DmitriyKalashnikov1/VKR/3d/Sopromat/ice_screenshot_20250330-104904.png

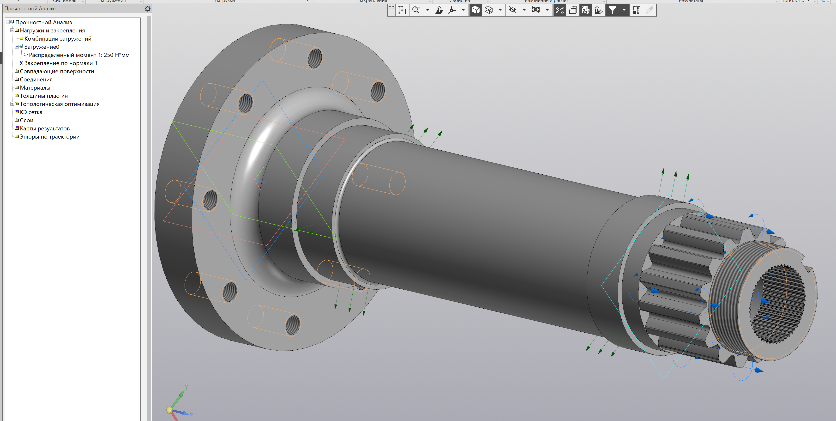
3d/Sopromat/ice_screenshot_20250330-104904.png
