DmitriyKalashnikov1/VKR/дополнительные ссылки.docx

1. Каталог моторов и приводов компании MaxsonMotors, - Режим доступа: https://www.maxongroup.com/maxon/view/catalog/, свободный (дата обращения: 22.10.23);
2. Каталог бесколлекторных моторов компании GoldenMotor, - Режим доступа: https://goldenmotor.ru/bldc-motors/motors/, свободный (дата обращения: 22.10.23);
3. Каталог мотор-колес на AliExpress, - Режим доступа: https://aliexpress.ru/wholesale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 (https://aliexpress.ru/wholesale?g=y&page=1), свободный (дата обращения: 22.10.23);
4. Описание товара ‘Комплект мотор-колесо Magic Pie-5, 16"’, - Режим доступа: https://goldenmotor.ru/motor-kolyosa/magic-pie-5/komplect-magic-pie-5-16inch/?oid=7175, свободный (дата обращения: 24.10.23);
5. Файл “Комплект мотор-колесо Magic Pie-5, 16" Руководство пользователя”, -- Режим доступа: https://goldenmotor.ua/files/Magic-Pie-5-Kit-Users-Guide_Rus_ver2.pdf, свободный (дата обращения: 24.10.23);
