DmitriyKalashnikov1/VKR/Литература-тау.docx

# Список использованной литературы и источников

1. Статистика ВОЗ «Инвалидность» [Электронный ресурс].- Режим доступа:https://www.who.int/ru/news-room/fact-sheets/detail/disability-and-health, свободный (дата обращения: 02.10.2023);
2. Статья «Инвалидность в России и в мире в цифрах» [Электронный ресурс].- Режим доступа: https://tiflocentre.ru/stati/statistika-po-invalidnosti.php, свободный (дата обращения: 02.10.2023);
3. Сайт Росстата [Электронный ресурс]. - Режим доступа: https://rosstat.gov.ru/folder/13964, свободный (дата обращения: 02.10.2023);
4. Статистика ВОЗ «Заболевания опорно-двигательного аппарата» [Электронный ресурс].- Режим доступа:https://www.who.int/ru/news-room/fact-sheets/detail/musculoskeletal-conditions, свободный (дата обращения: 02.10.2023);
5. Статистический сборник «ОСНОВНЫЕ ЭКОНОМИЧЕСКИЕ ПОКАЗАТЕЛИ ТРАНСПОРТА И СВЯЗИ», $2 “СОСТОЯНИЕ ЗДОРОВЬЯ НАСЕЛЕНИЯ”, табл. 2.67. [Электронный ресурс] – Режим доступа: https://rosstat.gov.ru/storage/mediabank/Zdravoohran-2021.pdf , свободный (дата обращения: 02.10.2023).
6. Сайт товаров для здоровья “medyard.ru” [Электронный ресурс]. - Режим доступа: https://medyard.ru/invalidnye-kolyaski/invalidnye-kolyaski-s-elektroprivodom/elektrokolyaski-stupenkokhody, свободный (дата обращения: 02.10.2023);
7. Сайт компании “Catewill” [Электронный ресурс]. – Режим доступа: https://caterwil.ru/product/ свободный (дата обращения: 02.10.2023);
8. Сайт компании “Обсервер” [Электронный ресурс]. – Режим доступа: https://o-mp.ru/ свободный (дата обращения: 02.10.2023);
9. Видео “Сравнение Caterwil Ultra 4WD и 4WD - Обзор электроколясок вездеходов” [Электронный ресурс]. - Режим доступа: https://www.youtube.com/watch?v=DE2Fb7_OeA0 , свободный (дата обращения: 02.10.2023);
10. Характеристики Caterwil Ultra 4WD [Электронный ресурс]. – Режим доступа: https://caterwil.ru/product/elektrokolyaska-caterwil-ultra-4wd/, свободный (дата обращения: 02.10.2023);
11. Характеристики Observer Проходимец [Электронный ресурс]. – Режим доступа: https://supportshop.ru/invalidnye-kolyaski-s-elektroprivodom/invalidnye-kolyaski-s-elektroprivodom-dlya-ulicy/kreslo-kolyaska-s-elektroprivodom-observer-prokhodimets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, свободный (дата обращения: 02.10.2023);
12. Обзор коляски Observer Проходимец [Электронный ресурс]. – Режим доступа: https://www.youtube.com/watch?v=gqXrreGPLkg, свободный (дата обращения: 02.10.2023);
13. Обзор коляски Caterwil GTS4 Lux [Электронный ресурс]. – Режим доступа: https://www.youtube.com/watch?v=uTOumZUHmyU, свободный (дата обращения: 02.10.2023);
14. Характеристики коляски Caterwil GTS4 Lux [Электронный ресурс]. – Режим доступа: https://caterwil.ru/product/kolyaska-transformer-caterwil-gts4/, свободный (дата обращения: 02.10.2023);
15. Видео “Противостояние колясок вездеходов Observer против Caterwil” [Электронный ресурс]. - Режим доступа: https://www.youtube.com/watch?v=-5qy4OKOLZg, свободный (дата обращения: 02.10.2023);
16. Официальный сайт компании “Ottobock” [Электронный ресурс]. - Режим доступа: https://corporate.ottobock.com/en/home, свободный (дата обращения: 02.10.2023);
17. Сайт товара “Otto Bock c1000 DS” в российском магазине-дистрибьюторе [Электронный ресурс]. - Режим доступа: https://ottobock-mobility.ru/catalog/adult-wheelchairs/kresla-kolyaska-s-elektroprivodom/c1000ds-invalidnaya-kolyaska-s-elektroprivodom/, свободный (дата обращения: 02.10.2023);
18. Видео “Обзор на электро-коляску OTTO bock C1000 DS” [Электронный ресурс]. - Режим доступа: https://www.youtube.com/watch?v=i4LTlZDc5MA, свободный (дата обращения: 02.10.2023);
19. Видео “Отзыв Otto Bock c1000 DS” [Электронный ресурс]. - Режим доступа: https://www.youtube.com/watch?v=z9F7g4K-WkQ, свободный (дата обращения: 02.10.2023);
20. Сайт товара “Otto Bock Juvo B5” в российском магазине-дистрибьюторе [Электронный ресурс]. - Режим доступа: https://ottobock-mobility.ru/catalog/adult-wheelchairs/kresla-kolyaska-s-elektroprivodom/invalidnaya-kolyaska-s-elektroprivodom-juvo-konfiguratsiya-b5/, свободный (дата обращения: 02.10.2023);
21. Видео “Наконец то я ее дождался! Ottobock juvo b5 в конфигурации InvaТема!” [Электронный ресурс], - Режим доступа: https://www.youtube.com/watch?v=Ajn11AZVl4Q, свободный (дата обращения: 02.10.2023);
22. Видео “ Моя новая основная электроколяска Ottobock juvo B5” [Электронный ресурс], - Режим доступа: https://www.youtube.com/watch?v=LtA1TSr9jB8, свободный (дата обращения: 02.10.2023);
23. Раздел “О компании” сайта компании “Orctonica” [Электронный ресурс], - Режим доступа: https://ortonica.ru/company/, свободный (дата обращения: 02.10.2023);
24. Раздел “Электрические коляски” сайта компании “Orctonica” [Электронный ресурс], - Режим доступа: https://ortonica.ru/catalog/invalidnye_kolyaski/elektricheskie-kolyaski/, свободный (дата обращения: 02.10.2023);
25. Страница товара “Orctonica Pulse 270” [Электронный ресурс], - Режим доступа: https://ortonica.ru/catalog/invalidnye_kolyaski/elektricheskie-kolyaski/1414/, свободный (дата обращения: 02.10.2023);
26. Страница товара “Ortonica Pulse 770” [Электронный ресурс], - Режим доступа: https://ortonica.ru/catalog/invalidnye_kolyaski/elektricheskie-kolyaski/536/, свободный (дата обращения: 02.10.2023);
27. Видео-обзор “ELECTRIC WHEELCHAIR Тест Ortonica Pulse 770 (Зимние условия)” [Электронный ресурс], - Режим доступа: https://www.youtube.com/watch?v=iNUhCidfzpY, свободный (дата обращения: 02.10.2023);
28. Видео-обзор “ELECTRIC WHEELCHAIR Тест Ortonica pulse 770 Дополнение” [Электронный ресурс], - Режим доступа: https://www.youtube.com/watch?v=7Ww4NHx1mHw, свободный (дата обращения: 02.10.2023);
29. Видео-обзор “Электроколяска на независимой подвеске Тест Caterwil Ultra”, - Режим доступа: https://www.youtube.com/watch?v=wiukjdVkpcY, свободный (дата обращения: 14.10.2023);
30. Справочник коэффициентов трения качения для разных материалов, - Режим доступа: https://dpva.ru/Guide/GuidePhysics/Frication/FrictionOfRolling/, свободный (дата обращения: 071123);
31. Каталог моторов Fulling motor на сайте поставщика Inodrive, - Режим доступа: https://innodrive.ru/catalog/fulling-motor/, свободный (дата обращения: 101123);
