DmitriyKalashnikov1/VKR/Мат моделирование/Расчет и подбор электродвигаттеля полный для мальчикова — копия.docx

МИНОБРНАУКИ РОССИИ

Федеральное государственное бюджетное образовательное

учреждение высшего профессионального образования

«Юго-Западный государственный университет»

(ЮЗГУ)

Кафедра механики, мехатроники и робототехники

Мощностной и проверочный расчет электропривода

мехатронного устройства

Вариант 7

Выполнил: cт.гр. МТ11-Б Калашников Д. А.

Проверил: доц. Мальчиков А. В.

Курск 2023

Для того, чтобы рассчитать мощность электродвигателей сначала нужно выбрать из всех режимов работы устройства самый нагруженный. Самый нагруженный режим работы для коляски это режим прямолинейной езды. Для расчета данного режима упростим коляску до модели колеса, катящегося вперед со скоростью из ТЗ (5-10 км/ч). Расчетная схема этого режима показана на рис.1.


Рис.1. Расчетная сила основного режима

Составим уравнения динамики относительно центра колеса:

{, mx=Ftr, J_o φ=Md-Mtrc-Ftr*R. (2.1)

В последней формуле: Mtrc – момент трения скольжения (находится как Mtrc=mg*δ , где δ – коэффициент трения скольжения – 0.01 м в нашем случае [30], m—масса коляски (200 кг)), R – радиус колеса (0.15 м в нашем случае), ε=φ=x/R – угловое ускорение колеса, mk – масса колеса, J_o – момент инерции относительно центра колеса.

По ТЗ линейная максимальная скорость коляски составляет 10 (км)/ч . Пересчитывая это в метры в секунду получим u=2.778 м/c линейной скорости. Разделив это на радиус колеса найдем его угловую скорость ω=18.519 (рад)/с . Время разгона возьмем t=5 c . Значит угловое ускорение составит ε=ω/t=3.7 (рад)/(c^2) . Массу колеса mk примем 1 кг. Момент инерции относительно центра колеса найдем так: J_o =(mk*r^2)/2.

Учитывая все эти данные, найдем момент силовой установки:

J_0 φ=Md-mg*δ-mxr; (2.2)
Md=0.5mk*r^2 φ+mg*δ+mxr. (2.3)

Откуда:

Md=0.5*1*0.15^2 *3.7+2000*0.01+200*2.778/5*0.15=36.7 (Н*м).

Зная теперь момент силовой установки и угловую скорость колеса, найдем нужную расчетную мощность:

Nd=Md*ω=680.17 (Вт).

Учтя коэффициент запаса мощности 1.2 и КПД передачи в 0.65 посчитаем реальную требуемую мощность силовой установки коляски:

Ndreal= 1.2(Nd)/0.65=1256 (Вт).

Зная мощность силовой установки всей коляски, найдем мощность одного мотора, разделив Ndreal на количество моторов – 6:

Nm=(Ndreal)/6=209.28 (Вт).

Проверим хватит ли это мощности для заезда на пандусы с углом наклона 30⁰. Расчетная схема для этого показана на рис. 2.


Рис.2. Расчетная схема для подъема по пандусам

Составим уравнения динамики относительно центра колеса:

{, mx=Ftr-mgsin(a), J_o φ=M-Mk-Ftr*R. (2.4)

В формуле (2.4) α – угол подъема пандуса. Mk – момент трения ( Mk=mgcos(a)*δ ), М—момент двигателя. Выразив силу трения из первого уравнения (2.4) получим:

Ftr=mx+mgsin(a). (2.5)

Подставив (2.5) во второе уравнение (2.4) и выразив оттуда момент электродвигателя, получаем:
M=J_o φ+mgcos(a)*δ+(mx+mgsin(a))R. (2.6)

По ТЗ линейная скорость коляски в данном режиме составляет 0.5 (км)/ч . Пересчитывая это в метры в секунду получим u=x=0.14 м/c линейной скорости. Разделив это на радиус колеса найдем его угловую скорость ω=0.93 (рад)/с . Время разгона возьмем t=5 c . Значит угловое ускорение составит ε=ω/t=φ=0.028 (рад)/(c^2) . Массу колеса mk примем 1 кг. Момент инерции относительно центра колеса найдем так: J_o =(mk*r^2)/2. Угол подъема пандуса по ТЗ α=30° .

Учитывая все эти данные, найдем момент силовой установки:
M=0.5*1*0.15^2 *0.028+2000*0.01*cos(α)+(200*0.14+2000*sin(α))*0.15=168.2 (Н*м) . (2.7)

Умножив найденный момент на номинальную угловую скорость этого режима, найдем расчетную мощность силовой установки в данном режиме:

N=M*ω=155.7 (Вт).

Учтя коэффициент запаса мощности 1.2 и КПД передачи в 0.65 посчитаем реальную требуемую мощность силовой установки коляски:

N_real= 1.2N/0.65=288 (Вт).

Зная мощность силовой установки всей коляски, найдем мощность одного мотора, разделив N на количество моторов – 6:

N1=(N_real)/6=48 (Вт).

N1<Nm , значит мощности, рассчитанной для прямолинейной езды хватит

(да еще и с лихвой) для подъема на расчетный угол пандуса.

Учитывая, что найденный M – момент силовой установки, найдем момент, приходящийся на один двигатель:

M1=M/6=28 (Н*м).

Расчет мощности двигателя подъема шасси будем производить в режиме подъема на ступеньку в транспорт. В этом режиме требуется поднять центральные колеса. Примем допущение, что переднее колесо прочно зацепилось за край ступени. Расчетная схема для этого режима показана на рис.3.

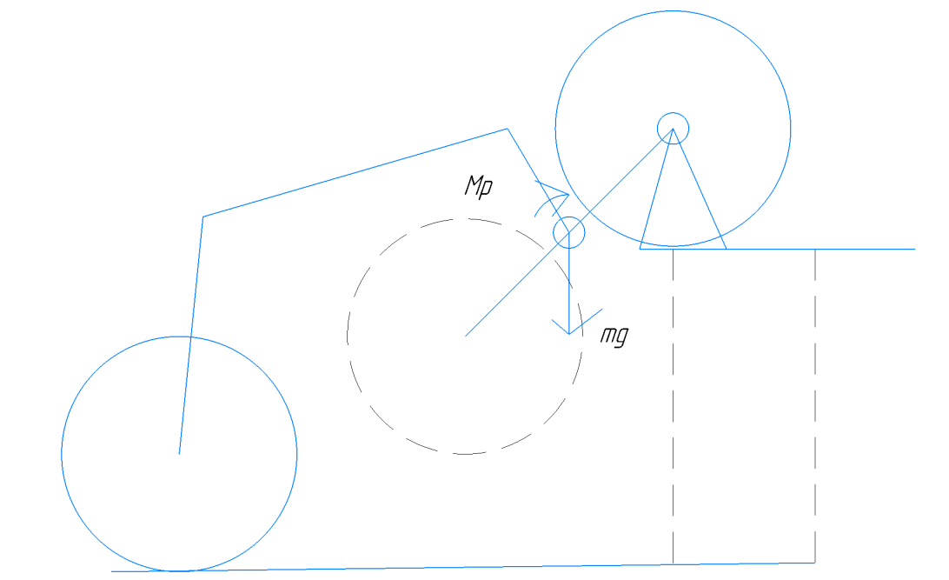
[picture p8: figure]

Рис.3. Схема расчета мощности мотора поднятия шасси

Составим сумму моментов относительно края ступеньки (по факту получим, что мотору подъемника шасси надо поднять половину веса на половине длинны балки между колесами):

Mp=0.25*l1*mg,

, где l1 = 375 мм – длина балки между колесами передней шасси.

Подставив значения, получим:

Mp=0.25*0.375*2000=187.5 (Н*м).

Зная этот момент и нужную угловую скорость для подъема ( ω=0.1 рад/c ), найдем нужную мощность:

Np=Mp*ω=18.75 (Вт).

С учетом коэффициента запаса 1.2 и КПД передачи в 0.35, рассчитаем итоговую мощность данного двигателя:

Npreal=1.2(Np)/0.35=64.3 (Вт).

Момент на один двигатель для данного режима Mp1=(Mp)/2=93,75 (Н*м).

По номинальному моменту для мотора колес нам подходит мотор из каталога фирмы Fulling motors. Внешний вид этого мотора показан на рис.4, а его параметры показаны в Табл.2.1.

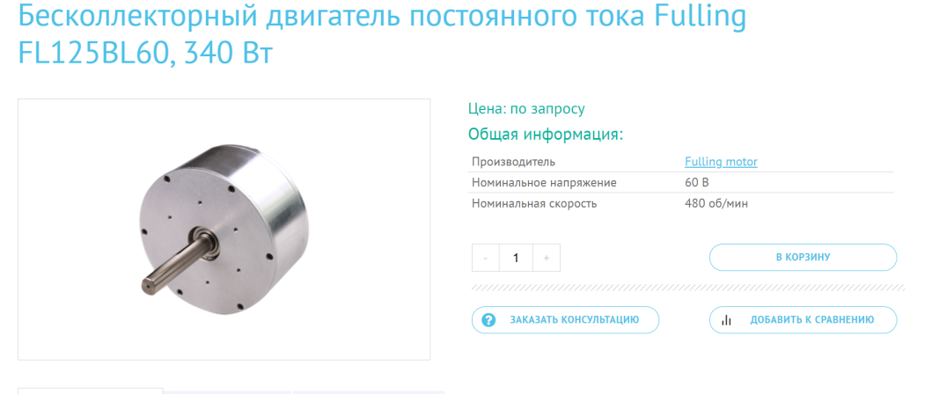
[picture p9: figure]

Рис. 4. Мотор колес

Табл.2.1. Параметры двигателя колес

Параметр (обозначение) | Значение
Сопротивление якоря ( R_я ) | 1.1 Ом
Индуктивность якоря ( L_я ) | 2.4* 10^(-3) Гн
Момент инерции двигателя (J) | 0.00021 Кг* м^2
Номинальное напряжение ( U_н ) | 60 В
Номинальная угловая скорость ( ω_н ) | 480 rpm = 50.2 (рад)/с
Номинальный крутящий момент ( M_н ) | 6 .8 Н*м
Номинальный ток ( I_н ) | 5.7 А
C_m | 1.19 (Н*м)/А
C_e | 1.2 (В*с)/(рад)

Для подъемного механизма шасси был выбран привод AK80-64 6-8S от компании Tmotor. Внешний вид этого двигателя показан на рис. 5, а параметры данного двигателя показаны в Табл. 2.2.


Рис.5. Мотор для механизма подъема шасси

Табл.2.2. Параметры двигателя подъема шасси

Параметр (обозначение) | Значение
Сопротивление якоря ( R_я ) | 0.22 Ом
Индуктивность якоря ( L_я ) | 0.86* 10^(-3) Гн
Момент инерции двигателя (J) | 0.0001335 Кг* м^2
Номинальное напряжение ( U_н ) | 24 В
Номинальная угловая скорость ( ω_н ) | 23 rpm = 2.4 (рад)/с
Номинальный крутящий момент ( M_н ) | 48 Н*м
Пиковый крутящий момент ( M_(max) ) | 120 Н*м
Номинальный ток ( I_н ) | 19 А
C_m | 4.9 (Н*м)/А
C_e | 10 (В*с)/(рад)

Номинальные параметры скоростей вращения и выдаваемого момента у двигателя колеса не соответствуют требуемым, поэтому необходимо подобрать соответствующие редуктор.

Рассчитаем нужное передаточное отношение редуктора:

i=50/18.5=2.7

После поиска на сайте компании Инодрайв был найден следующий редуктор (Рис. 6):

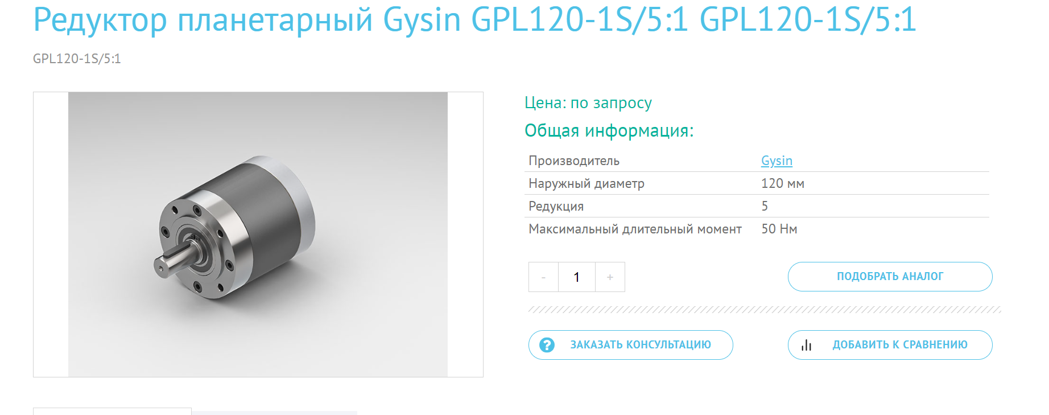
[picture p10: figure]

Рис.6. Колесный редуктор

Его параметры: i_r =5;M_n =50 Н*м; η=0.9. Проверим, будут ли соответствовать параметры движения расчетным:
M^(') =M_(дв) *i*η=6.8*5*0.9=30,6; ω^(') =(ω_н)/5=10.04(рад)/c.

Полученная угловая скорость меньше расчетной, что позволит коляске развивать скорость всего 5-6 км в час, это меньше планируемой скорости, но такая скорость еще проходит в условия ТЗ, поэтому, поскольку полученный момент больше чем момент подъема на пандус M1, результаты выбора и расчетов удовлетворительны.
