DmitriyKalashnikov1/VKR/Мат моделирование/Глава 4 тау блок формирования задающих воздействий.docx

# 4. Алгоритм блока формирования задающих воздействий

Алгоритм блока формирования задающих воздействий разделен на две крупные части: ручное управление с автоматическим детектированием препятствий при обычной езде, а также режим заезда в общественный транспорт. Рассмотрим каждый режим более подробно.

Первым рассмотрим режим ручного управления. Так как у нас относительно малое число колес (всего 6), то удобнее всего будет использовать танковую схему управления, при которой φ_1 =φ_2 =φ_3 =φ_r , φ_4 =φ_5 =φ_6 =φ_l (рис. 4.1).

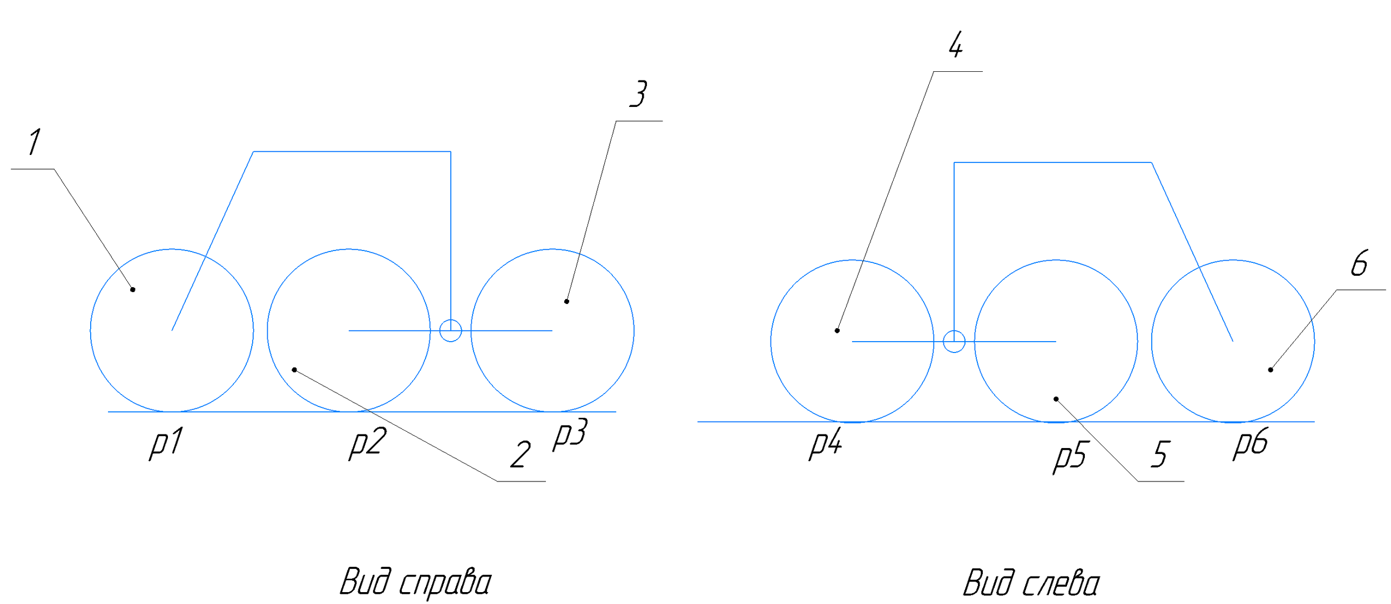
[picture p11: figure]

Рис.4.1. Звенья механизма, участвующие в режиме работы 1

При условии отсутствия проскальзывания в точках контакта колес ( v_(p_i) =0;i=1 .. 6 ), моменты на электродвигателях колес равны ( M_(d1) =M_(d2) =M_(d3) =M_(dr) ; M_(d4) =M_(d5) =M_(d6) =M_(dl) ), и динамика робота описывается двумя уравнениями (2.2) для левой и правой сторон робота:

{, J_0 φ_l =M_(dl) -0.5mg*δ-0.5mx_l r, J_0 φ_r =M_(dr) -0.5mg*δ-0.5mx_r r (4.1)

, где δ – коэффициент трения скольжения – 0.01 м в нашем случае [30], m—масса коляски (200 кг)), r – радиус колеса (0.15 м в нашем случае), ε=φ=x/R – угловое ускорение колеса, J_o – момент инерции относительно центра колеса (находится по формуле J_o =(mk*r^2)/2 , где mk – масса колеса).

В формуле (4.1) входными параметрами (с учетом того, что φ_l =(x_l)/r ), является вектор линейных скоростей колес [x_r x_l ] , который связан с передвижением устройства с помощью уравнений кинематики робота с дифференциальным приводом. Чтобы иметь возможность по заданной ориентации робота в пространстве находить необходимый вектор скоростей, сначала решим задачу прямой кинематики (выведем формулы для нахождения ориентации по заданным скоростям колес), а после найдем выражения, которые позволят по ориентации находить скорости колес.

Введем допущение, что движение робота происходит в двумерной плоскости по ровной поверхности, тогда местонахождение и направление движение робота с дифференциальным приводом в глобальной системе координат задается вектором [x_a y_a θ] , так как это показано на рис.4.2.

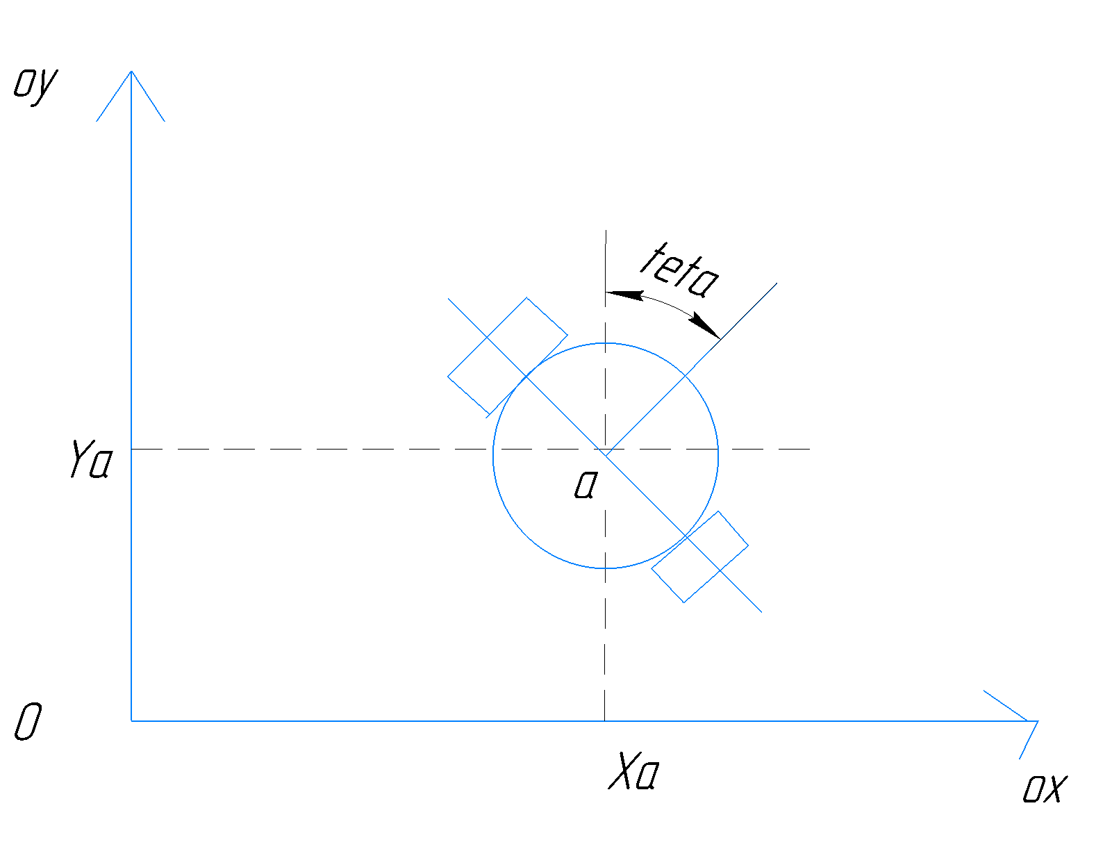
[picture p12: figure]

Рис.4.2. Обозначение положения и направления робота в глобальной системе координат

На рис. 4.2 x_a – координата центра масс а робота по оси ox, y_a – координата центра масс а робота по оси оy, θ – направление движения робота.

Чтобы обеспечивать желаемое направление движения, робот должен будет поворачивать вокруг особой точки, находящейся на оси, совпадающей с осью вращения ведущих колес. Эта точка находится за пределами робота и называется мгновенным центром кривизны траектории (instantaneous center of curvature или ICC). Поворот будет осуществляться с некоторой угловой скоростью ω . Расчетная схема данной угловой скорости и радиуса кривизны траектории робота R_t показана на рис.4.3.

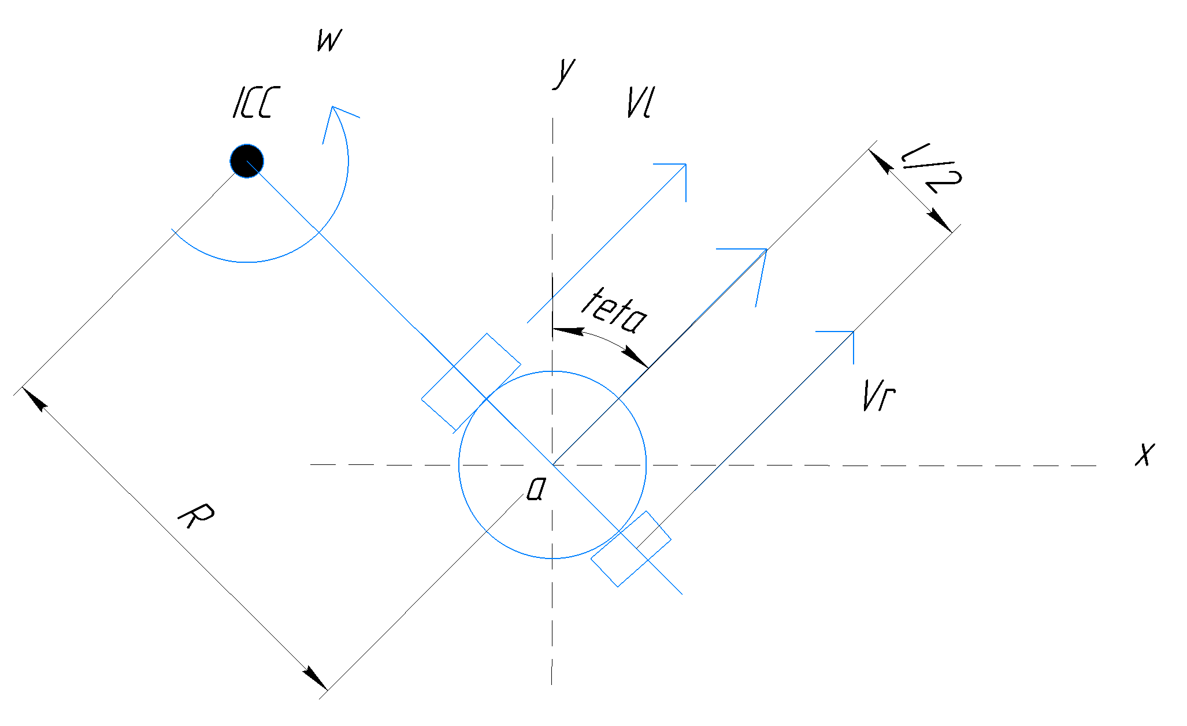
[picture p13: figure]

Рис. 4.2. Расчетная схема для угловой скорости поворота и радиуса кривизны траектории

На данной схеме l – длина оси колес, а R=R_t – радиус кривизны траектории, то есть расстояние между центром робота и точкой ICC.

Применив уравнение связи между линейной и угловой скоростями получим следующую систему выражений для скорости поворота робота:

{, ω(R+l/2)=Vr, ω(R-l/2)=Vl. (4.2)

Преобразовав выражение (4.2), получим систему для определения угловой скорости поворота и радиуса кривизны траектории:

{, R_t =l/2*(Vl+Vr)/(Vr-Vl), ω=(Vr-Vl)*l. (4.3)

Уравнения из систем (4.2) и (4.3) нам нужны для вывода формул для определения положения робота и его направления по скоростям его колес. Предположим, что робот движется с некоторой угловой скоростью в течение Δt секунд (рис.4.3).

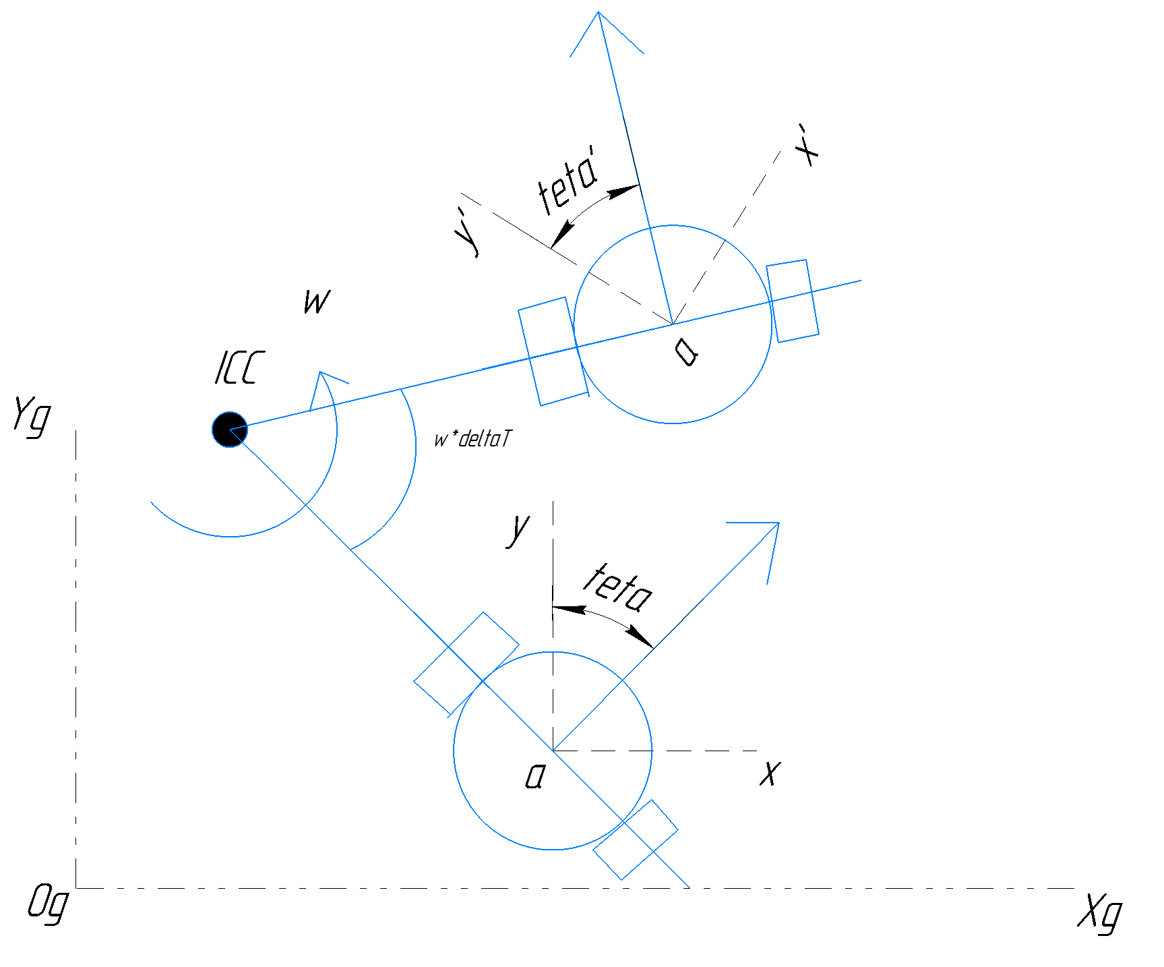
[picture p14: figure]

Рис.4.3. Поворот робота вокруг точки ICC за время Δt в глобальных координатах (Xg, Yg)

По рис.4.3 видно, что новое направление движения робота θ' будет находится так:

θ^(') =θ+ω*Δt . (4.4)

Положение точки ICC описывается следующим вектором:

ICC=[ICC_x ICC_y ]=[x-Rsinθy+Rcosθ] . (4.5)

С учетом стартовой позиции (x, y) новое положение робота (x’, y’) может быть получено с помощью 2D-матрицы вращения. Учитывая движение робота с угловой скоростью ω в течение Δt секунд относительно точки ICC, мы получаем следующую позицию для времени t+ Δt :

(x^(') y^(') )=(cos(ωΔt), -sin(ωΔt)sin(ωΔt), cos(ωΔt))(x-ICC_x y-ICC_y )+(ICC_x ICC_y ). (4.6)

Если мы еще добавим в вектор (4.6) выражение для нахождения нового направления движения (4.4), то получим такую векторно-матричную формулу нахождения вектора нового положения робота:

(x^(') y^(') θ^(') )=(cos(ωΔt), -sin(ωΔt), 0sin(ωΔt), cos(ωΔt), 00, 0, 1)(x-ICC_x y-ICC_y θ)+(ICC_x ICC_y ωΔt) (4.7)

Подставляя в выражение (4.7) значения ω, R, ICC из выражений (4.3) и (4.5), мы сможем по текущей линейной скорости колес найти текущее положение робота и направление движения. Надо еще сказать, что измерять требуемую линейную скорость достаточно проблематично, поэтому в реальном устройстве эти данные будут вычисляться по показаниям энкодеров, установленных во всех приводах робота, по такой формуле:

V=(n*step)/(Δt) (4.8)

, где n – количество импульсов энкодера, поступивших за время Δt , step – длина дуги одного шага энкодера.

Таким образом, выражения (4.3), (4.5), (4.7) и (4.8) образуют модель прямой кинематики рассматриваемого режима.

Теперь, зная формулы для прямой кинематики, найдем выражения для обратной. Для этого нужно преобразовать выражение (4.7), выполнив в нем все арифметические операции:

(x^(') y^(') θ^(') )=(cos(ωΔt), -sin(ωΔt), 0sin(ωΔt), cos(ωΔt), 00, 0, 1)(x-ICC_x y-ICC_y θ)+(ICC_x ICC_y ωΔt)= (cos(ωΔt)*(x-ICC_x )-sin(ωΔt)*(y-ICC_y )sin(ωΔt)*(x-ICC_x )+cos(ωΔt)(y-ICC_y )θ)+(ICC_x ICC_y ωΔt)= (cos(ωΔt)*(x-ICC_x )-sin(ωΔt)*(y-ICC_y )+ICC_x sin(ωΔt)*(x-ICC_x )+cos(ωΔt)(y-ICC_y )+ICC_y θ+ωΔt). (4.9)

Следующим шагом подставим выражение для определения вектора ICC (4.5):

(x^(') y^(') θ^(') )=(-cos(ωΔt)*(Rsinθ)-sin(ωΔt)*(Rcosθ)+x-Rsinθ-sin(ωΔt)*(Rsinθ)+cos(ωΔt)(Rcosθ)+y+Rcosθθ+ωΔt). (4.10)

Мы получили рекуррентные выражения для определения нового вектора положения робота с учетом его положения в прошлый момент времени, а также расстояния R до точки ICC и угловой скорости поворота робота вокруг точки ICC ω . А эти величины в свою очередь позволят в свою очередь с помощью формул (4.2) определить искомые Vl, Vr . Для того, чтобы выразить ω, R , вычтем из текущего положения робота ( x’, y’, θ' ) его положение в предыдущий отрезок времени ( x, y, θ ):

{, (x’-x)=-cos(ωΔt)*(Rsinθ)-sin(ωΔt)*(Rcosθ)-Rsinθ, (y’-y)=-sin(ωΔt)*(Rsinθ)+cos(ωΔt)(Rcosθ)+Rcosθ, (θ^(') -θ)=ωΔt. (4.11)

Уравнение 3 из системы (4.11) легко позволяет получить искомую угловую скорость поворота робота:

ω=((θ^(') -θ))/(Δt). (4.12)

C учетом выражения (4.12), оставшиеся два выражения в (4.11) можно будет перезаписать в таком виде:

{, (x’-x)=-cos(θ^(') -θ)*(Rsinθ)-sin(θ^(') -θ)*(Rcosθ)-Rsinθ, (y’-y)=-sin(θ^(') -θ)*(Rsinθ)+cos(θ^(') -θ)(Rcosθ)+Rcosθ. (4.13)

Найти радиус кривизны траектории R из одного из двух уравнений (4.13) (например, из уравнения для у-ов) не составит труда:

R=((y’-y))/(cos(θ^(') -θ)cos(θ)+cos(θ)-sin(θ^(') -θ)*sin(θ)) (4.14)

Подставив уравнения (4.12) и (4.14) в выражения (4.2) получим искомые зависимости линейных скоростей колес от положений робота в настоящий момент времени ( x, y, θ ), желаемого положения робота в следующий момент времени ( x', y^(') , θ' ), геометрических параметров робота и отрезка времени Δt , за который робот должен совершить перемещение из ( x, y, θ ) в ( x', y^(') , θ' ):

V_r (x, y, θ,x^(') , y^(') , θ^(') , l, Δt)= =((θ^(') -θ))/(Δt)*(((y’-y))/(cos(θ^(') -θ)cos(θ)+cos(θ)-sin(θ^(') -θ)*sin(θ))+l/2); (4.15)

V_l (x, y, θ,x^(') , y^(') , θ^(') , l, Δt)= =((θ^(') -θ))/(Δt)*(((y’-y))/(cos(θ^(') -θ)cos(θ)+cos(θ)-sin(θ^(') -θ)*sin(θ))-l/2). (4.16)

Подставив уравнения (4.15) и (4.16) в выражения из (4.2), можно найти суммарные моменты двигателей для каждой из сторон робота ( M_(dl) , M_(dr) ), который требуются для достижения необходимой скорости. Разделив значение суммарного момента для одной стороны на 3, получим моменты, требуемые от каждого двигателя одной стороны ( M_i ;i=1..6 ). А зная M_i ;i=1..6 и номинальную мощность одного двигателя колес (рассчитанную в разделе 2), можно легко найти желаемые угловые скорости каждого колеса ω_i^(') ;i=1..6 , которые затем подаются на локальные контуры управления угловыми скоростями вращения двигателей, согласно рис.3.2.

Таким образом мы вывели уравнения ((4.2), (4.16)), с помощью которых по местоположению робота и его направлению можно высчитать необходимые параметры для двигателей. Осталось только понять, как с помощью джойстика задавать желаемое перемещение.

Рассмотрим сначала схемы конструкции джойстика и проекции рабочей области рукояти на плоскость Oxy (рис.4.4).

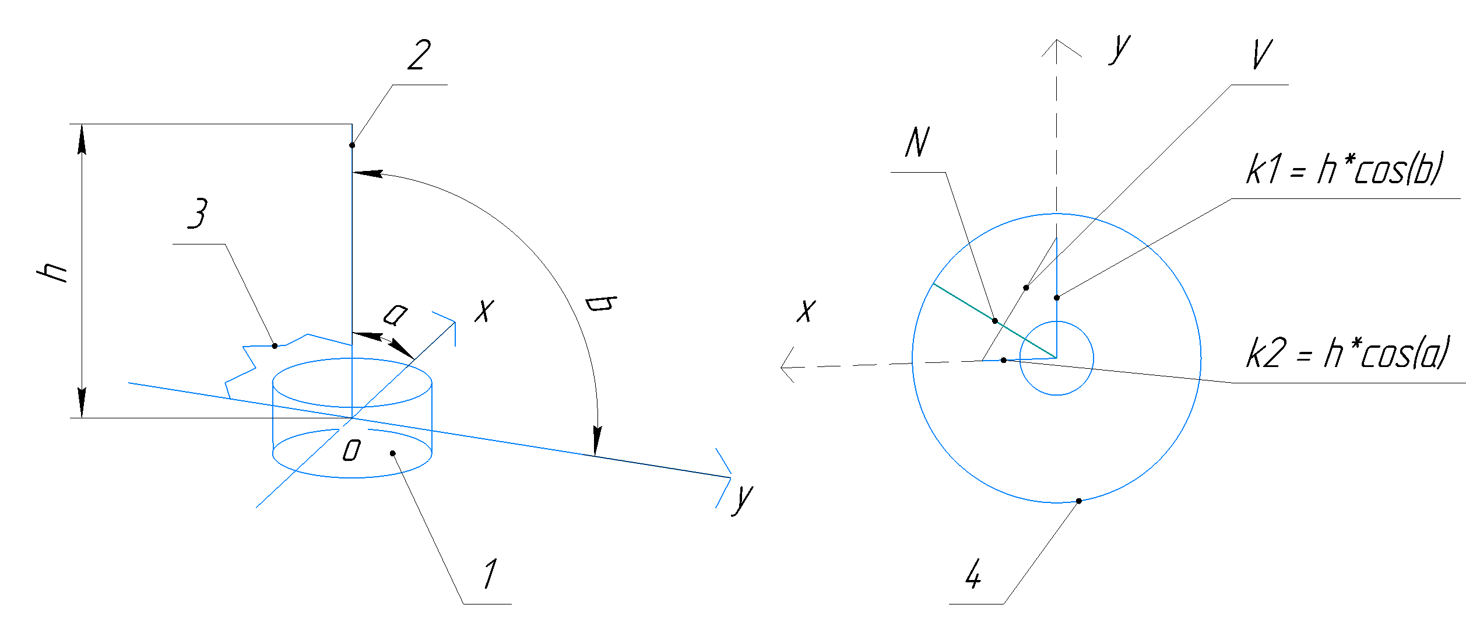
[picture p15: figure]

Рис.4.4. Схема конструкции джойстика и проекции рабочей области на плоскость Oxy

На рис.4.4 1 – основание джойстика, 2 – рукоять джойстика, 3 – возвратная пружина, k1 – проекция положения джойстика на ось Y, k2 – проекция положения джойстика на X, V – гипотенуза прямоугольного треугольника с катетами k1 и k2, N – радиус-вектор нового желаемого положения робота, α, β – углы отклонения джойстика от вертикали, h – высота джойстика.

Желаемое положение робота рассчитывается так:

1) Вычисляются две проекции ориентации джойстика на оси X и Y:

OX:k2=h*cos(α); (4.17) OY:k1=h*cos(β); (4.18)

2) Вычисляются гипотенуза V, а также угол между ней и проекцией на ось X:

V=√(k1^2 +k2^2); (4.19) γ=arccos(k2)/V; (4.20)

3) Найденный угол γ суммируется с углом ориентации робота θ и таким образом получается желаемая ориентация робота

θ^(') =θ+γ ; (4.21)

4) Вычисляем желаемые координаты x^(') , y' так:

x^(') =x+k1; (4.22) y^(') =y+k2; (4.23)

Таким образом, по формулам (4.17) – (4.23) рассчитывается вектор желаемого положения (x^(') y^(') θ^(') ) робота из вектора ориентации джойстика (αβ) .

А дальше вычисленный вектор желаемого положения подставляется в формулы ((4.1), (4.16)), из которых высчитываются параметры движения, подаваемые на приводы. Осталось только сказать, что САУ робота постоянно получает данные о расстояниях до препятствий с передней камеры, и если минимальное считанное расстояние будет меньше 200 мм, то, независимо от поступивших команд, вперед робот не поедет.

Теперь рассмотрим режим № 2, режим заезда на ступеньку в транспорт. Сначала рассмотрим полный алгоритм заезда (рис.4.5).

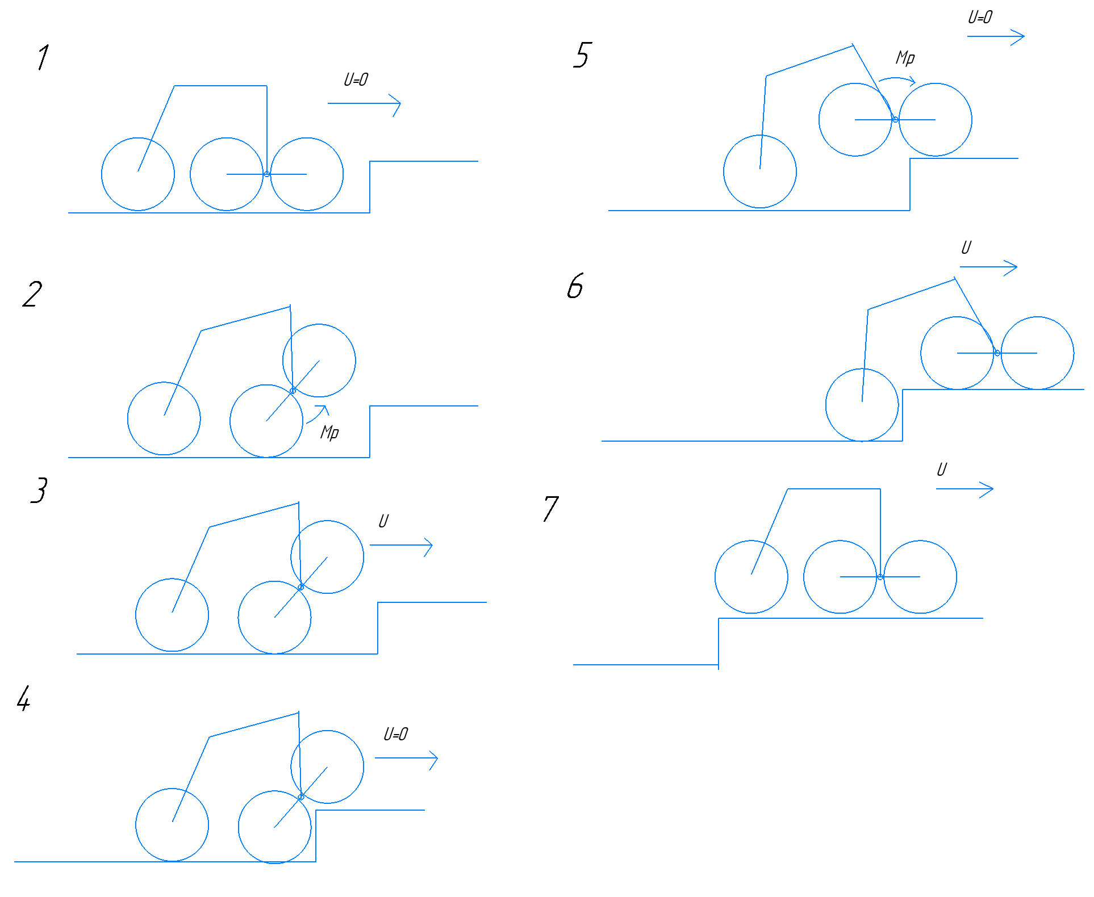
[picture p16: figure]

Рис.4.5. Алгоритм заезда в транспорт

На рис.4.5. позиция (1) обозначает подъезд робота ко входу в транспорт, на шаге (2) оператор останавливает движение робота и переводит тумблер управления подвеской в положение подъема передних колес, на шаге (3) оператор ближе подъезжает к ступеньке, так, чтобы переднее колесо находилось над ступенькой, на шаге (4) оператор останавливает движение робота, на шаге (5) оператор переводит с помощью тумблера управления подвеской выводит переднее шасси в горизонтальное положение, на шаге (6) робот под управлением оператора заезжает центральными колесами на ступеньку, на последнем шаге (7) робот, продолжая двигаться вперед, затягивает задние колеса на ступеньку.

На шагах (1), (6), (7) остается рабочей та математическая модель робота, сформированная формулами (4.1)-(4.23).

На шаге (2) кинематики нет, потому что робот стоит, а вся динамика сводится к расчетной формуле момента Mp:

Mp=0.25*l1*mg*sinφ_7 , (4.24)

где φ_7 – угол подъема шасси, l1 – длина балки между передними колесами.

Шаги (3), (4) и (5) характеризуется объединением формул (4.1)-(4.24), угол φ_7 можно будет задавать углом β при отсутствии движения коляски (и при соответствующем положении переключателя поведения шасси).

Схематичное изображение описанного выше алгоритма управления многоканальной САУ показано на рис. 4.6.

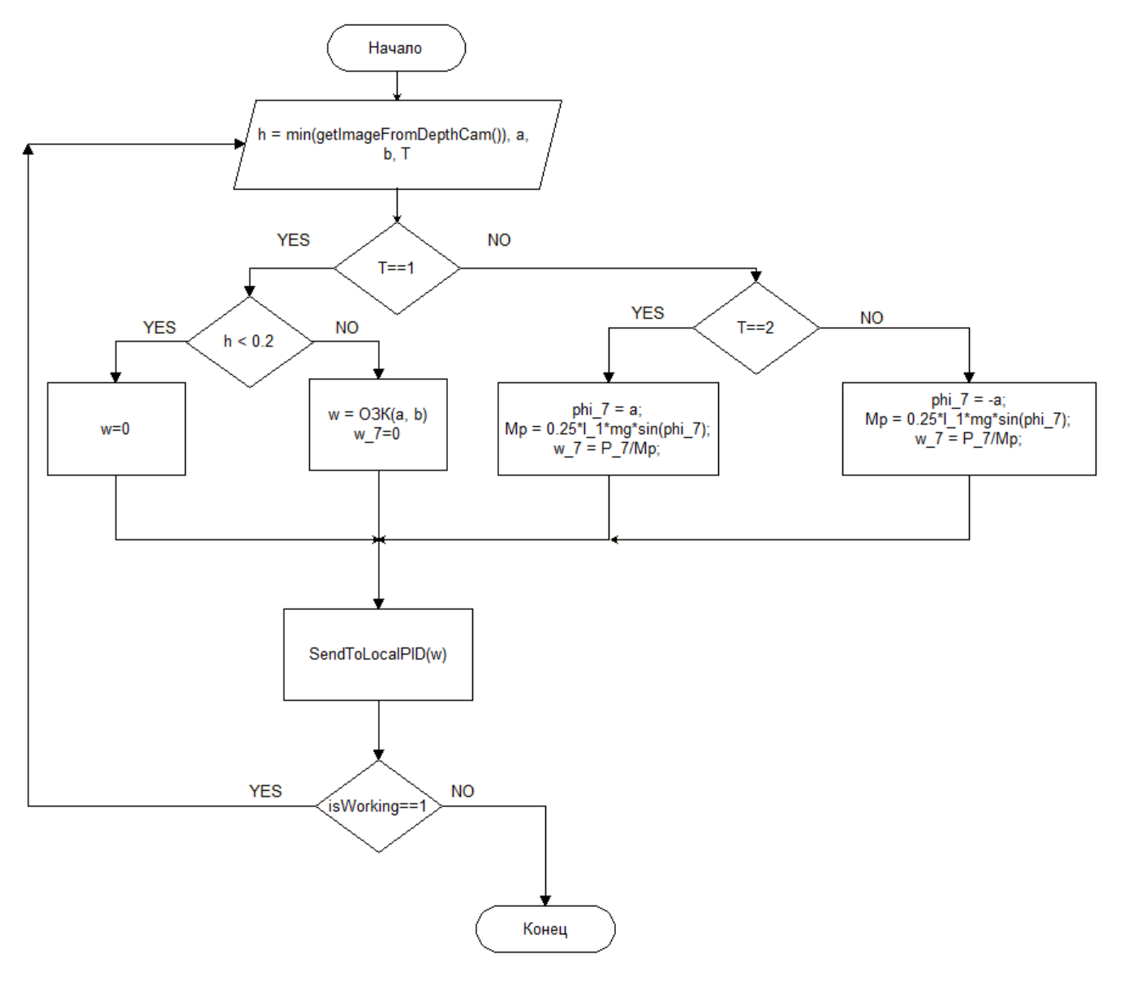
[picture p17: figure]

Рис.4.6. Блок-схема алгоритма управления многоканальной САУ

На данной схеме h – расстояние до препятствия, считанное с помощью getImageFromDepthCam() – функции получения карты расстояний с установленной спереди камеры глубины. Реализация данной функции зависит от выбранной камеры, поэтому ее в данной главе не рассматриваем. α и β – углы положения джойстика. Функция ОЗК(α,β) – функция, которая из углов положения джойстика по формулам (4.1)-(4.23) переводит считанные α и β в угловые скорости колес, а функция SendToLocalPID(ω) передает вычисленные значения угловых скоростей в локальные управляющие контуры всех приводов. Флаг isWorking показывает, включена ли еще коляска. Переменная T отвечает за показания тумблера переключения режима работы подвески шасси. P_7 – константа мощности двигателя подъема шасси.

Таким образом, в этой главе была выведена полная математическая модель робота, позволяющая описать движение робота, как при ручном управления, так и при траекторном методе управления. Также был подробно описал алгоритм работы блока формирования задающих воздействий, работающий поверх разработанной математической модели данного робота и составлена блок-схема данного алгоритма.

# Заключение

В данной курсовой работе была разработана система автоматического управления приводами роботизированной инвалидной коляски, удовлетворяющая параметрам, заданным в техническом задании. Были приведены функциональная и структурная схемы САУ, была проведена проверка на устойчивость по методам Найквиста, Михайлова и Гурвица, определен запас устойчивости по диаграммам Боде. Также была проведена оптимизация PID – регулятора САУ, как линейной, так и нелинейной. Кроме этого, САУ была исследована на робастность. Также был успешно настроен нечеткий регулятор для одного из типов приводов. Была рассмотрена многоканальная САУ, сформирована полная математическая модель данного робота, описывающая его передвижение во всех предусмотренных ТЗ режимах работы, подробно описан алгоритм работы данного аппарата.
