DmitriyKalashnikov1/VKR/Мат моделирование/Проектирование САУ.docx

# 3. Проектирование САУ

## 3.1. Функциональная схема устройства

В данной работе рассмотрим только режим ручного управления с возможностью подъема в транспорт, так как это основной режим работы данного устройства. За данный режим работы отвечает многопозиционный джойстик. Функциональная схема разрабатываемого устройства показана на рис.3.1.

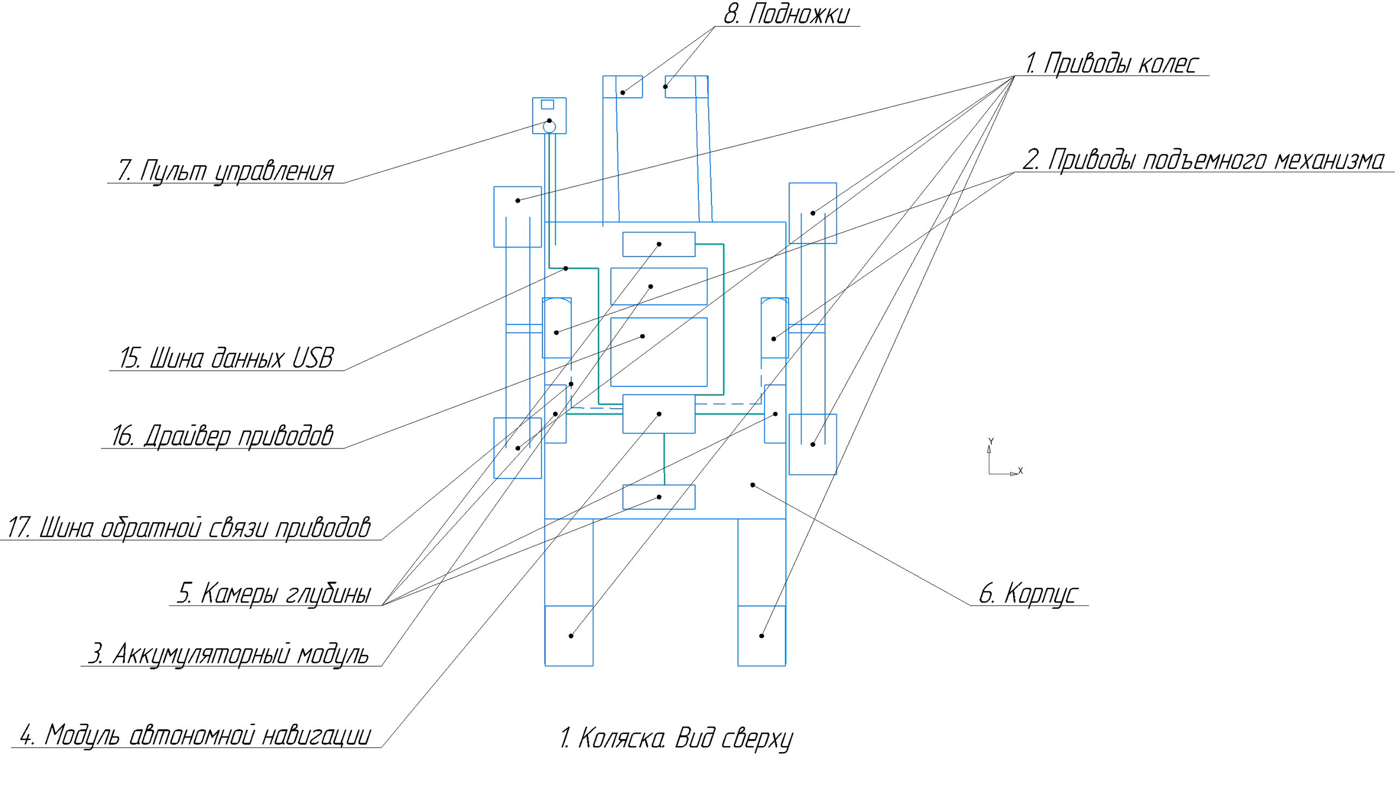
[picture p18: figure]
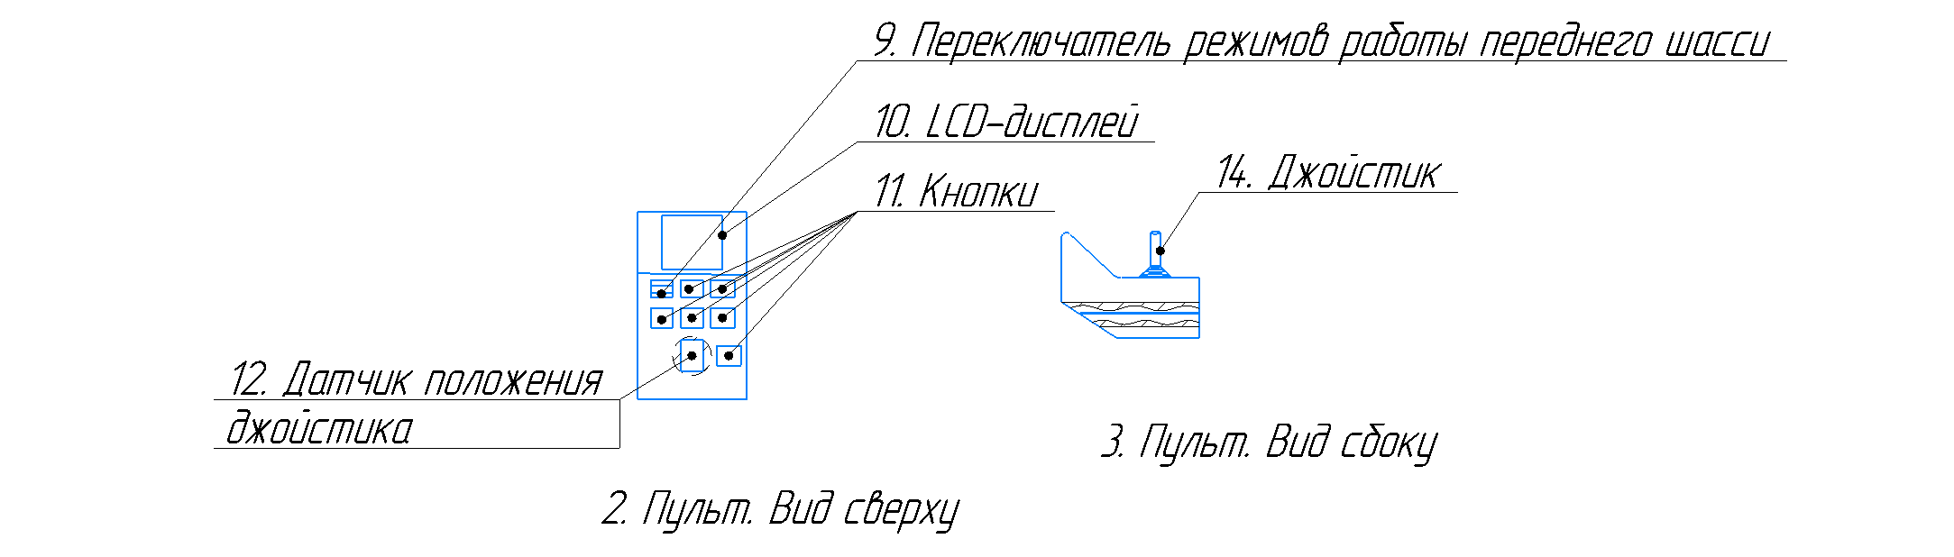
[picture p19: figure]

Рис. 3.1. Функциональная схема САУ коляски

В рассматриваемом режиме работы управление движением осуществляется с помощью пульта ручного управления 7. Пульт считывает магнитным датчиком 12 положение джойстика 14 преобразует полученные данные в значения ШИМ-сигналов, которые необходимо подать на приводы колес. Затем пульт отправляет вычисленные значения в драйвер приводов 16 через модуль автономной навигации 4, который при наличии препятствия спереди на расстоянии, меньшем чем 20 см, останавливает движение. Расстояние до препятствий определяется по показаниям камер глубины 5. Пульт ручного управления, камеры глубины и модуль автономной навигации соединены USB-шиной 15. На пульте кроме джойстика размещены кнопки управления устройством 11 и LCD-дисплей 10, а также трехпозиционный переключатель 9 управления режимом работы приводов подъемного механизма 2. На LCD-дисплее отображаются данные о текущем режиме работы устройства, его скорости и уровне заряда аккумуляторов. Скорость коляски вычисляется по данным с приводов колес 1, а уровень заряда считывается с датчика напряжения в аккумуляторном модуле 3. Данные о текущей скорости приводов колес передаются в модуль автономной навигации по шине информации обратной связи 17, также как и угол отклонения двигателей подъема шасси.

С помощью переключателя 9 можно включить один из трех режимов работы приводов подъема шасси:

1) режим свободного вращения, когда приводы отключены от питания, поэтому шасси свободно вращаются;
2) режим подъема шасси, при котором приводы поднимают шасси на заданный угол над землей;
3) режим подъема центральных колес, при котором приводы поднимают центральные колеса на заданный угол, вращаясь в противоположном режиму подъема шасси направлении.

Алгоритм функционирования рассматриваемого режима такой:

1) пока переключатель 9 находится в положении 1, коляска двигается как обычное транспортное средство (развороты осуществляются по танковой схеме);
2) как только пассажир доезжает до входа в транспорт, то переводит переключатель 9 в режим 2, и, когда передние колеса поднимутся на заданный угол, с помощью джойстика наезжает ими на въезд;
3) после того, как передние колеса достаточно заедут на ступеньку входа, пассажир переводит переключатель 9 в режим 3, центральные колеса поднимаются, становясь на один уровень с передними, и пассажир с помощью джойстика заезжает в транспорт;
4) после заезда в транспорт пассажир переводит переключатель 9 в положение 1, снимая тем самым с переднего шасси ограничения движения.

## 3.2 Структурная схема САУ

Рассмотрим структурную схему САУ в рассматриваемом режиме. Данная схема показана на рис.3.2.

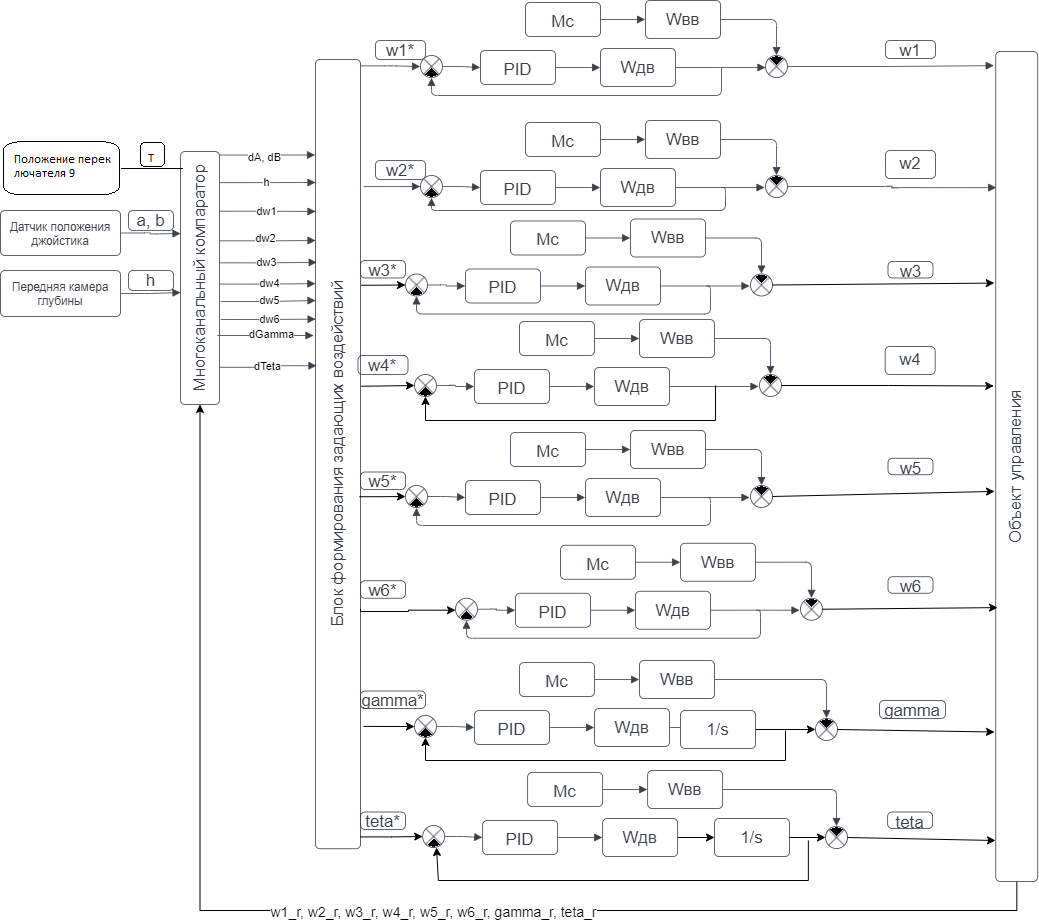
[picture p20: figure]

Рис.3.2. Структурная схема САУ в рассматриваемом режиме.

Первым блоком идет многоканальный компаратор, который, получая на вход положение переключателя 9 (на схеме обозначено как T), углы отклонения джойстика от вертикального положения α, β (на схеме обозначены как a, b), расстояние до ближайшего препятствия h, а также данные о текущих скоростях колес ( w1_r , w2_r , w3_r , w4_r , w5_r , w6_r ) и положениях передних шасси ( γ_r , θ_r ) с энкодеров соответствующих приводов, вычисляет ошибки для скоростей колес и положений шасси ( dw1, dw2,dw3, dw4, dw5, dw6 , dγ, dθ ), и передает все эти данные в блок задающих воздействий. Блок задающих воздействий формирует желаемые значения скоростей колес и положений шасси ( w1^(*) , w2^(*) ,w3^(*) , w4^(*) , w5^(*) , w6^(*) , γ^(*) , θ^(*) ). Желаемые значения попадают в ветки управления отдельными приводами, на выходе которых мы получим скорости колес и положения шасси в следующий момент времени.

# 3.3 Настройка ПИД-регулятора привода колес

## 3.3.1 Настройка ПИД-регулятора САУ привода

Проектирование САУ устройства начнем с создания ПИД-регулятора для приводов колес, пока без учета нелинейности и робастности данных систем.

Для начала составим математическую модель электропривода. Математическая модель электромеханической системы (электропривода) описывается системой уравнений Максвелла-Лагранжа:

{, U(t)=R_я i_я +ωC_e +L_я (di_я)/(dt), (J+J_(дв) )(dω)/(dt)=C_m i_я -M_c . (3.1)

Заменим d/(dt) оператором Лапласа р:

{, U=R_я i_я +ωC_e +L_я ∙p∙i_я , (J+J_(дв) )pω=C_m i_я -M_c . (3.2)

Проведем следующие преобразования:

{, U(t)-ωC_e =i_я (L_я ∙p + R_я ), i_я =(J∙p∙ω+M_c)/(C_m). (3.3)

Подставим второе уравнение системы в первое:

(J∙p∙ω+M_c)/(C_m)(L_я ∙p + R_я )=U(t)-ωC_e . (3.4)

Раскроем скобки:

(L_я ∙J)/(C_m)∙p^2 ∙ω+(L_я)/(C_m)∙p∙M+(R_я ∙J)/(C_m)∙p∙ω+(R_я)/(C_m)∙M=U(t)-ωC_e . (3.4)

Преобразуем выражение к виду:

((L_я ∙J)/(C_m)∙p^2 +(R_я ∙J)/(C_m)∙p+C_e )∙ω=U(t)-((L_я)/(C_m)∙p + (R_я)/(C_m))∙M. (3.5)

Отсюда находим передаточные функции.

Передаточная функция двигателя:

W_(дв) (P)=1/((L_я ∙J)/(C_m)∙p^2 +(R_я ∙J)/(C_m)∙p+C_e). (3.6)

Передаточная функция возмущающего воздействия:

W_(вв) (P)=((L_я)/(C_m)∙p + (R_я)/(C_m))/((L_я ∙J)/(C_m)∙p^2 +(R_я ∙J)/(C_m)∙p+C_e). (3.7)

Получим также из (3.5) дифференциальное уравнение для моделирования двигателя в Simulink:

((L_я ∙J)/(C_m)∙p^2 +(R_я ∙J)/(C_m)∙p+C_e )∙ω=U-((L_я)/(C_m)∙p + (R_я)/(C_m))∙M; (L_я ∙J)/(C_m)∙p^2 *ω+(R_я ∙J)/(C_m)∙p*ω+C_e *ω=U-(L_я)/(C_m)∙p*M- (R_я)/(C_m)*M |*(C_m)/(L_я ∙J*p^2); ω+(R_я)/(L_я)*1/p*ω+(C_m *C_e)/(L_я ∙J)*1/(p^2)*ω=(C_m)/(L_я ∙J)*1/(p^2)*U-1/J*1/p*M-(R_я)/(L_я ∙J)*1/(p^2)*M. (3.8)

Решим (3.8) относительно ω :

ω= (C_m)/(L_я ∙J)*1/(p^2)*U-1/J*1/p*M-(R_я)/(L_я ∙J)*1/(p^2)*M-(R_я)/(L_я)*1/p*ω-(C_m *C_e)/(L_я ∙J)*1/(p^2)*ω; ω=1/p(-(R_я)/(L_я)*ω-1/J*M+1/p((C_m)/(L_я ∙J)*U-(R_я)/(L_я ∙J)*M-(C_m *C_e)/(L_я ∙J)*ω)). (3.9)

Блок-схема данного уравнения в Simulink показана на рис. 3.3.

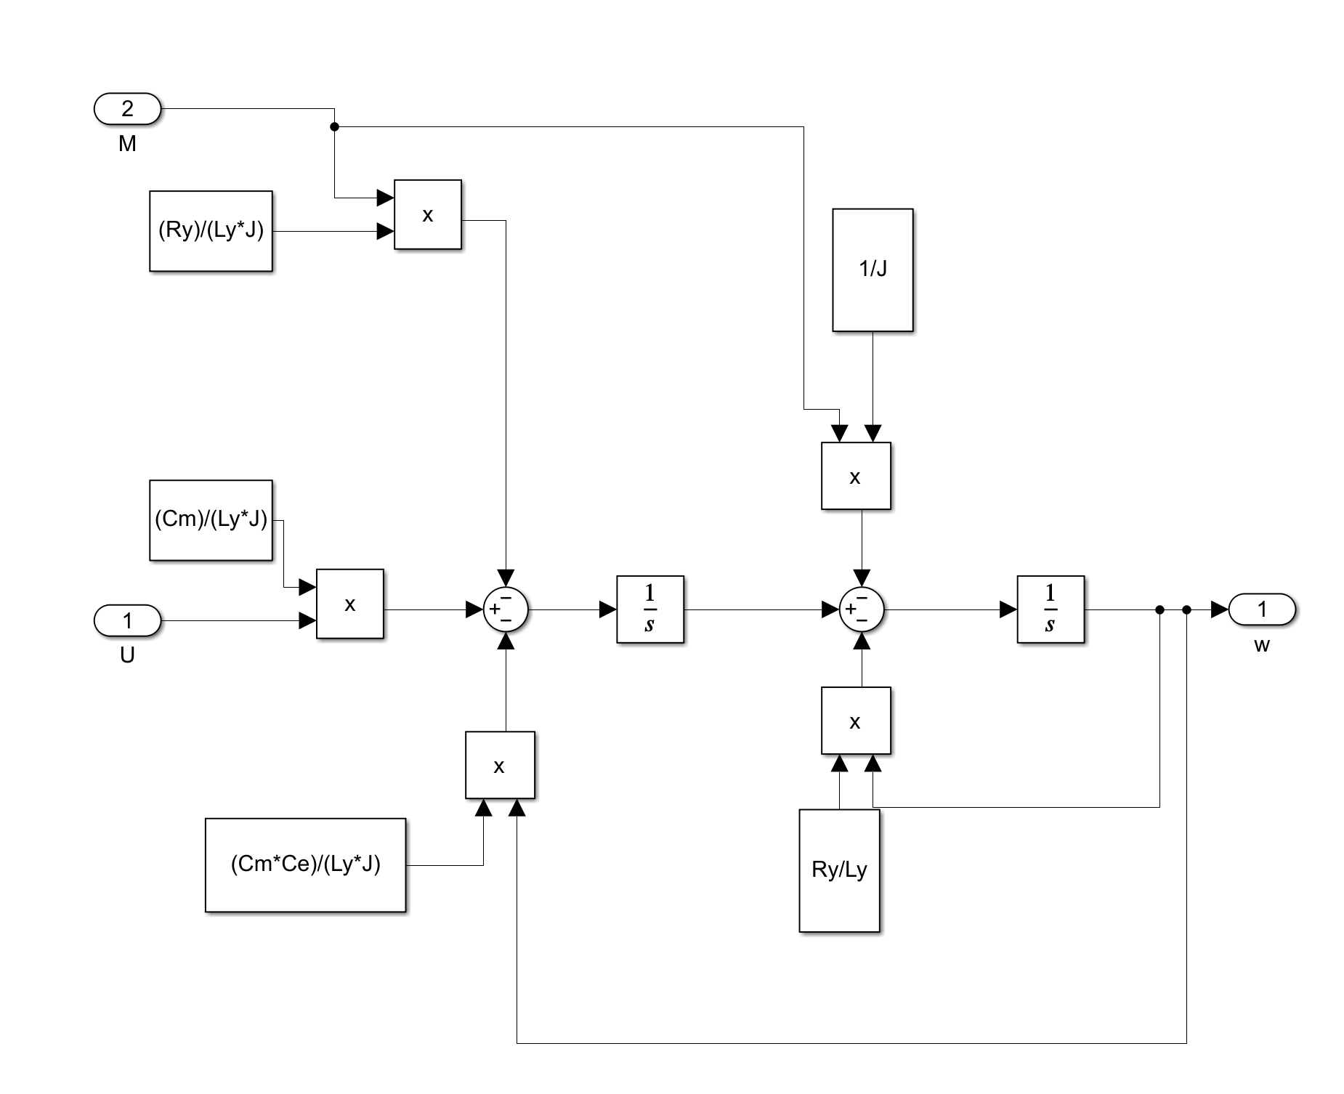
[picture p21: figure]

Рис.3.3. Блок-схема уравнения привода в Simulink

Данная блок-схема составлена в виде подсистемы “Мотор”, на вход которой подается момент сопротивления двигателю M и напряжение питания U, выходом служит угловая скорость привода ω . Значения параметров двигателя зададим через командное окно MATLAB. С использованием данной подсистемы составим теперь блок схему оценки качества переходного процесса без ПИД-регулятора (рис.3.4) (момент сопротивления пока выставим не большим – 0.1 Н*м).

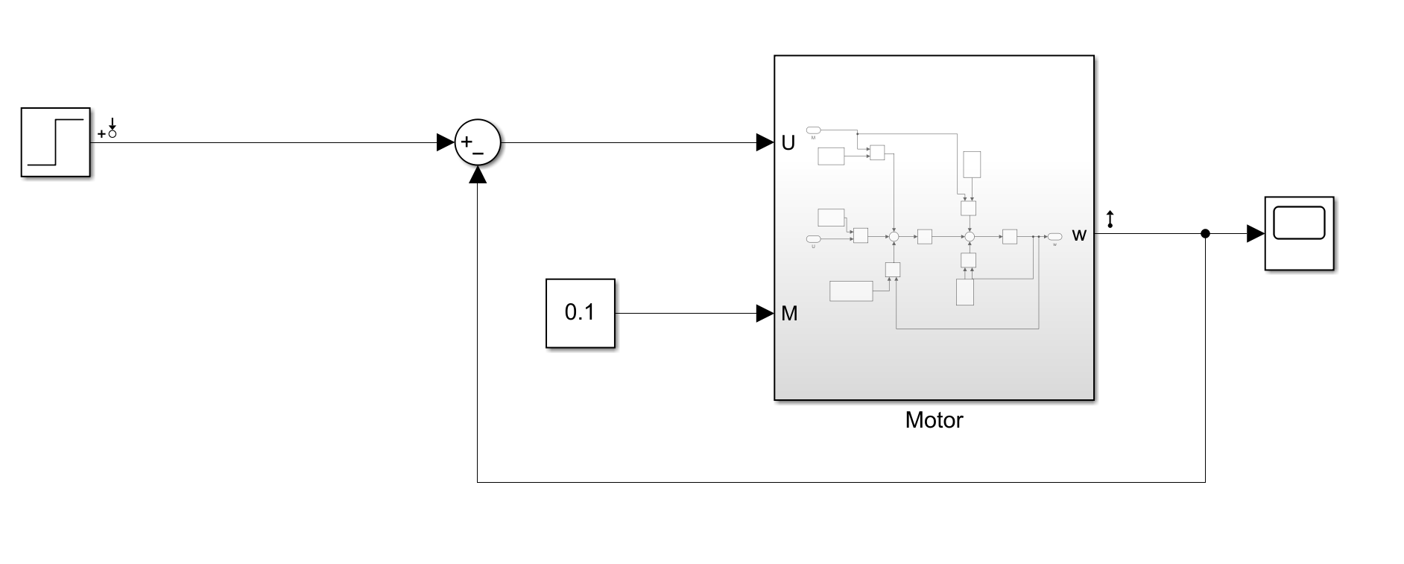
[picture p22: figure]

Рис.3.4. Блок-схема оценки качества переходного процесса

Выведем с помощью Model Linearizer текущие параметры переходного процесса рис.3.5.

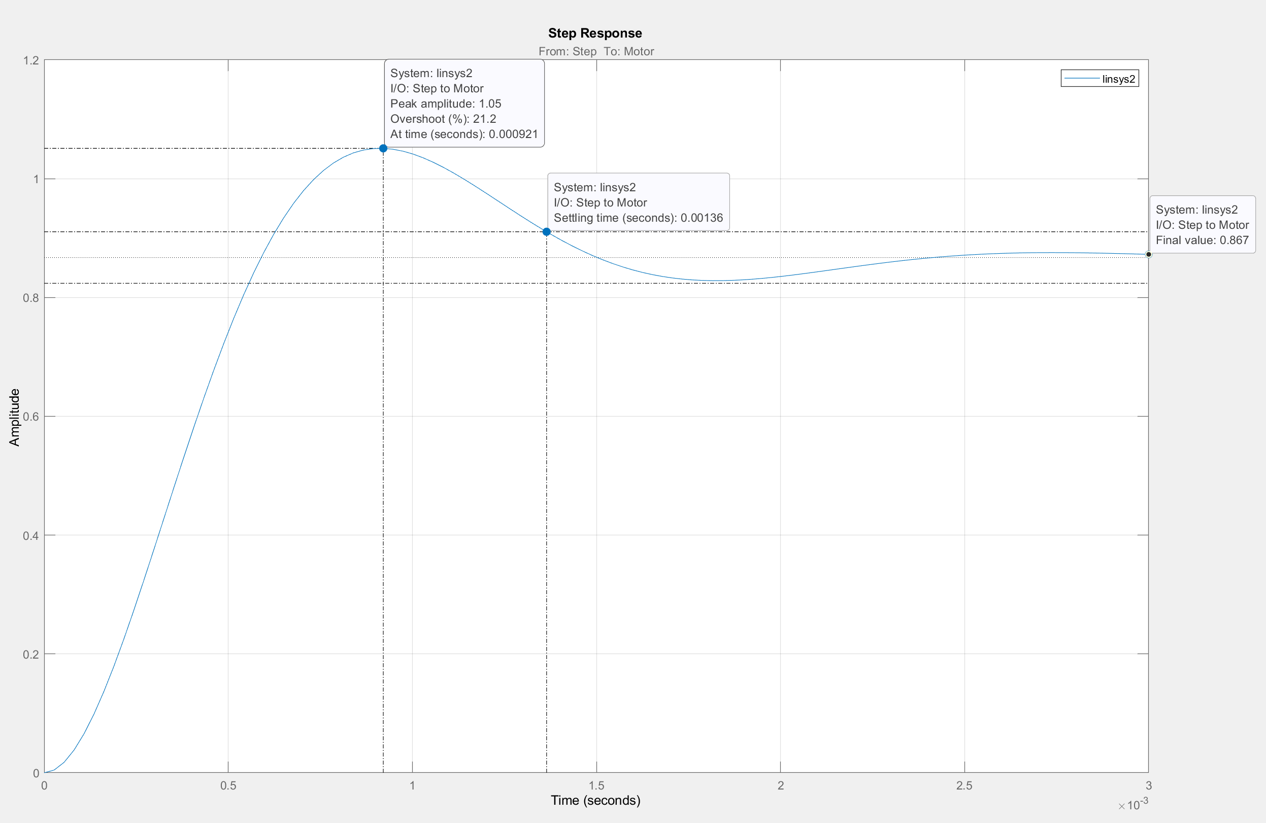
[picture p23: figure]

Рис.3.5. Характеристика переходного процесса

Перерегулирование в данной системе составляет σ=21.2%, статическая ошибка δ=1-0.867=0.133 , время установления составляет t=0.001 c .

По ТЗ, перерегулирование должно равняться 0, так же как и статическая ошибка, поэтому в систему необходимо добавить ПИД-регулятор. Блок-схема для настройки данного регулятора показана на рис.3.6.

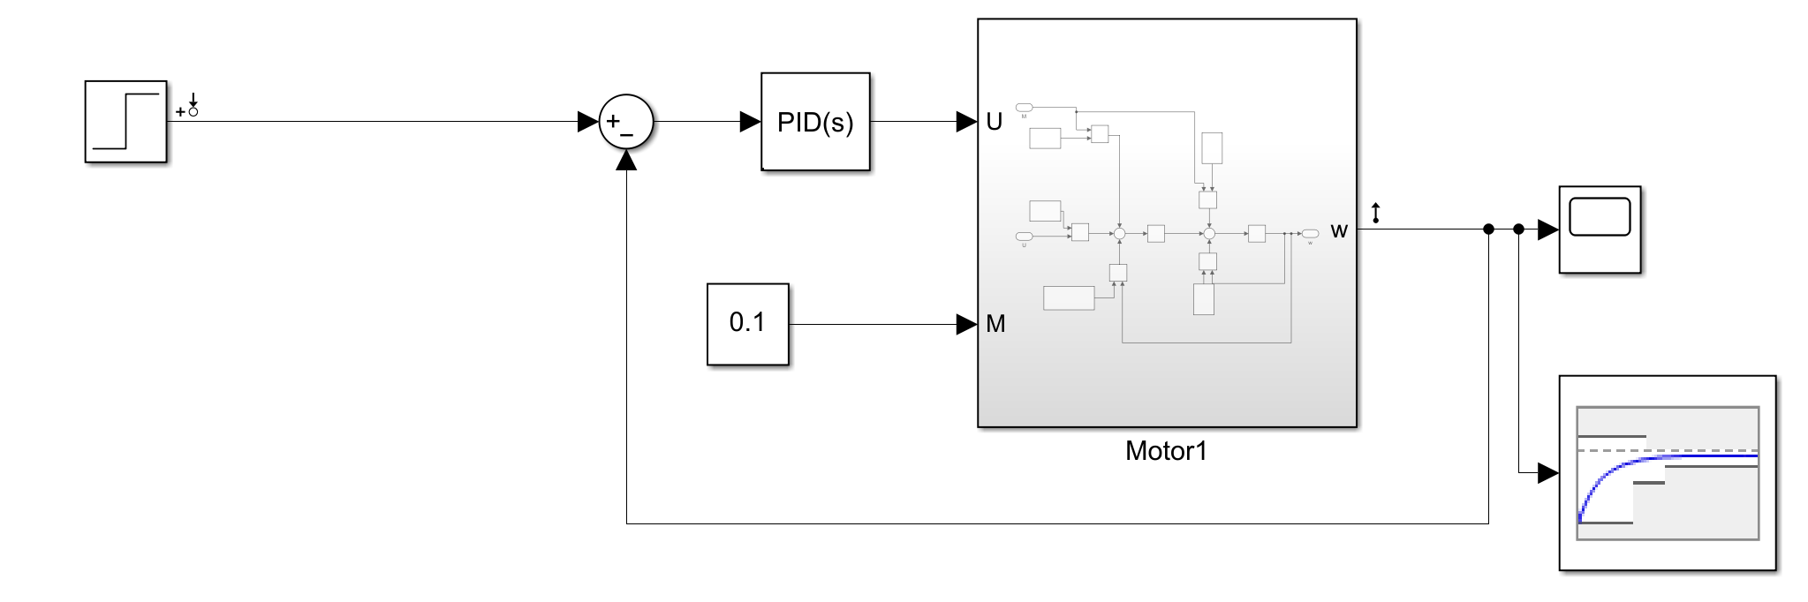
[picture p24: figure]

Рис.3.6. Блок-схема настройки ПИД-регулятора

Создав в командном окне MATLAB переменные для хранения коэффициентов регулятора Kp, Ki, Kd, настроим блок Check Step Response

Characteristics на работу с ними (рис.3.7).

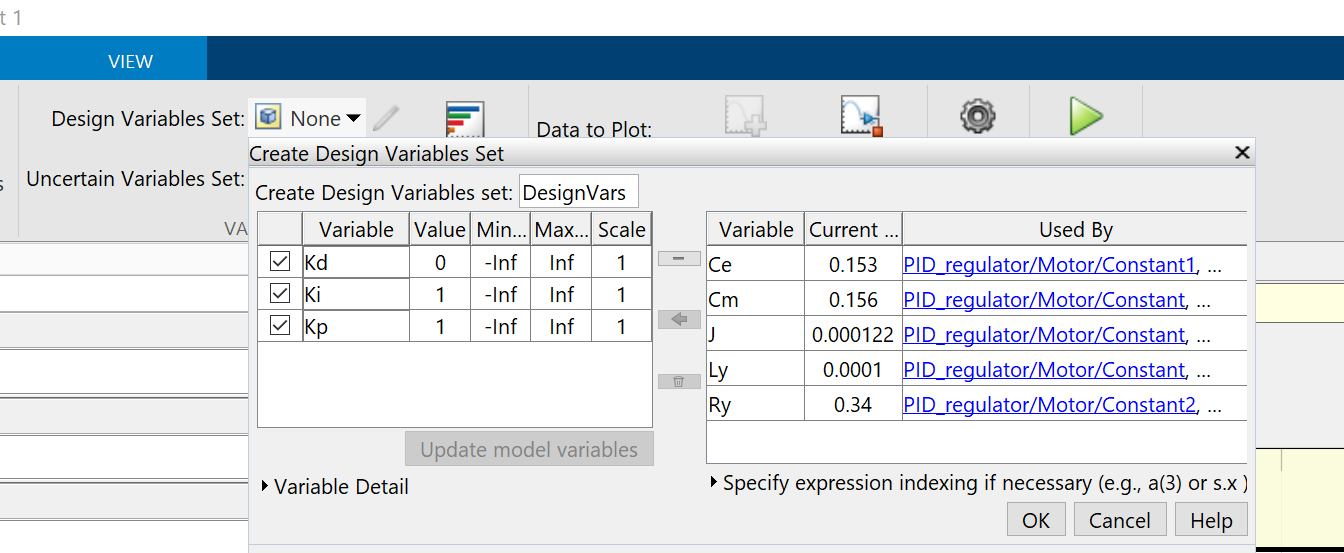
[picture p25: figure]

Рис.3.7. Настройки блока Check Step Response Characteristics

После настройки имеем переходную характеристику, показанную на рис.3.8.

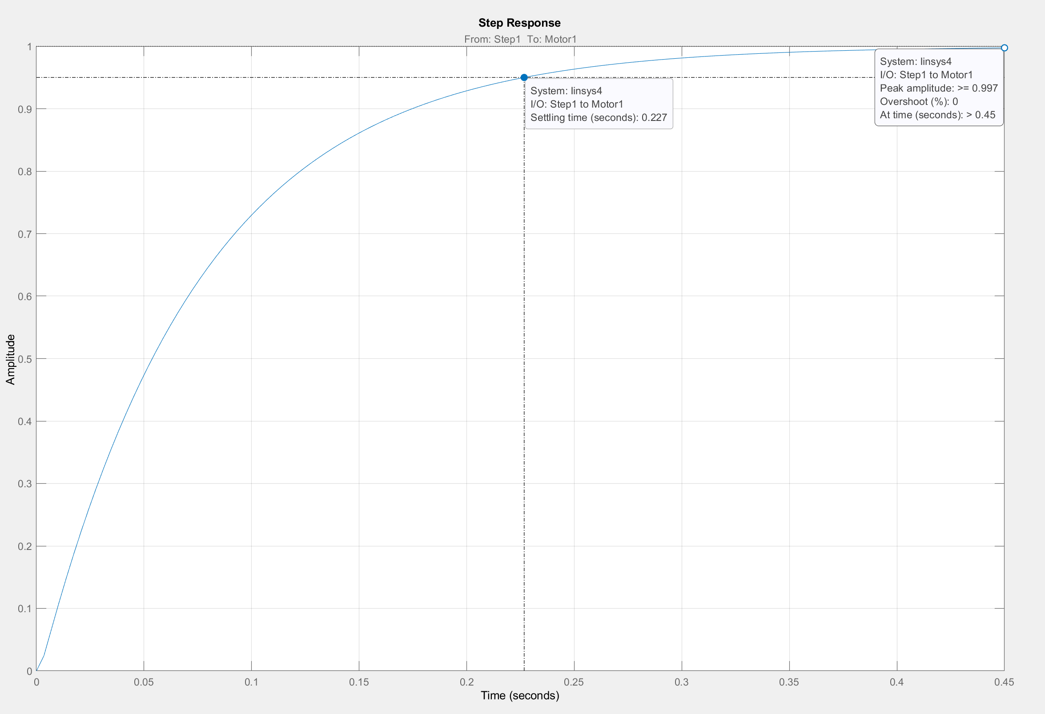
[picture p26: figure]

Рис.3.8. Переходная характеристика после настройки

Как видно, перерегулирование σ=0%, статическая ошибка δ=0 , время установления составляет t=0.23 c , что полностью удовлетворяет условию ТЗ. Получились следующие коэффициенты: Kd = 0, Ki = 2, Kp = 0.

Анализируя полученные коэффициенты, можно сделать вывод о том, что для корректной работы выбранного привода в идеальных условиях достаточно всего лишь И-регулятора, что существенно упростит итоговую систему управления. Но в данной настройке не были учтены все нюансы реальной приводной системы, их мы учтем в следующих главах.

## 3.3.2. Настройка регулятора с учетом нелинейности привода

В прошлом разделе мы настроили САУ привода без учета нелинейности системы мотора. На самом деле в любом приводе присутствуют два нелинейных эффекта – зона нечувствительности и зона насыщения.

Зона нечувствительности n (на примере электродвигателя) выражается в том, что электрический двигатель имеет определённый минимальный ток трогания (i=n), до достижения которого вал двигателя будет неподвижен. В гидравлическом же двигателе золотник имеет так называемую зону перекрытия (его поршенёк немного шире отверстия, им закрываемого), вследствие чего он откроет путь рабочей жидкости в цилиндр двигателя, только переместившись на некоторую величину x=n. Аналогично и в случае пневмодвигателя, где роль золотника играет заслонка.

Зона насыщения обнаруживается в том, что при увеличении тока в приводе управляющего органа сверх некоторого значения i=b скорость перемещения управляющего органа остаётся постоянной; также и для гидравлического двигателя, когда окна золотника полностью открыты.

В Simulink за зону нечувствительности отвечает блок Dead Zone, а за зону насыщения – блок Saturation.

Составим блок-схему настройки ПИД-регулятора с учетом эффектов нелинейности, рис.3.9.

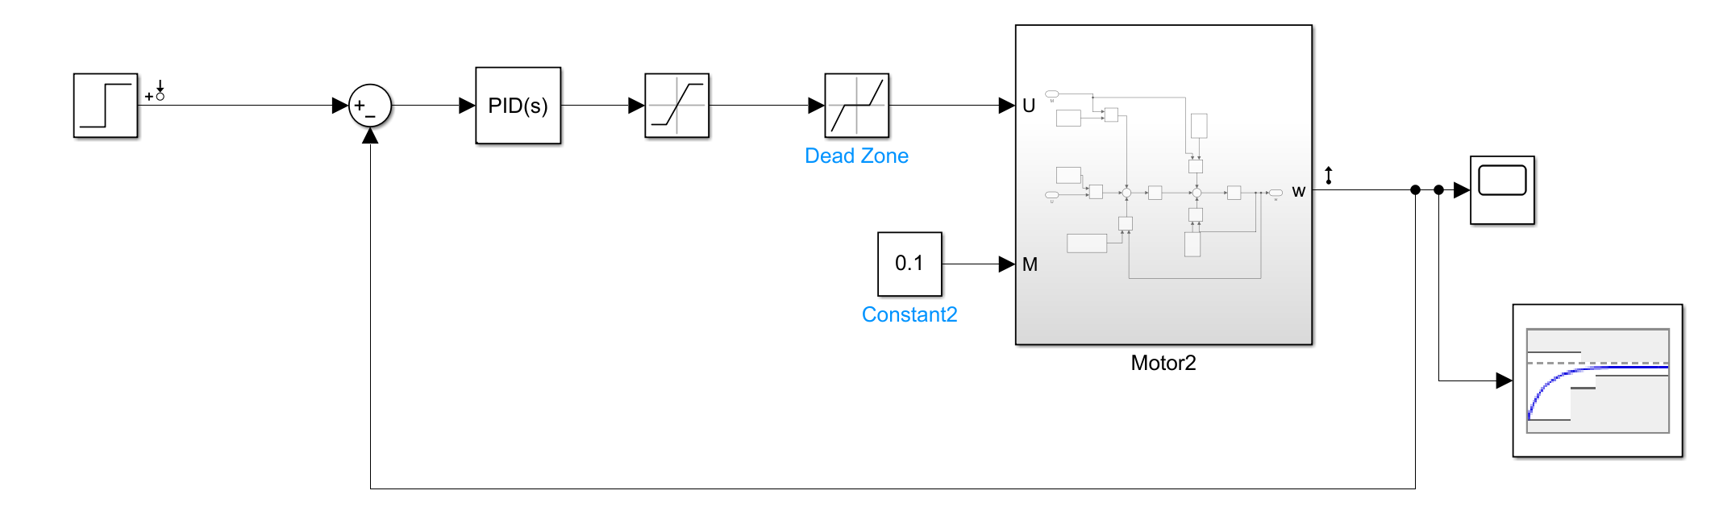
[picture p27: figure]

Рис.3.9. Блок-схема настройки регулятора нелинейной САУ

Для Dead Zone значение коэффициента ограничителя возьмем равным b=0.8, а значение коэффициента нечувствительности для Saturation зададим равным a=0.15.

Переходная характеристика нелинейной САУ с закомментированным регулятором показана на рис.3.10.

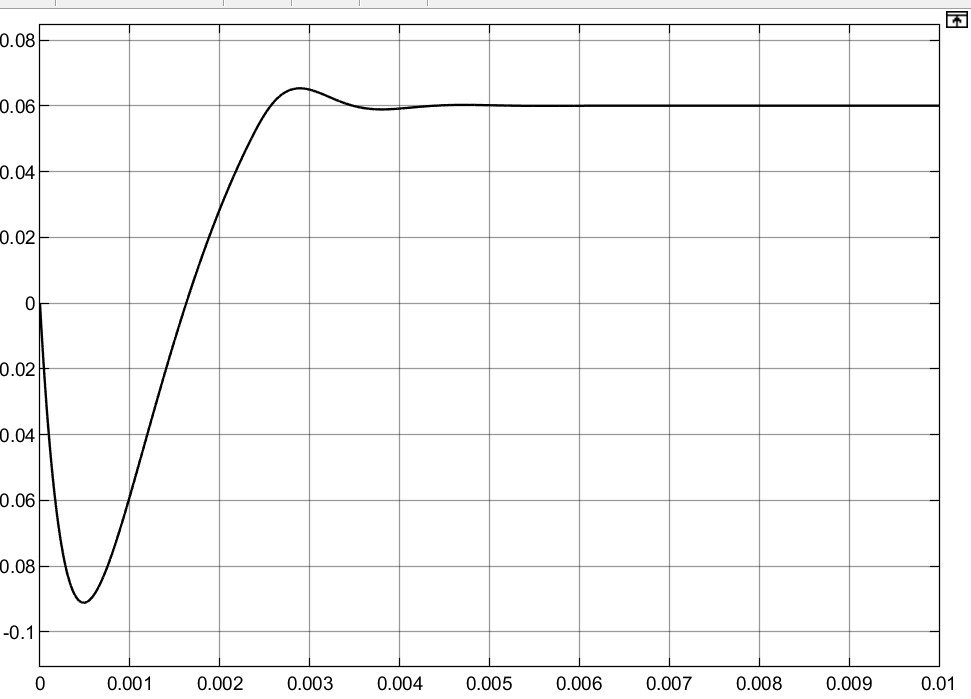
[picture p28: figure]

Рис.3.10. Переходная характеристика ненастроенной нелинейной САУ

Как видим, присутствует сильная колебательность и очень большая статическая ошибка δ=1-0.006=0.994 , перерегулирование, судя по графику, составляет σ=5% . Стоит также отметить, что при значении момента сопротивления больше чем 0.006 наблюдается реверс движения двигателя.

Приступим к настройке ПИД регулятора. Для начала настроим переменные для оптимизации, также как это сделано на рис.3.7. Затем проведем оптимизацию. Параметры переходного процесса после оптимизации показаны на рис.3.11.

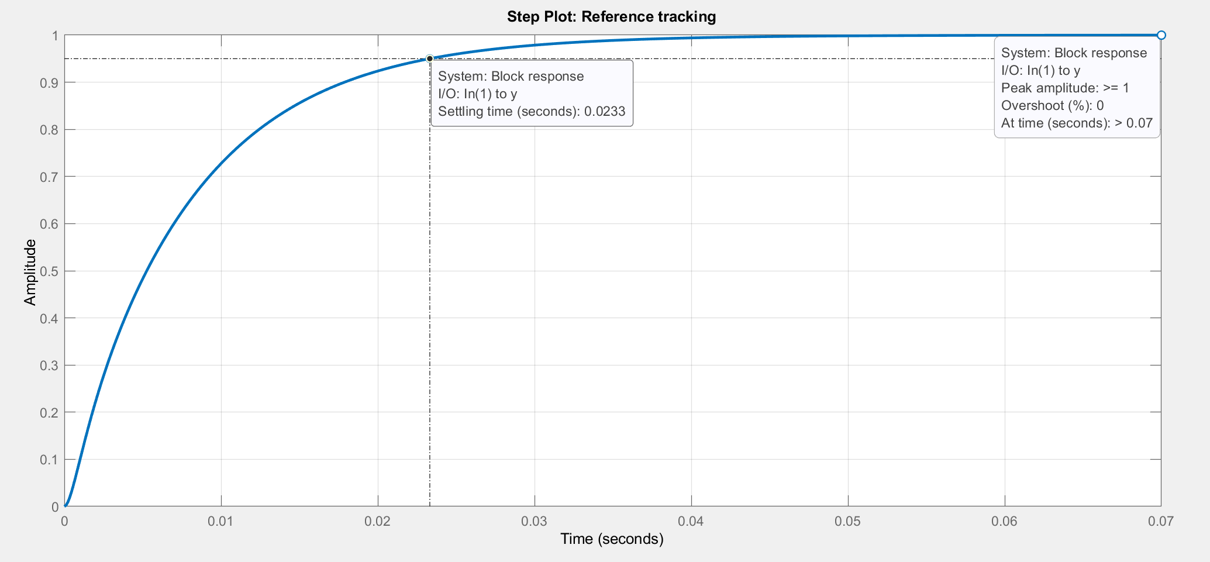
[picture p29: figure]

Рис.3.11. Характеристики настроенной САУ

Коэффициенты ПИД-регулятора получились такими: Kp = 0,1, Ki = 19,7, Kd = 0.

Таким образом, в данном разделе была настроена САУ привода с учетом нелинейности его системы. И опять мы получаем упрощение системы управления за счет того, что получился ПИ-регулятор а не полноценный ПИД. Но в данной главе мы не учитывали такой эффект системы управления, как задержка обратной связи, ее мы учтем в следующей главе.

## 3.3.3 Настройка регулятора САУ с учетом задержки обратной связи

В настоящей системе управления отклик на изменение входного сигнала происходит не мгновенно. Это происходит, в основном, из-за задержек, необходимых на получение данных обратной связи и их обработку.

Настроим САУ привода с учетом запаздывания τ=0.5c .

В программном пакете MATLAB/Simulink функцию запаздывания реализует блок Transport Delay. Составим схему для настройки САУ с запаздыванием, рис.3.12.

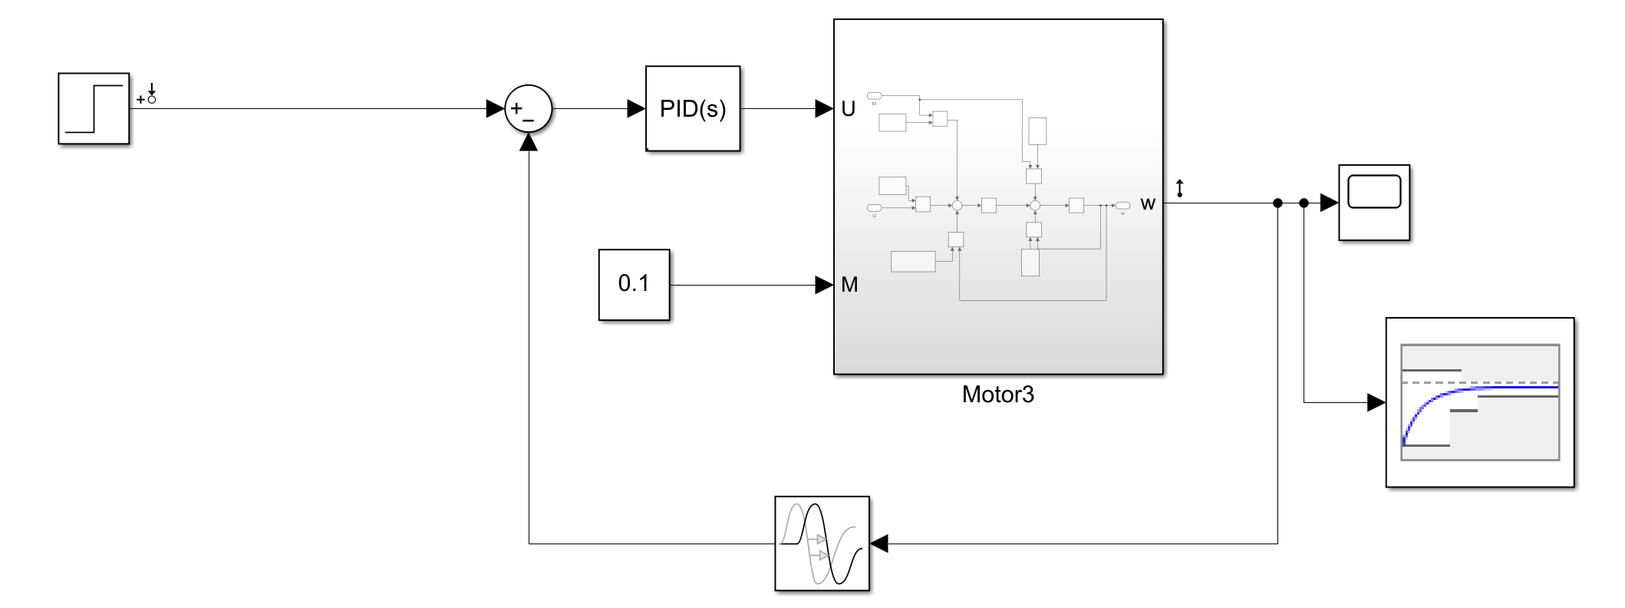
[picture p30: figure]

Рис.3.12. Математическая модель САУ с запаздыванием

Узнаем исходные характеристики переходного процесса с помощью Model Linearizer. Полученный график переходного процесса показан на рис.3.13.

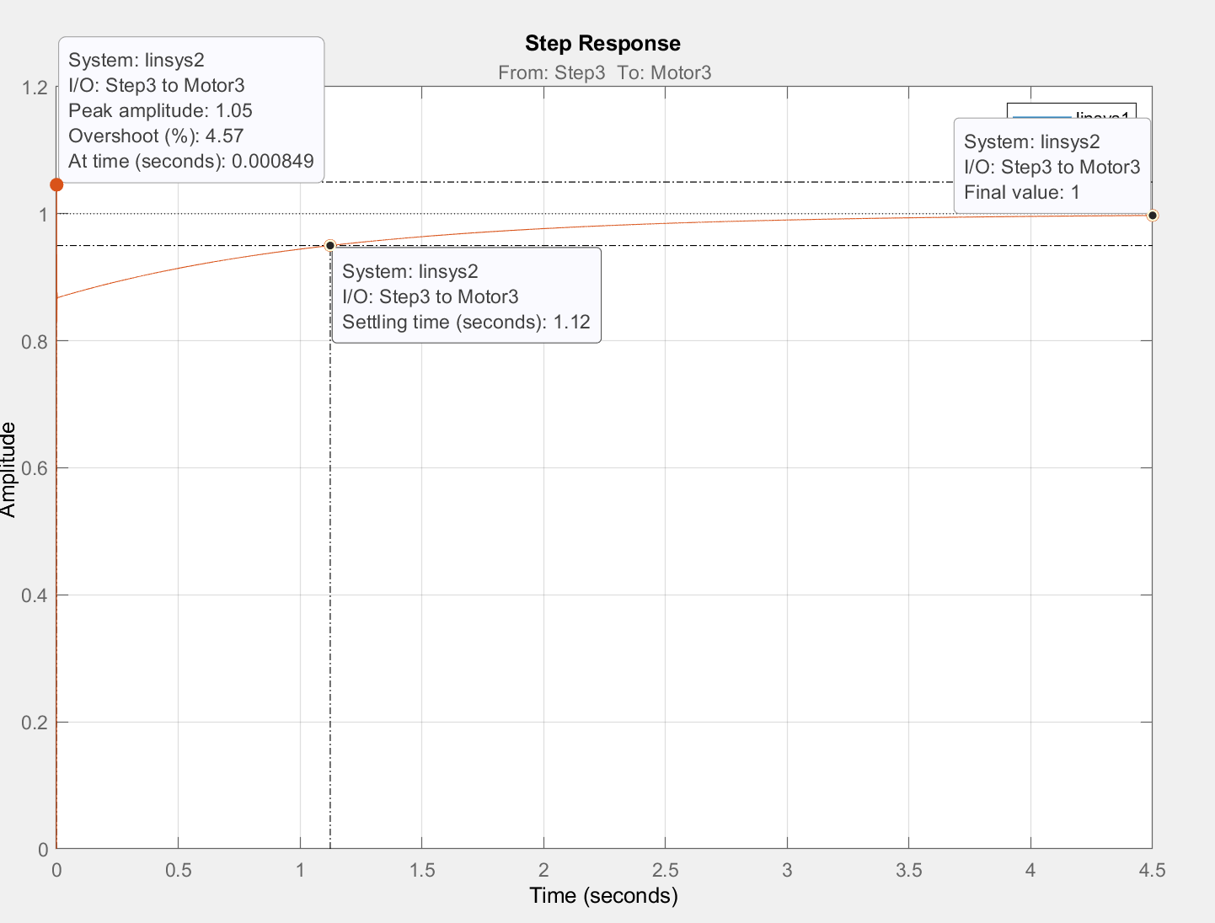
[picture p31: figure]

Рис.3.13. Параметры переходного процесса ненастроенной САУ

По графику видим, что перерегулирование σ=4.57% , статической ошибки нет, колебательности тоже нет, но форма графика не правильная.

Приступим к настройке ПИД регулятора. Для начала настроим переменные для оптимизации, также как это сделано на рис.3.7. Затем проведем оптимизацию. Параметры переходного процесса после оптимизации показаны на рис.3.14.

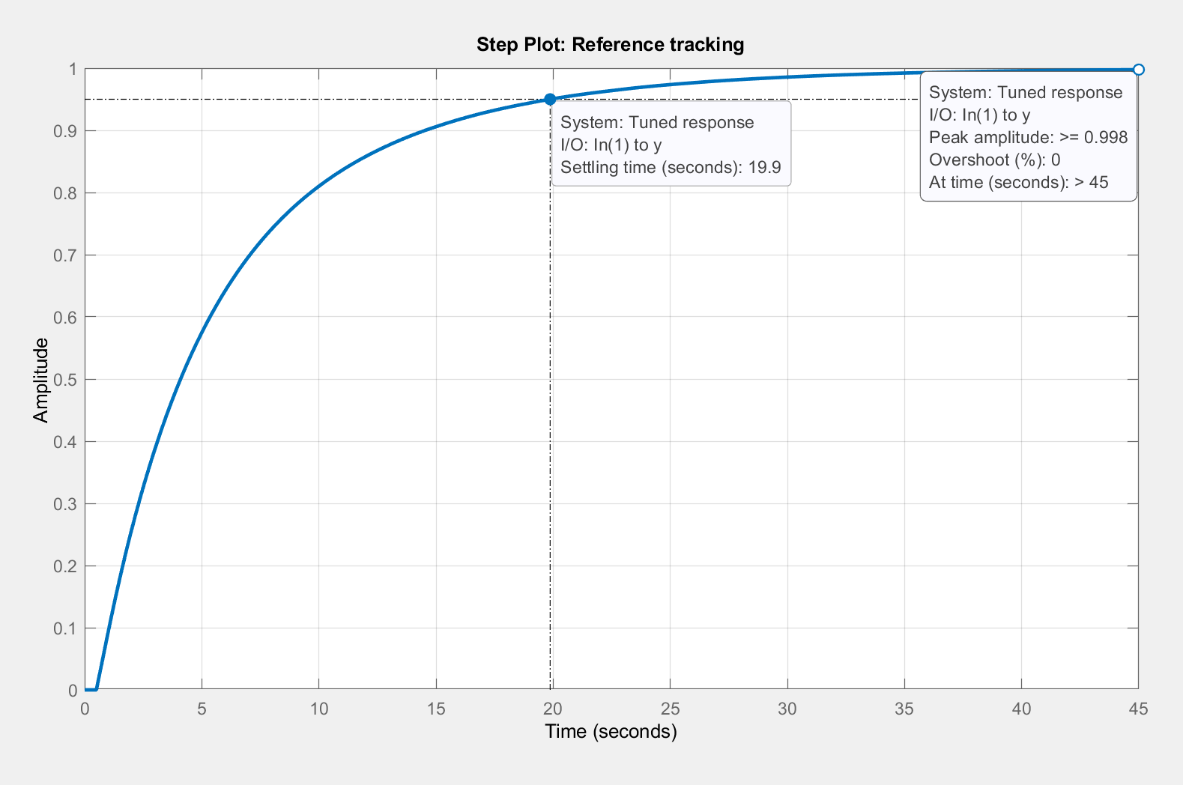
[picture p32: figure]

Рис.3.14. Параметры переходного процесса с настроенным регулятором

Как видно, статическая ошибка и перерегулирование были устранены, однако существенно выросло время установления (с 1.12 с до 19 с). Это вызвано как раз наличием задержки в цепи обратной связи. Полученные коэффициенты ПИД-регулятора получились такими Kp = 0.33, Ki = 0.012, Kd = 0.002:

Таким образом в данном разделе мы настроили САУ с учетом наличия задержки 0.5 с в цепи обратной связи. Анализируя полученные во время настройки данные, можно сказать, что задержка на обработку обратной связи в проектируемой САУ не должна быть больше 0.5 секунд, иначе данная система управления не будет справляться с поставленной задачей. В данном случае уже, как видно, нужен полноценный ПИД регулятор. Осталось учесть только один эффект – робастность привода.

## 3.3.4. Настройка робастной САУ

В реальной системе управления параметры двигателя могут колебаться от двигателя к двигателю. В этом и заключается один из признаков робастной САУ – некоторые их параметры могут изменяться в заданных границах.

Главной задачей синтеза робастных систем управления является поиск закона управления, который сохранял бы выходные переменные системы и сигналы ошибки в заданных допустимых пределах несмотря на наличие неопределенностей в контуре управления.

Попробуем настроить такую систему управления. Блок-схема для проведения настройки показана на рис. 3.15.

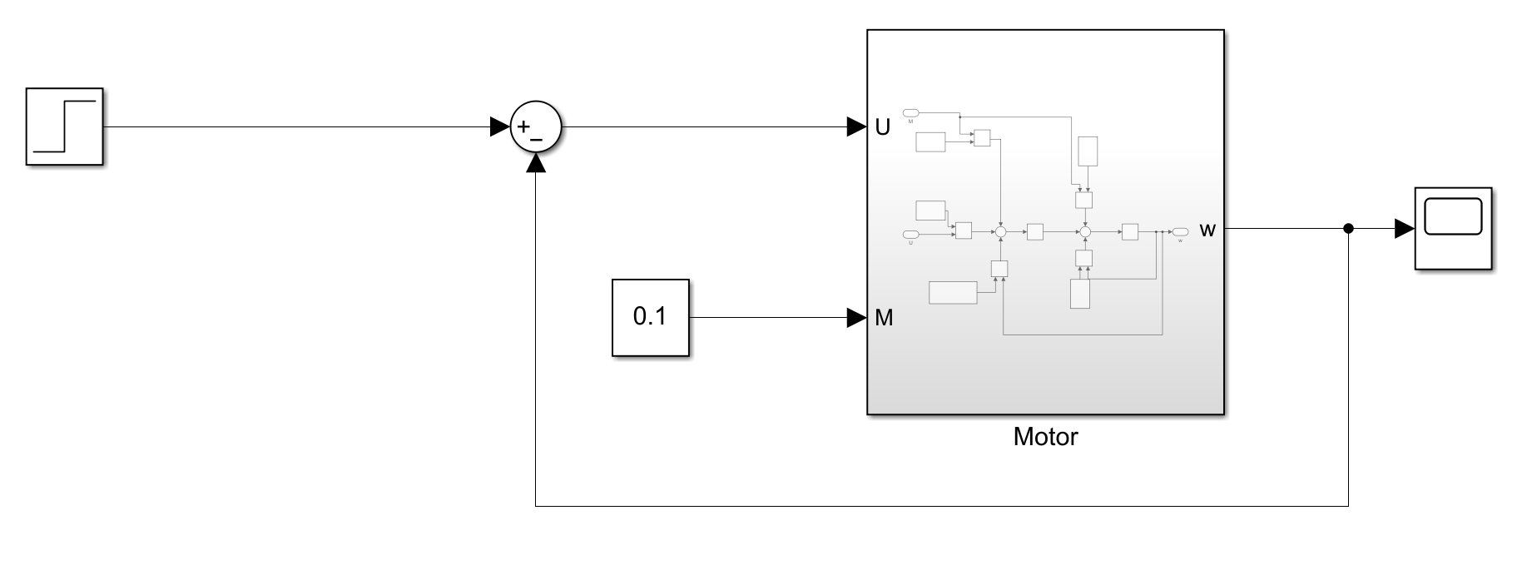
[picture p33: figure]

Рис.3.15. Блок-схема настройки робастной САУ

В данном случае изменяемыми являются параметры двигателя (сопротивление якоря ( R_я ) и индуктивность якоря ( L_я )). Зададим диапазон изменения этих переменных 20%. Зная это, рассчитаем максимальные и минимальные значения этих параметров:

L_(я-min) =0.1*10^(-3) -0.1*10^(-3) *0.2=0.8*10^(-3) Гн; L_(я-max) =0.1*10^(-3) +0.1*10^(-3) *0.2=0.12*10^(-3) Гн;

R_(я-min) =0.34-0.34*0.2=0.272 Ом; R_(я-max) =0.34+0.34*0.2=0.408 Ом.

В меню Uncertain Variables Set блока Check Step Response Characteristics выбираем “неуверенные” переменные, выделим левой кнопкой мыши в правом поле переменные Ry, Ly, и нажатием стрелки переместим их в левое поле. Нажимаем Set Uncertain Values, где вводим вычисленные значения нижних и верхних границ переменных Ry и Ly (рис.3.16).

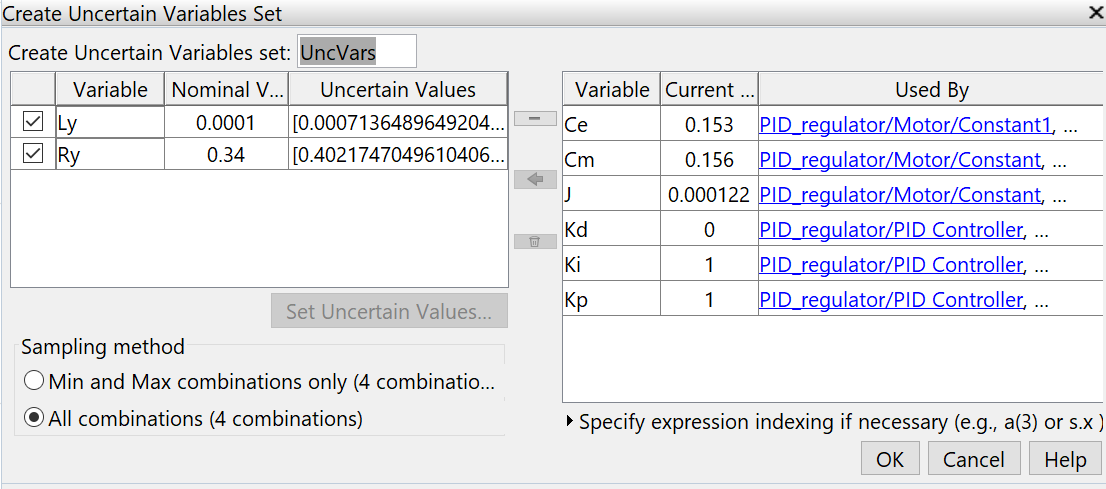
[picture p34: figure]

Рис.3.16. Настройка изменяемых параметров регулятора привода

Обычные переменные вводятся в расчёт через меню Design Variable Set.

Начнем процесс оптимизации. После его успешного завершения с помощью

Model Linearizer выведем Step Response для всех комбинаций значений двух ‘не уверенных’ переменных рис.3.17.

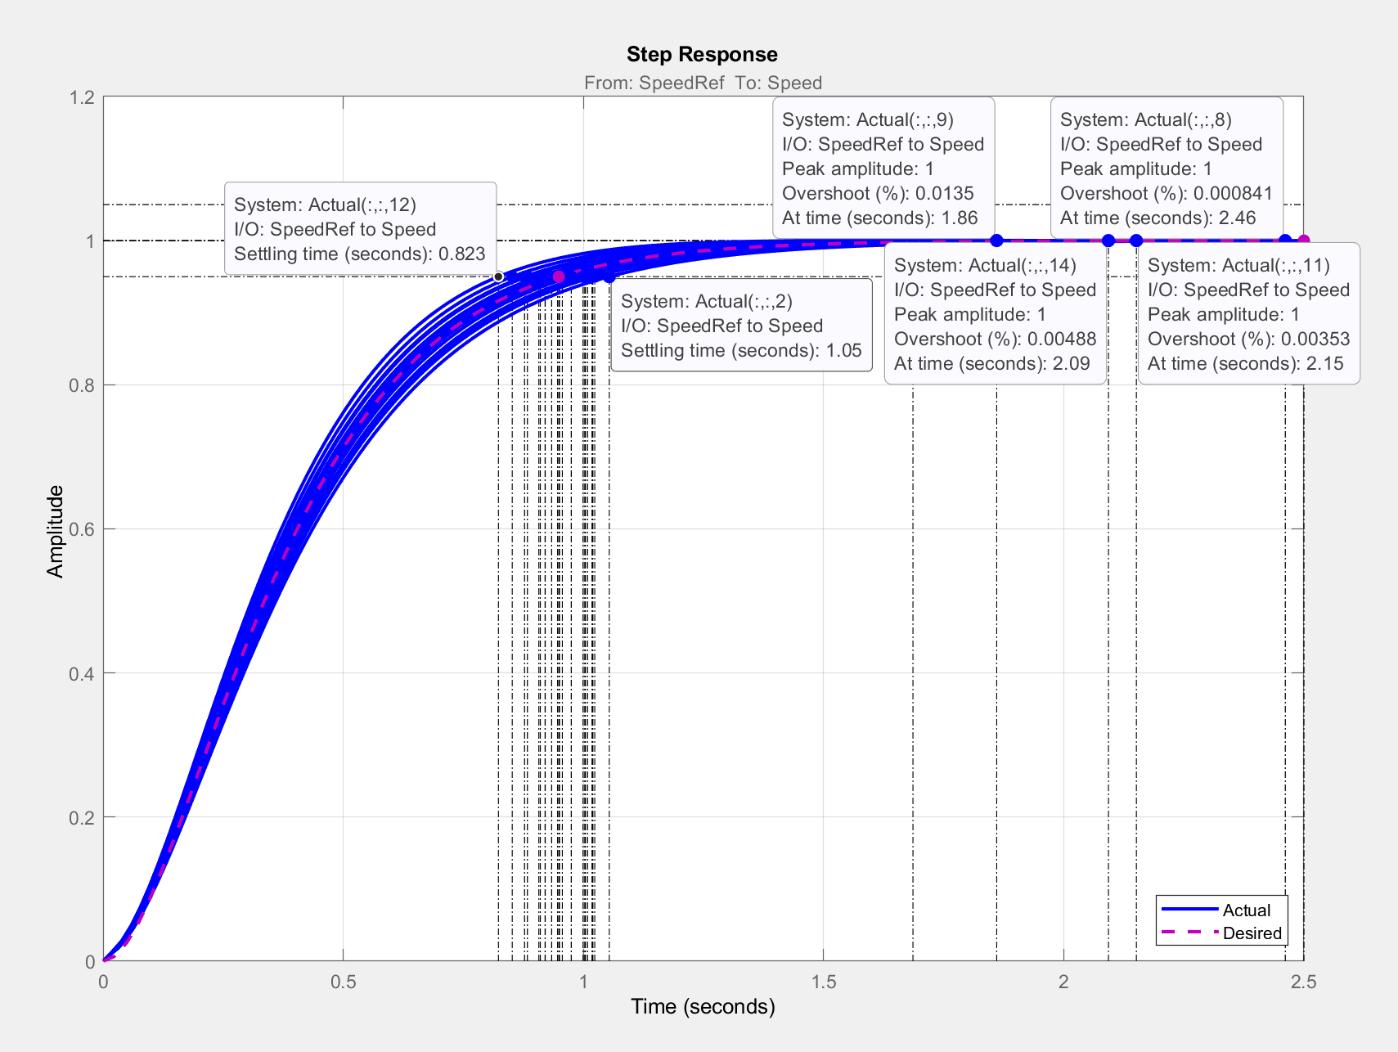
[picture p35: figure]

Рис.3.17. Step Response системы при разных комбинациях значений ‘неуверенных’ переменных

Как можно видеть, независимо от комбинации значений переменных, перерегулирование σ≈0 , статическая ошибка δ=0 , колебательности нет, а время установления находится в промежутке от 0.8 до 1.05с, что полностью удовлетворяет условиям ТЗ.

Коэффициенты ПИД-регулятора получились такими: K_p = -0.09, K_i = 0.928, K_d = 0.001 .

Подводя итог всему разделу 3.3, можно сказать что в нем были успешно настроены ПИД-регуляторы, обеспечивающие заданные по ТЗ характеристики управления контурами приводов колес, с учетом таких эффектов систем управления привода, как нелинейность, робастность и задержка обработки данных обратной связи.

# 3.4. Проверка устойчивости системы управления

## 3.4.1. Проверка устойчивости системы управления по критерию Гурвица

Критерий устойчивости Гурвица формулируется так: для устойчивости линейной системы необходимо и достаточно, чтобы все n диагональных миноров, полученных из матрицы Гурвица (составленной из коэффициентов характеристического уравнения замкнутой системы), были положительны.

Рассмотрим устойчивость системы с ПИД-регулятором с коэффициентами от настройки робастной САУ ( K_p = -0.09, K_i = 0.928, K_d = 0.001 ). Передаточная функция ПИД-регулятора выглядит так:

W(P)=(K_d p^2 +K_p p+K_i)/p

Передаточная функция нашего двигателя выглядит так (выражение 3.6):

W_(дв) (P)=1/((L_я ∙J)/(C_m)∙p^2 +(R_я ∙J)/(C_m)∙p+C_e)

Нужно найти передаточную функцию разомкнутой системы как произведение передаточных функций двигателя и ПИД-регулятора:

W_(р.с) (P)=W_(дв) (P)*W(P)=(K_d p^2 +K_p p+K_i)/p*1/((L_я ∙J)/(C_m)∙p^2 +(R_я ∙J)/(C_m)∙p+C_e) = (K_d p^2 +K_p p+K_i)/((L_я ∙J)/(C_m)∙p^3 +(R_я ∙J)/(C_m)∙p^2 +C_e p) (3.10)

Вычислим значения коэффициентов полинома знаменателя:

(L_я ∙J)/(C_m)=7.8*10^(-8) ;

(R_я ∙J)/(C_m)=2.7*10^(-4) ; Ce=0.153.

Подставим числовые значения в (3.10):

W_(р.с) (P)=(0.001p^2 -0.09p+0.928)/(7.8*10^(-8) ∙p^3 +2.7*10^(-4) ∙p^2 +0.153p)

Теперь чтоб найти матрицу Гурвица, надо найти передаточную функцию замкнутой функцию. Введем переобозначения:

A=0.001p^2 -0.09p+0.928;B=7.8*10^(-8) ∙p^3 +2.7*10^(-4) ∙p^2 +0.153p; W_(ос) =1.

С помощью новых обозначений запишем передаточную функцию замкнутой системы: W_(з.с) (P)=A/(B+W_(ос) *A)= (0.001p^2 -0.09p+0.928)/(7.8*10^(-8) ∙p^3 +2.7*10^(-4) ∙p^2 +0.153p+0.001p^2 -0.09p+0.928)=(0.001p^2 -0.09p+0.928)/(7.8*10^(-8) ∙p^3 +0.0013p^2 +0.063p+0.928)

(3.11).

Теперь составим из коэффициентов характеристического уравнения полинома знаменателя матрицу Гурвица H (так как высшая степень у нас 3 – матрица будет 3х3):

H=(0.0013, 0.928, 07.8*10^(-8) , 0.063, 00, 0.0013, 0.928)

Найдем теперь определители главный миноров:

∆_1 =0.0013→ ∆_1 >0; ∆_2 = 0.0013*0.063-0.063*7.8*10^(-8) =8.2*10^(-5) → ∆_2 >0;

∆_3 =0.0013*0.063*0.928+0.928*0*0+0.0013*7.8*10^(-8) *0-0*0.063*0-0*0.0013*0.0013-7.8*10^(-8) *0.928^2 =0.0013*0.063*0.928- 7.8*10^(-8) *0.928^2 =7.6*10^(-5) →∆_3 >0 .

Раз все определитель главных миноров больше 0 то по критерию Гурвица система устойчива.

## 3.4.2 Проверка устойчивости системы управления критерием Михайлова

Критерий устойчивости системы управления Михайлова звучит так:

для устойчивости линейной системы необходимо и достаточно, чтобы годограф Михайлова при изменении ω от 0 до ∞ начинался на вещественной оси и проходил последовательно против часовой стрелки n квадрантов комплексной плоскости, не обращаясь в нуль и стремясь к ∞ в n-м квадранте.

Годографом Михайлова называют график на комплексной плоскости полинома знаменателя замкнутой системы.

Возьмем передаточную функцию замкнутой системы, полученную в выражении (3.11):

W_(з.с) (P)=(0.001p^2 -0.09p+0.928)/(7.8*10^(-8) ∙p^3 +0.0013p^2 +0.063p+0.928)

Теперь возьмем характеристическое уравнение (полином знаменателя):

F(p)=7.8*10^(-8) ∙p^3 +0.0013p^2 +0.063p+0.928 (3.12)

, и проведем замену оператора Лапласа p на jω :

F(jω)=7.8*10^(-8) *(jω)^3 +0.0013*(jω)^2 +0.063*jω+0.928 (3.13)

Выражение (3.13) является функцией для построения годографа Михайлова. По полученному выражению построим в среде MathCAD характеристику, отображающую состояние исследуемой САУ (рис.3.18, 3.19).

Рис.3.18. Годограф Михайлова (начало)

Рис.3.19. Годограф Михайлова (конец)

Как можно видеть на рис.3.18 и рис.3.19, годограф начинается из положительной точки на вещественной оси, не обращается в нуль и уходит в бесконечность в 3-ем квадранте, что подтверждает устойчивость системы.

## 3.4.3. Проверка устойчивости системы критерием Найквиста

Критерий устойчивости Найквиста формулируется так: для устойчивости замкнутой системы необходимо и достаточно, чтобы амплитудно-фазовая характеристика устойчивой разомкнутой системы при изменении от 0 до ∞ не охватывала точку с координатами {-1;j0} .

Запишем передаточную функцию замкнутой системы (выражение 3.11):

W_(з.с) (P)=(0.001p^2 -0.09p+0.928)/(7.8*10^(-8) ∙p^3 +0.0013p^2 +0.063p+0.928)

Найдем обратную ей функцию: W(p)=(7.8*10^(-8) ∙p^3 +0.0013p^2 +0.063p+0.928)/(0.001p^2 -0.09p+0.928)

Теперь заменим в ней оператор Лапласа p на jω :

W(jω)=(7.8*10^(-8) *(jω)^3 +0.0013*(jω)^2 +0.063*jω+0.928)/(0.001jω^2 -0.09*jω+0.928) (3.14)

По выражению (3.14) построим график амплитудно-фазовая характеристика устойчивой разомкнутой системы (рис.3.20).

Рис.3.20. АФЧХ устойчивой разомкнутой системы

Как видно из рис.3.20, АФЧХ устойчивой разомкнутой системы не охватывает точку комплексной плоскости с координатами {-1;j0} , значит замкнутая система устойчива.

## 3.4.4. Проверка устойчивости систему управления критерием Боде и определение запаса устойчивости

Критерий устойчивости Боде формируется так: для устойчивости замкнутой системы необходимо и достаточно, чтобы на всех частотах, где ЛАЧХ разомкнутой системы положительная (L( ω ) > 0), фазовый сдвиг не достигал значения -180 ° или достигал его четное число раз.

Для того, чтобы проверить нашу передаточную функцию разомкнутой системы (выражение 3.10, W_(р.с) (P)=(0.001p^2 -0.09p+0.928)/(7.8*10^(-8) ∙p^3 +2.7*10^(-4) ∙p^2 +0.153p) ) по критерию Боде, введем ее с помощью функции tf() в командное окно MATLAB:

%коэффициенты

a2 = 0.001;

a1 = -0.09;

a0 = 0.928;

b3 = 7.8e-8;

b2 = 2.7e-4;

b1 = 0.153;

b0 = 0;

W = tf([a2 a1 a0], [b3 b2 b1 b0]); % передаточная функция

Затем функцией bode(W) построим диаграмму ЛАЧХ по критерию Боде (рис.3.21).

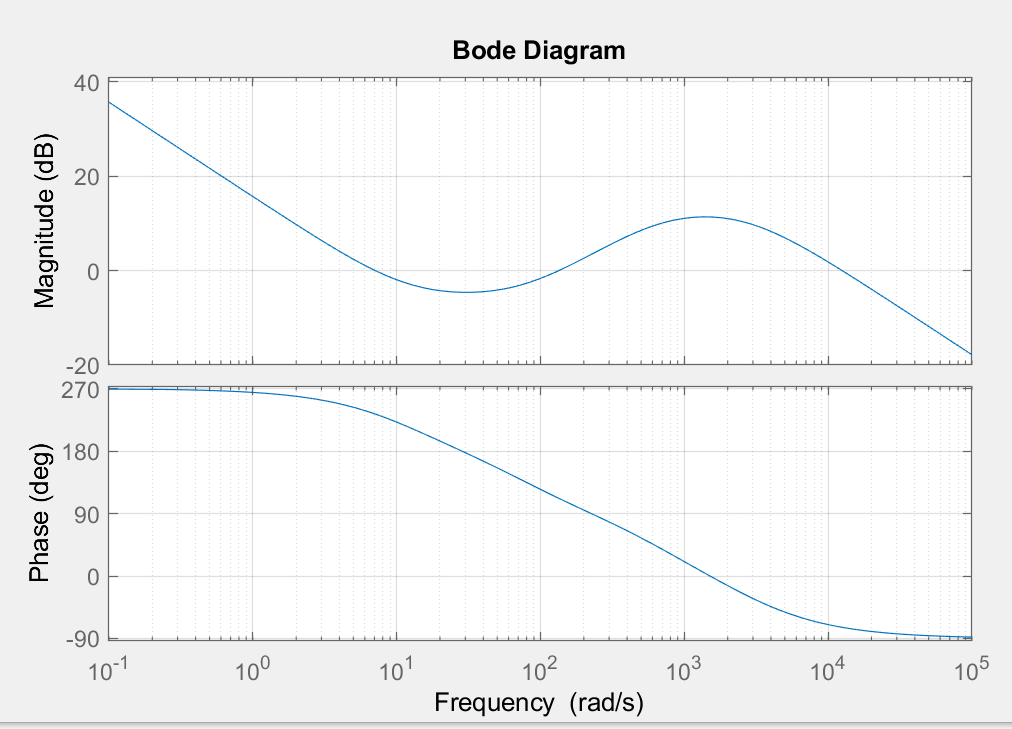
[picture p36: figure]

Рис.3.21. Диаграмма Боде разомкнутой системы

Как можно видеть по рис. 3.21, там где ЛАЧХ положительна, фазовый сдвиг не достигает отметки -180 ° , что доказывает устойчивость данной системы.

Последним действием c помощью команды margin(W) выведем диаграмму Боде с отмеченными на ней запасами устойчивости исследуемой системы (рис.3.22.).

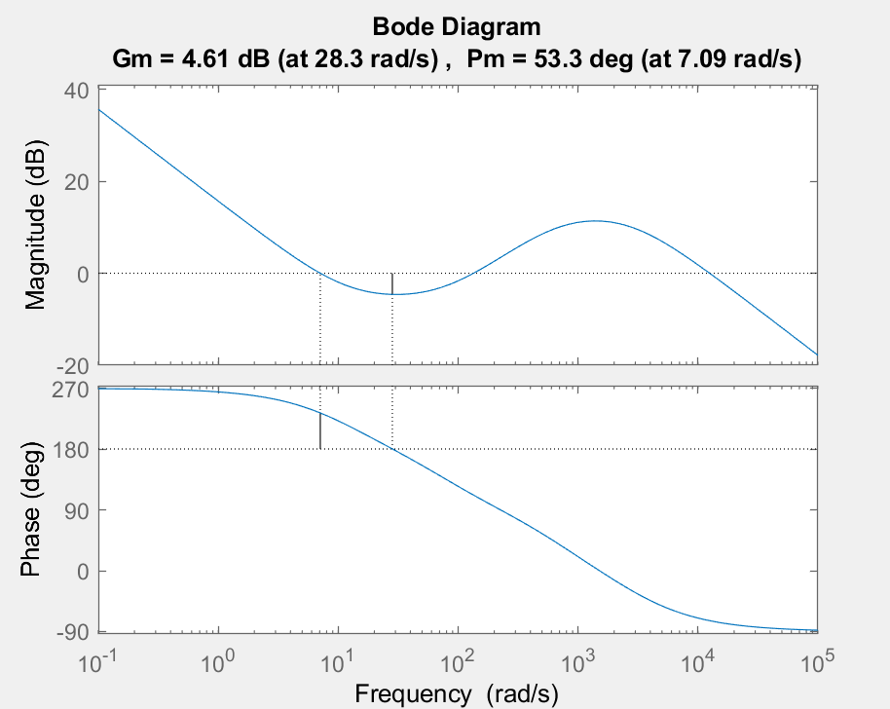
[picture p37: figure]

Рис.3.22. Диаграмма Боде с отмеченным запасом устойчивости

Как видно из рис.3.22, запас по амплитуде (Gm) равен 4.6 дБ, что значит можно ставить коэффициент усиления в пределах этого значения и система останется стабильна, а запас по фазе (Pm) составляет 53 ° , что позволит сдвигать фазу системы в пределах этого значения также без потери устойчивости.

Таким образом, в данном разделе мы подтвердили устойчивость системы управления с робастным ПИД-регулятором методами Гурвица, Михайлова, Найквиста и Боде, а также узнали запасы устойчивости по амплитуде и по фазе для данной системы.

# 3.5. Настройка нечеткого регулятора

Нечёткий регулятор (англ. fuzzy controller) — регулятор, построенный на базе нечеткой логики.

Для реализации нечеткого регулятора необходимо:

1. Определить входные лингвистические переменные. Например, «Ошибка» и «Изменение ошибки».
2. Определить лингвистическую переменную, которую мы хотим получить. В данном случае это будет лингвистическая переменная «Напряжение».
3. Определить правила образования результирующей переменной из входных переменных.

В результате, мы получим возможность определять необходимые нам значения, такие как напряжение, подаваемое на двигатель или любое другое необходимое значение.

Блок-схема для настройки данного регулятора показана на рис.3.23.

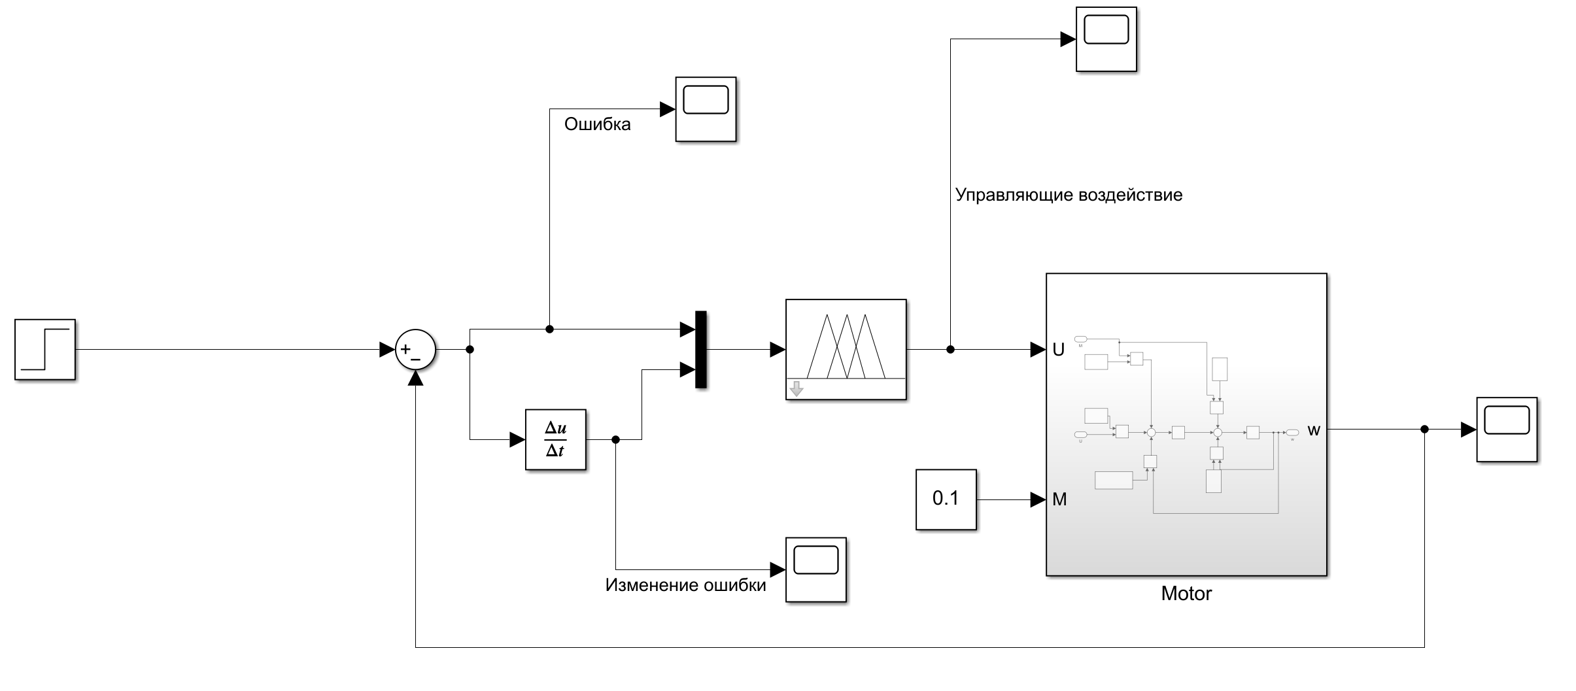
[picture p38: figure]

Рис.3.23. Блок-схема настройки нечеткого регулятора

На вход блока нечеткого регулятора через мультиплексор подаются два сигнала: сигнал расхождения текущего значения угловой скорости и желаемым ее значением (сигнал ошибки), а также сигнал изменения ошибки изменения во времени (сигнал скорости изменения ошибки), выходом же данному блоку служит одно лишь значение управляющего напряжения.

По количеству входных и выходных сигналов с помощью интерфейса настройки нечетких регуляторов настроим входные и выходные лингвистические переменные (ошибка и скорость изменения ошибки – входные лингвистические переменные, напряжение – выходная лингвистическая переменная) рис.3.24.

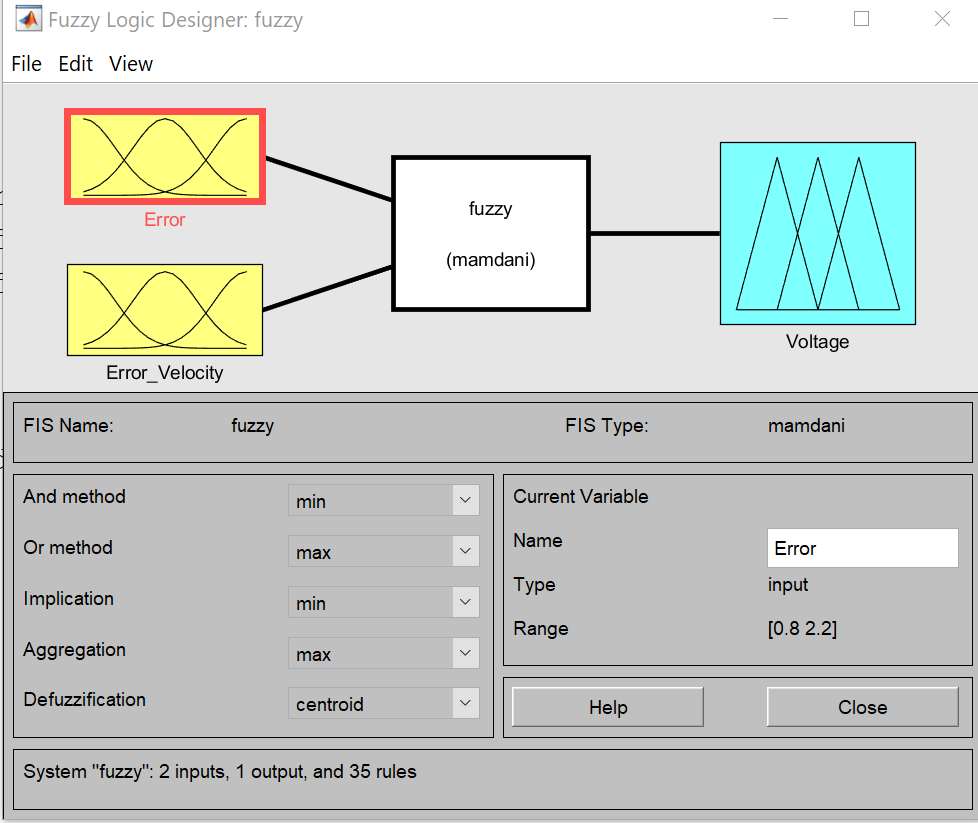
[picture p39: figure]

Рис.3.24. Интерфейс настройки лингвистических переменных

Путем предварительных оценок работы системы и того, в каких диапазонах ошибок и скоростей их изменения она будет работать, были определены термы для каждой лингвистической переменной (рис. 3.26, 3.25 и 3.27). Настройка термов осуществляется путём указания диапазонов для графиков функций принадлежности (графа Params); там же можно выбрать тип графика функции принадлежности (графа Type). Таким образом была выполнена процедура фаззификации.

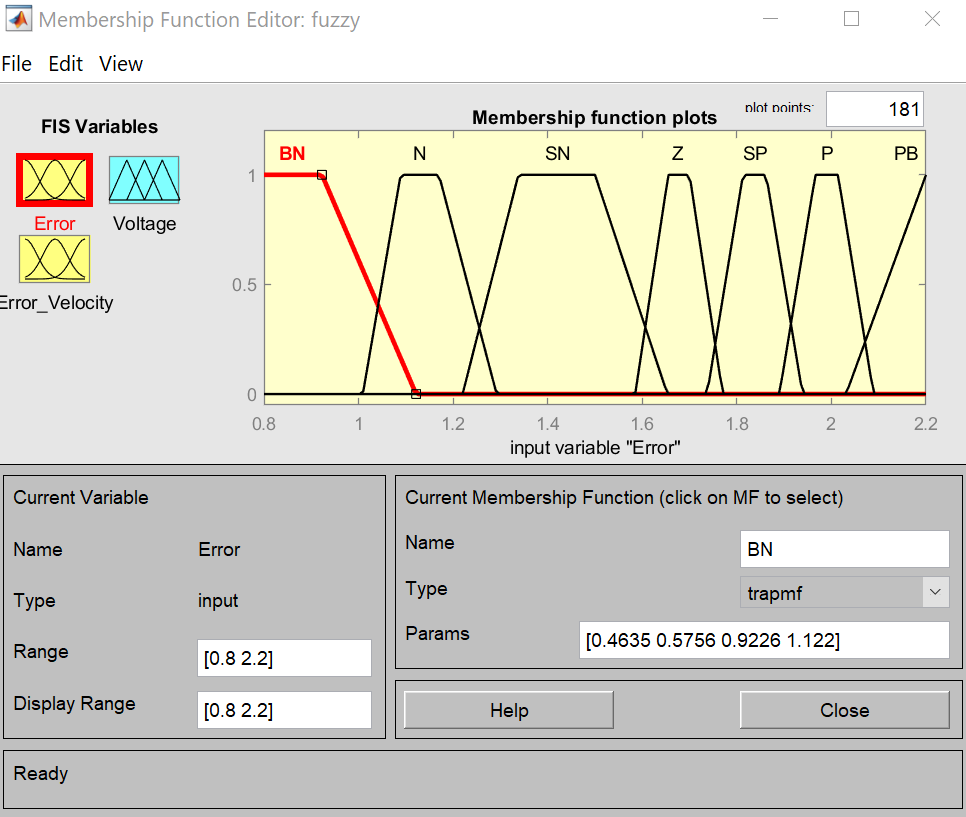
[picture p40: figure]

Рис.3.25. Настройки терм для входной лингвистической переменной ‘Ошибка’

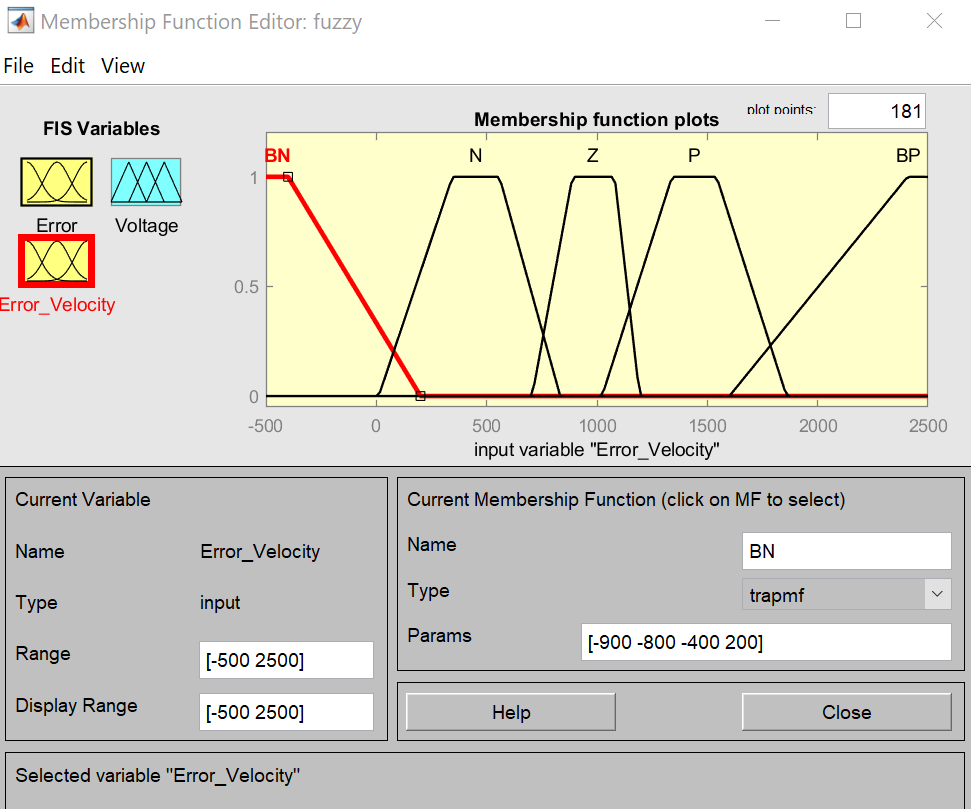
[picture p41: figure]

Рис.3.26. Настройки терм для входной лингвистической переменной ‘Скорость изменения ошибки’

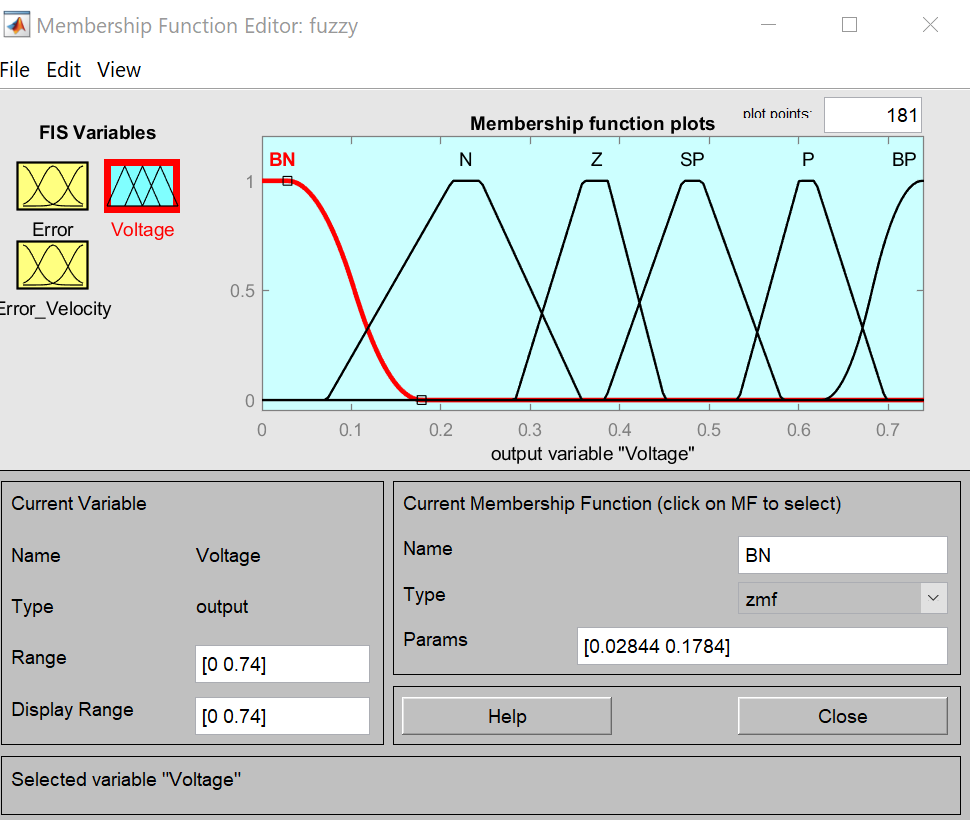
[picture p42: figure]

Рис.3.27. Настройки терм для выходной лингвистической переменной ‘Напряжение’

Также были заданы правила нечеткого регулятора (рис.3.28). Правила формируются следующим образом: в трёх графах (error is, error_velocity is, Voltage is) выбираются необходимые термы лингвистических переменных, после чего, нажимая на кнопку Add rule, мы создадим правило для нечёткого регулятора. Всего было сформировано 35 правил. Таким образом была выполнена процедура дефаззификация.

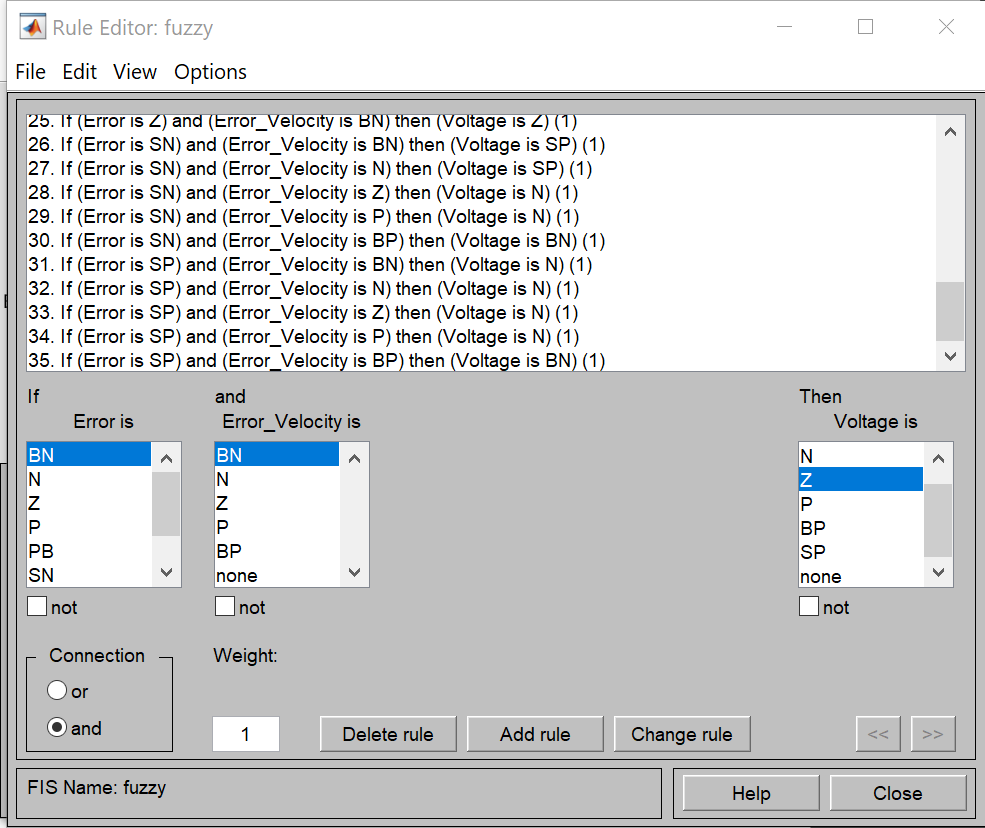
[picture p43: figure]

Рис.3.28. Список правил нечеткого регулятора

После экспорта настроенного fuzzy-регулятора в Matlab-переменную, построим график переходного процесса (рис.3.29).

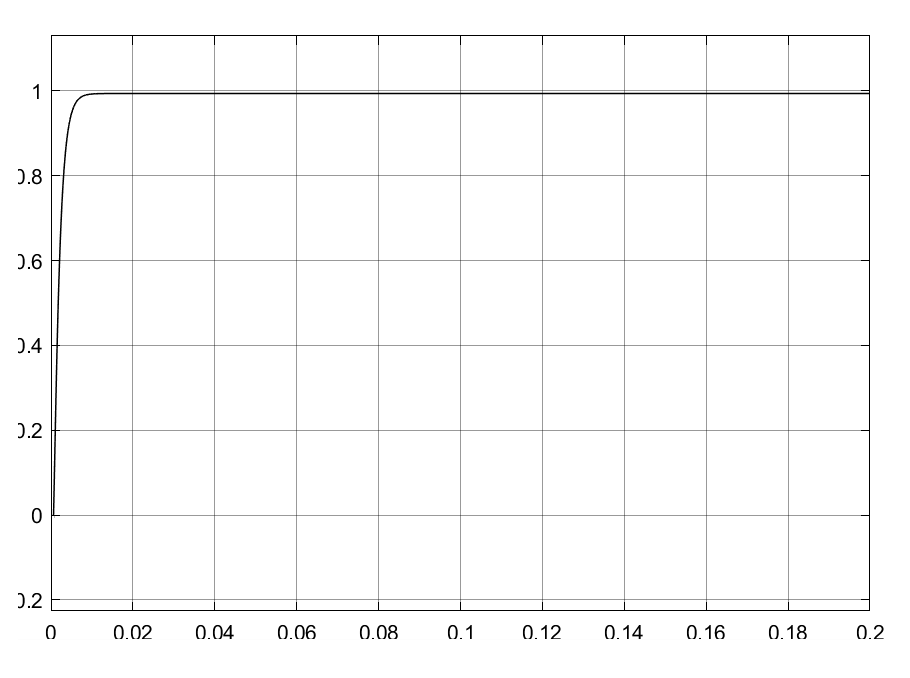
[picture p44: figure]

Рис.3.29. График переходного процесса с настроенным нечетким регулятором

Как можно видеть по рис.3.29, σ=0%; t_(уст) =0.02(с); n=0; δ=0%.

Далее, построим графики ошибки, изменения ошибки и управляющего воздействия (рис.3.30, 3.31, 3.32).

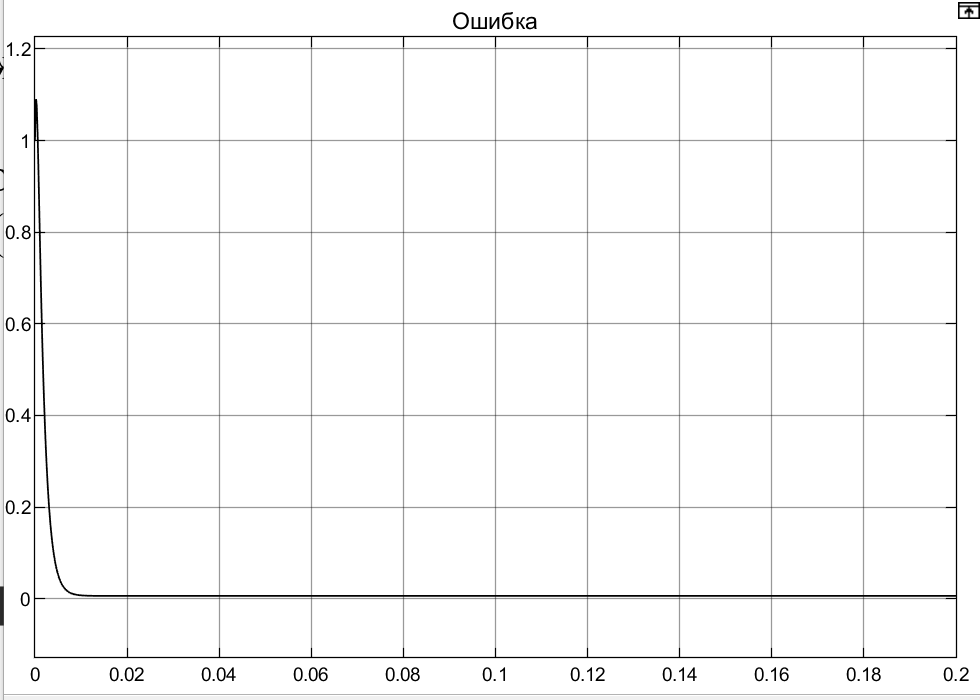
[picture p45: figure]

Рис.3.30. График ошибки переходного процесса с настроенным нечетким регулятором

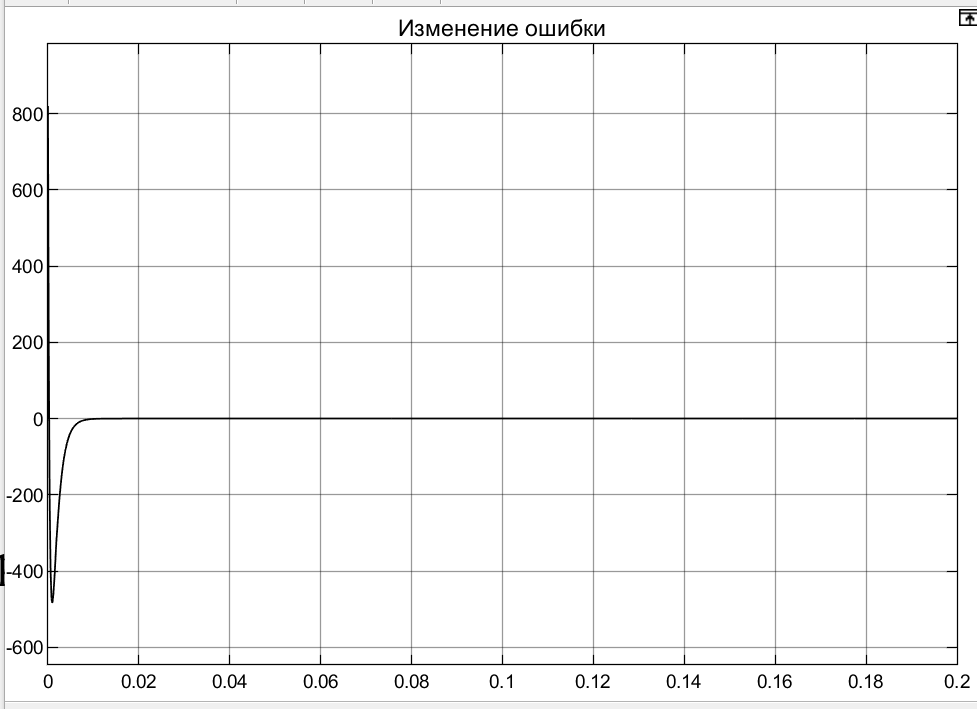
[picture p46: figure]

Рис.3.31. График ошибки переходного процесса с настроенным нечетким регулятором

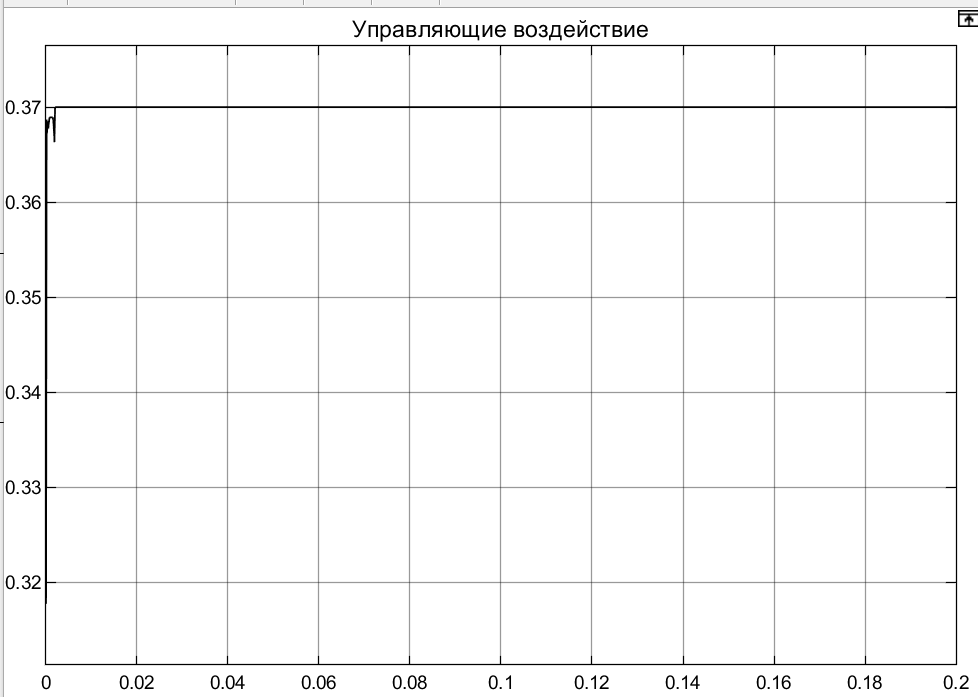
[picture p47: figure]

Рис.3.32. График управляющего воздействия нечеткого регулятора

Анализируя графики, мы можем видеть, что выходное управляющее воздействие нечёткого регулятора является многоступенчатым, что говорит о том, что при его формировании задействовано большинство из составленных нами правил. 3-D изображение зависимости трех лингвистических переменных представлено на рисунке 3.32.

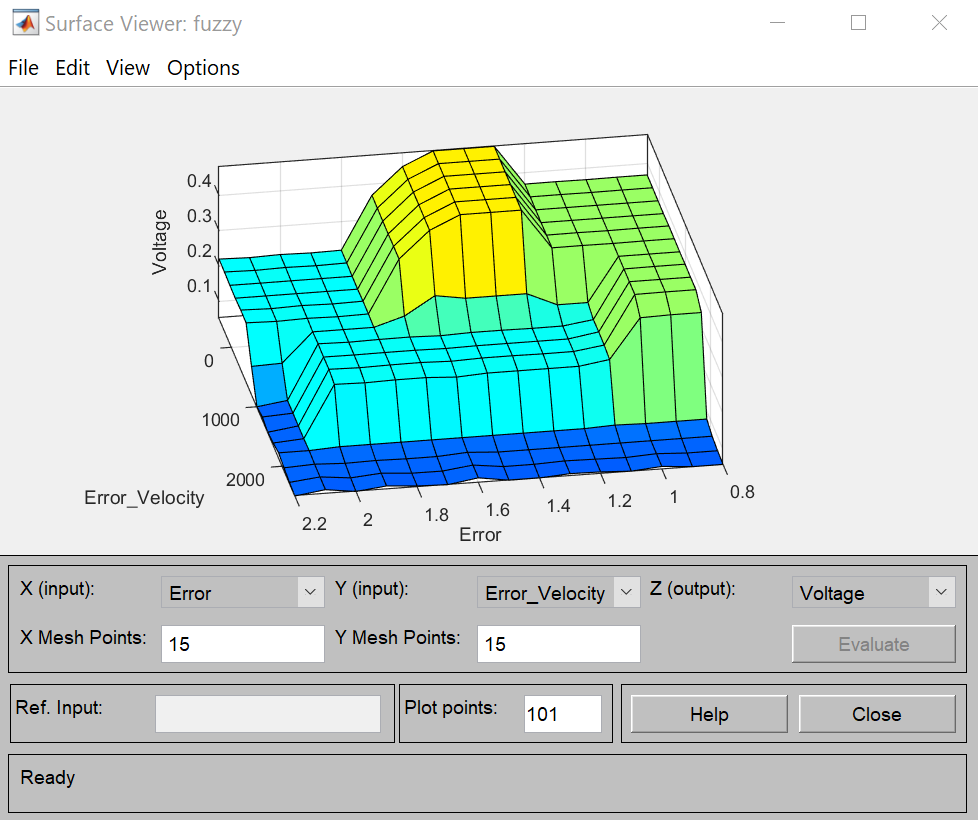
[picture p48: figure]

Рис.3.32. 3-D изображение зависимости трех лингвистических переменных

По данному графику можно судить о правильности настройки регулятора: на поверхности не должно быть резких спадов и скачков, а значения переменной Voltage должны плавно возрастать от 0 до заданного максимума.

Полученное качество переходного процесса ( σ=0%; t_(уст) =0.02(с); n=0; δ=0% ) удовлетворяет требованиям, следовательно, настройку нечеткого регулятора можно считать успешной.

Таким образом, в данной главе был успешно настроен нечеткий регулятор системы управления приводом колеса. Сравнивая качество переходного процесса с ПИД-регулятором и нечетким регулятором, видно, что нечеткий регулятор намного быстрее справляется с задачей, время установления системы с нечетким регулятором более чем в 100 раз меньше времени установления той же системы с ПИД-регулятором.

# 3.6. Настройка ПИД-регулятора САУ привода подъемного механизма шасси

Настроим ПИД-регулятор САУ привода подъемного механизма шасси в идеальном случае (без учета нелинейности и робастности системы).

Блок-схема для настройки данной САУ показана на рис.3.33.

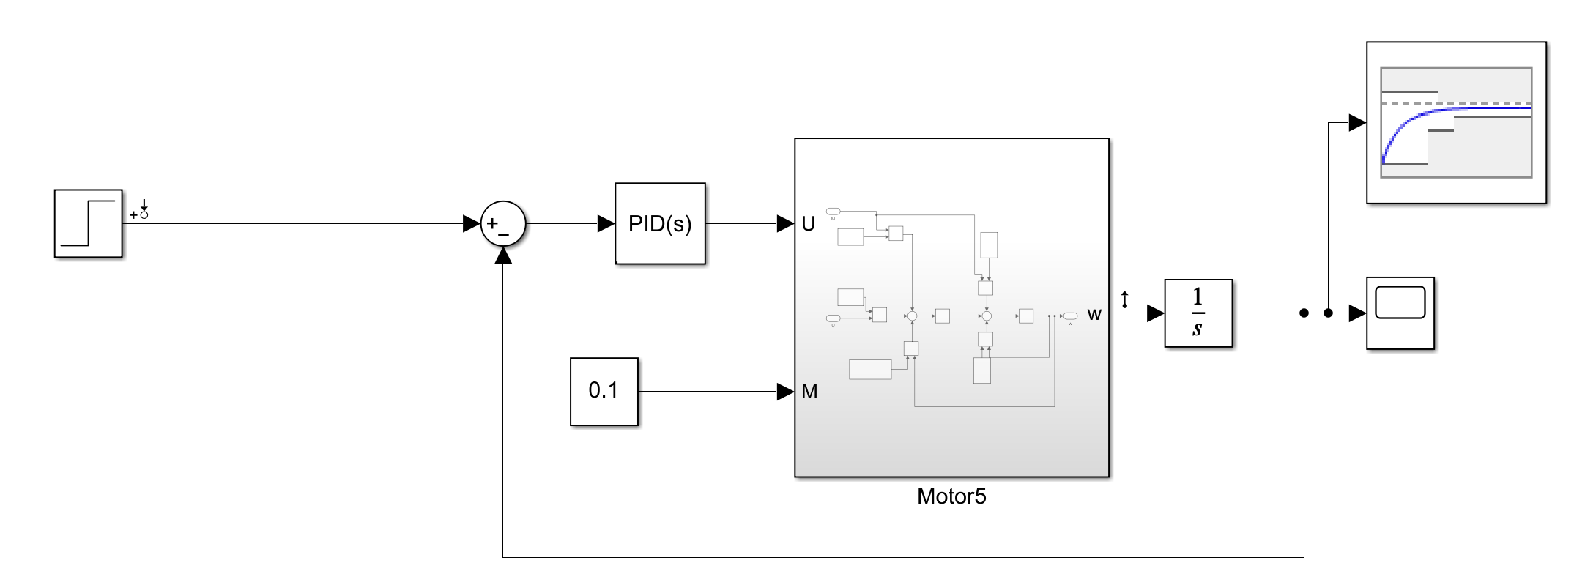
[picture p49: figure]

Рис.3.33. Блок-схема оценки качества переходного процесса

Подсистема ‘Мотор’ устроена также, как в параграфе 3.3.1.

В командном окне MATLAB необходимо ввести переменные, обозначающие параметры настраиваемого электродвигателя, как показано на рис.3.34.

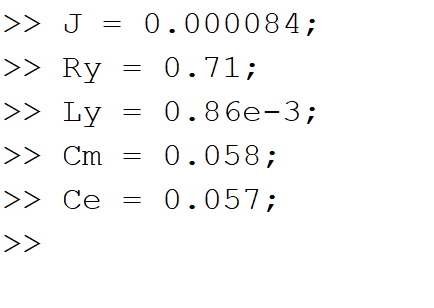
[picture p50: figure]

Рис.3.34. Параметры электродвигателя механизма подъема шасси

С помощью Model Linearizer с закомментированным ПИД-регулятором выведем характеристику переходного процесса исходной системы (рис.3.35).

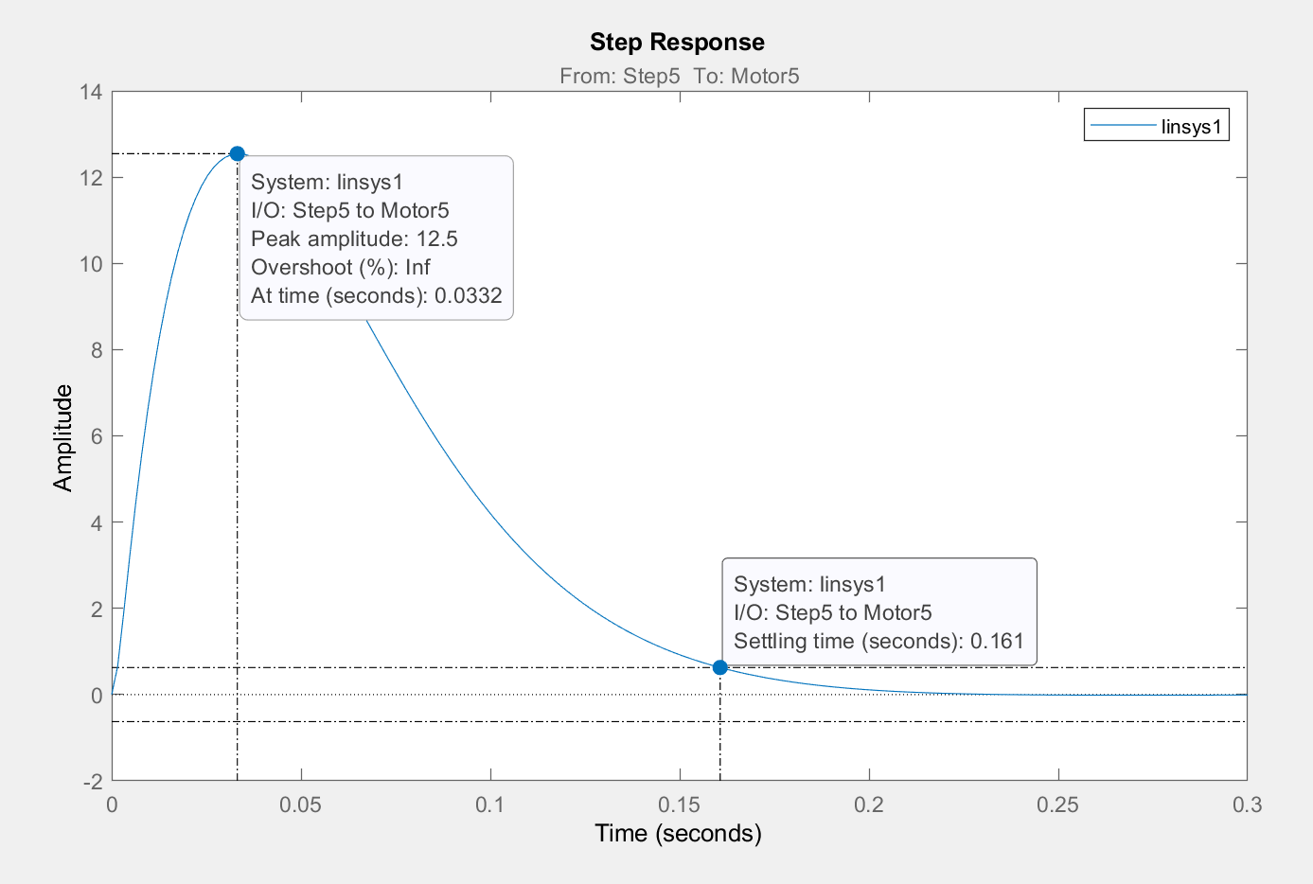
[picture p51: figure]

Рис.3.35. Параметры переходного процесса системы без регулятора

Как видно из рис.3.35, перерегулирование очень велико, статическая ошибка составляет δ=(1-0)/1=1 , присутствует колебательность, поэтому необходимо добавить ПИД-регулятор.

Настроим ПИД-регулятор с помощью блока CSRC. После настройки имеем такие параметры переходного процесса (рис.3.36).

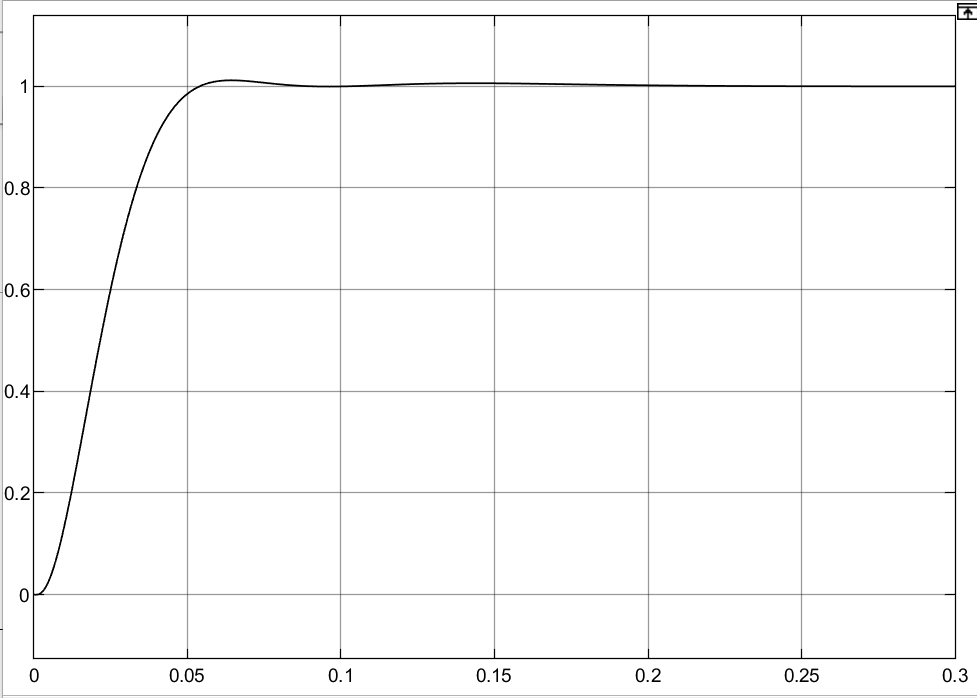
[picture p52: figure]

Рис.3.36. Характеристики переходного процесса с настроенным ПИД-регулятором

Как видно, перерегулирование пропало, статическая ошибка также стала равна 0, колебательность исчезла. Данное качество удовлетворяет требованию ТЗ, так что можно считать настройку ПИД-регулятора завершенной. Коэффициенты регулятора получились такими: Kp = 3.3, Kd = 0, Ki= 55.9.

Анализируя полученные коэффициенты, можно сделать вывод о том, что для корректной работы выбранного привода в идеальных условиях достаточно всего лишь ПИ-регулятора, что существенно упростит итоговую систему управления. Но в данной настройке не были учтены все нюансы реальной приводной системы, их мы учтем в следующих главах.

# 3.7. Настройка ПИД-регулятора подъемного механизма шасси с учетом нелинейности привода

В разделе 3.6 мы настроили САУ привода без учета нелинейности системы мотора. На самом деле в любом приводе присутствуют два нелинейных эффекта – зона нечувствительности и зона насыщения.

Зона нечувствительности n (на примере электродвигателя) выражается в том, что электрический двигатель имеет определённый минимальный ток трогания (i=n), до достижения которого вал двигателя будет неподвижен. В гидравлическом же двигателе золотник имеет так называемую зону перекрытия (его поршенёк немного шире отверстия, им закрываемого), вследствие чего он откроет путь рабочей жидкости в цилиндр двигателя, только переместившись на некоторую величину x=n. Аналогично и в случае пневмодвигателя, где роль золотника играет заслонка.

Зона насыщения обнаруживается в том, что при увеличении тока в приводе управляющего органа сверх некоторого значения i=b скорость перемещения управляющего органа остаётся постоянной; также и для гидравлического двигателя, когда окна золотника полностью открыты.

В Simulink за зону нечувствительности отвечает блок Dead Zone, а за зону насыщения – блок Saturation.

Составим блок-схему настройки ПИД-регулятора с учетом эффектов нелинейности, рис.3.37.

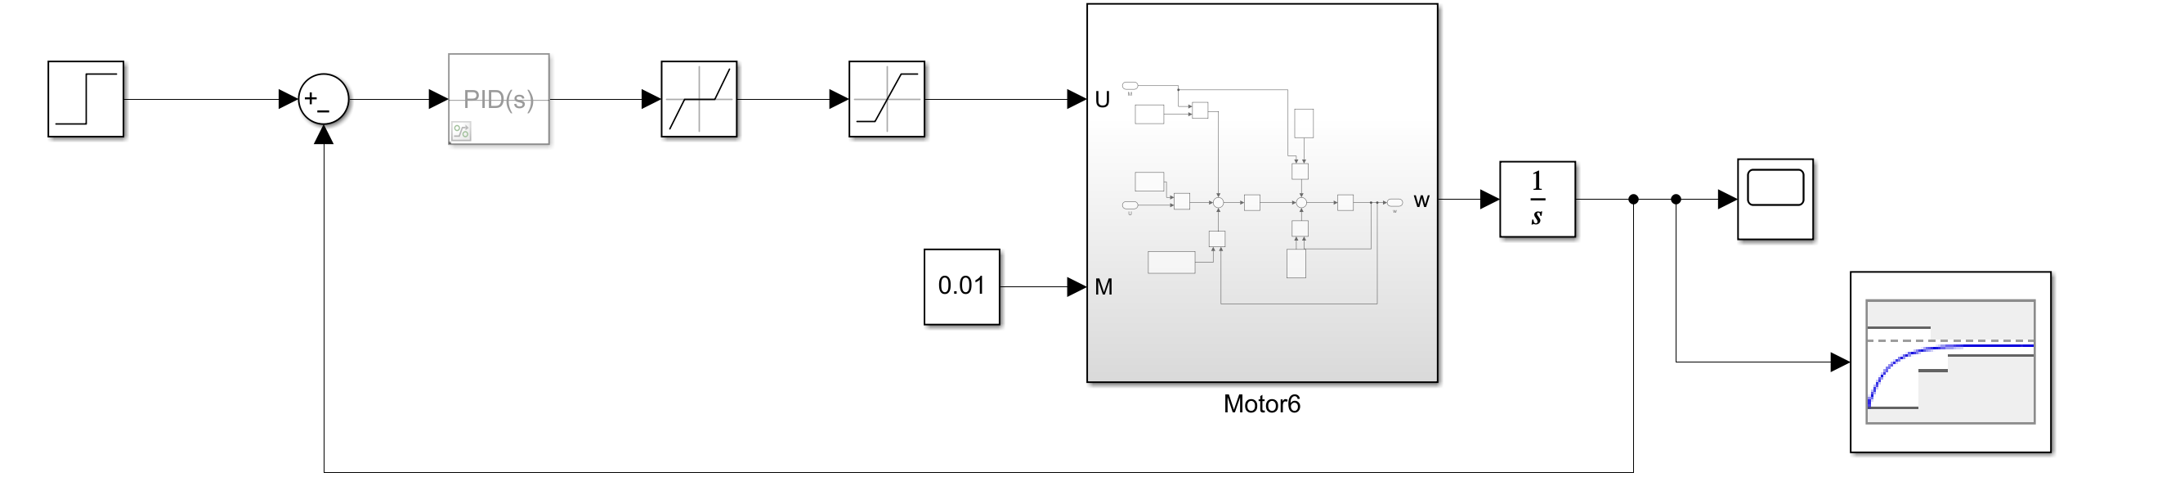
[picture p53: figure]

Рис.3.37. Блок-схема настройки регулятора нелинейной САУ

Для Dead Zone значение коэффициента ограничителя возьмем равным b=0.8, а значение коэффициента нечувствительности для Saturation зададим равным a=0.183.

Переходная характеристика нелинейной САУ механизма подъема шасси с закомментированным регулятором показана на рис.3.38.

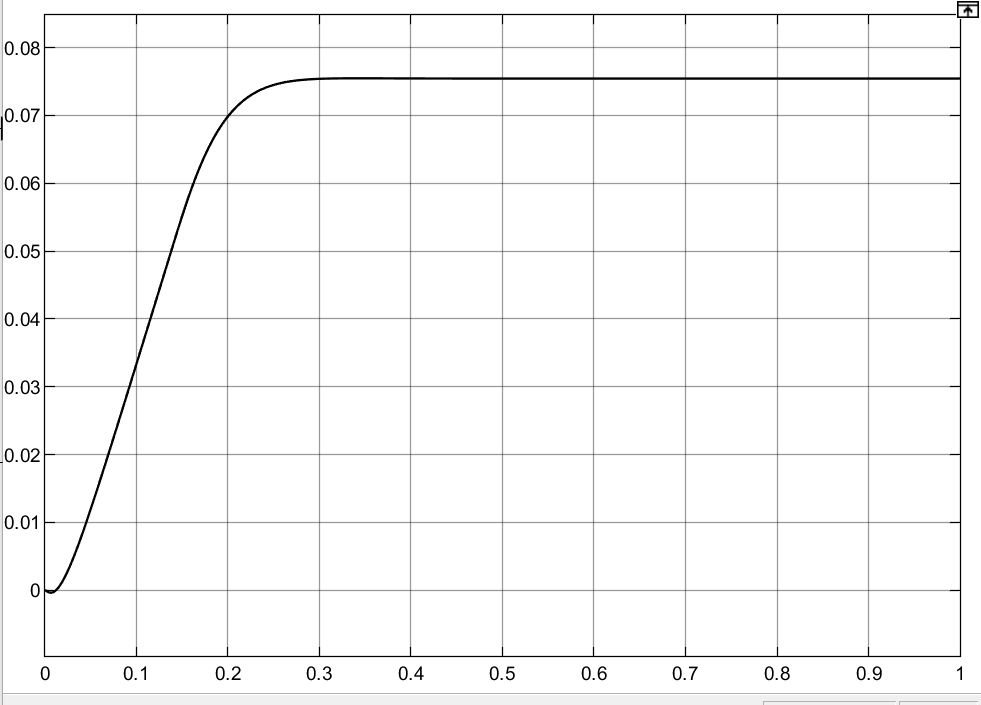
[picture p54: figure]

Рис.3.38. Переходная характеристика ненастроенной нелинейной САУ

Как видим, присутствует сильная колебательность и очень большая статическая ошибка δ=1-0.075=0.925 , перерегулирование, судя по графику, составляет σ=0% . Время установления составляет 0.25 с. Стоит также отметить, что при значении момента сопротивления больше чем 0.01 наблюдается реверс движения двигателя.

Приступим к настройке ПИД регулятора. Для начала настроим переменные для оптимизации, также как это сделано на рис.3.7. Затем проведем оптимизацию. Параметры переходного процесса после оптимизации показаны на рис.3.39.

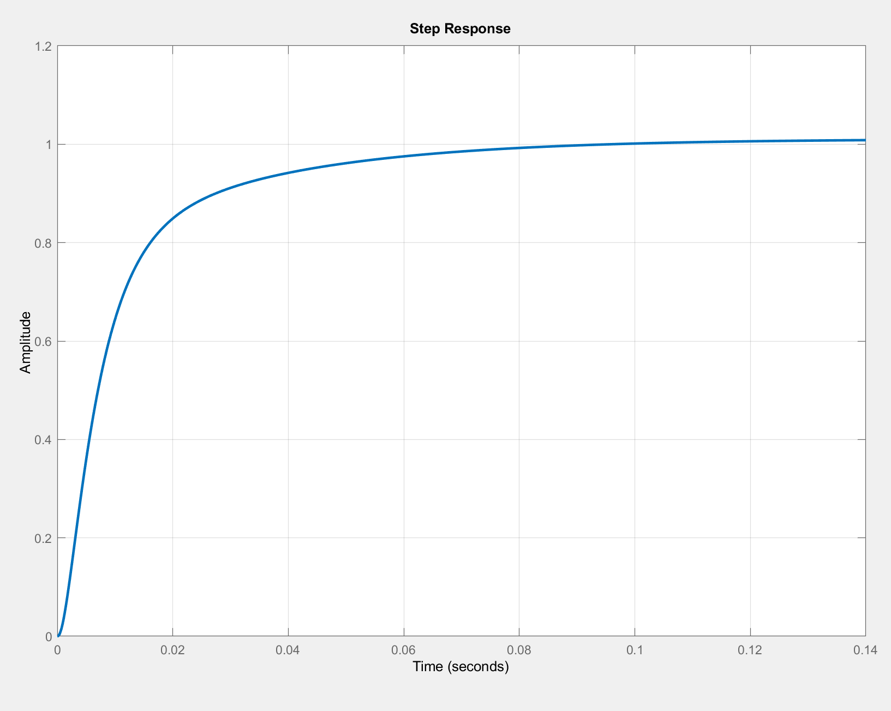
[picture p55: figure]

Рис.3.39. Характеристики настроенной САУ

Коэффициенты ПИД-регулятора получились такими: Kp = 4.5, Ki = 4.1, Kd = 0.1.

Как можно увидеть, ПИД-регулятор успешно устранил колебательность и статическую ошибку. Время установления теперь составляет 0.06 с. Такие характеристики переходного процесса полностью удовлетворяют требованиям ТЗ.

Таким образом, в данном разделе была настроена САУ привода механизма подъема шасси с учетом нелинейности его системы. На этот упростить регулятор, выкинув из него одну из составляющий, не получилось. Но в данной главе мы не учитывали такой эффект системы управления, как задержка обратной связи, ее мы учтем в следующей главе.

# 3.8. Настройка ПИД-регулятора подъемного механизма шасси с учетом задержки системы управления

В настоящей системе управления отклик на изменение входного сигнала происходит не мгновенно. Это происходит, в основном, из-за задержек, необходимых на получение данных обратной связи и их обработку.

Настроим САУ привода с учетом запаздывания τ=0.5c .

В программном пакете MATLAB/Simulink функцию запаздывания реализует блок Transport Delay. Составим схему для настройки САУ с запаздыванием, рис.3.40.

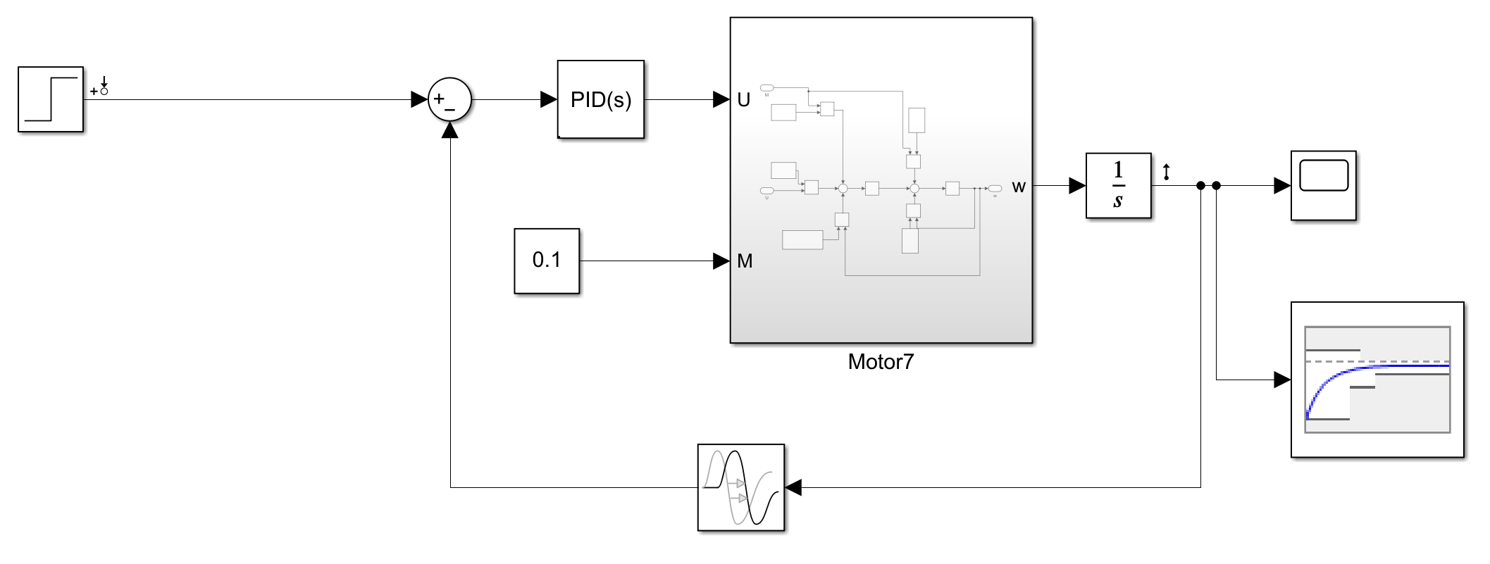
[picture p56: figure]

Рис.3.40. Математическая модель САУ с запаздыванием

Узнаем исходные характеристики переходного процесса с помощью Model Linearizer. Полученный график переходного процесса показан на рис.3.41.

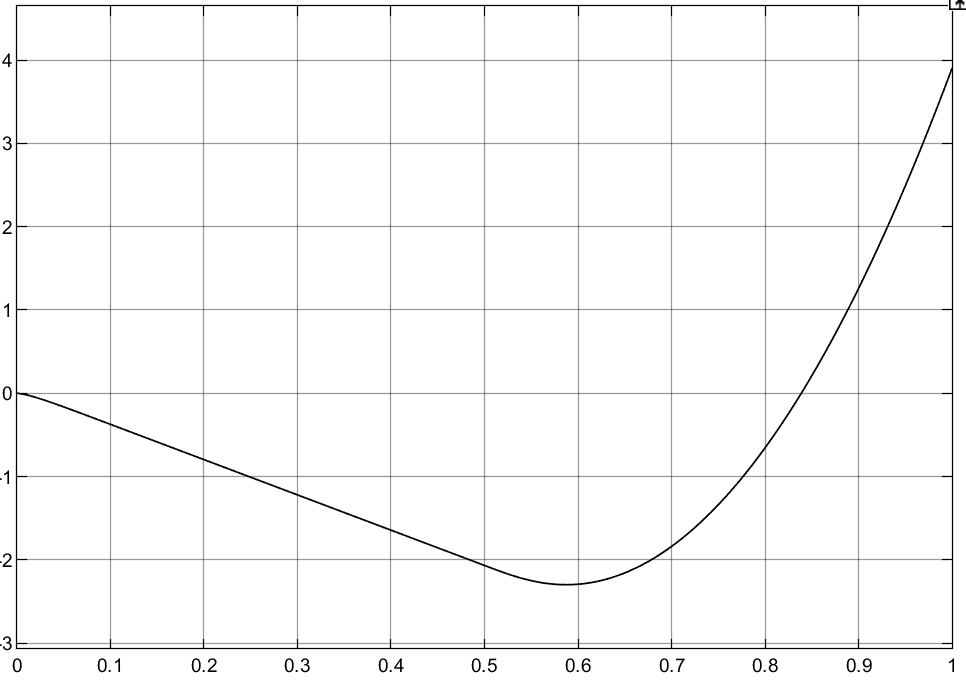
[picture p57: figure]

Рис.3.41. Параметры переходного процесса ненастроенной САУ

По графику видим, что система вообще не стабильна, это говорит о необходимости введения в систему ПИД-регулятора.

Приступим к настройке ПИД регулятора. Для начала настроим переменные для оптимизации, также как это сделано на рис.3.7. Затем проведем оптимизацию. Параметры переходного процесса после оптимизации показаны на рис.3.42.

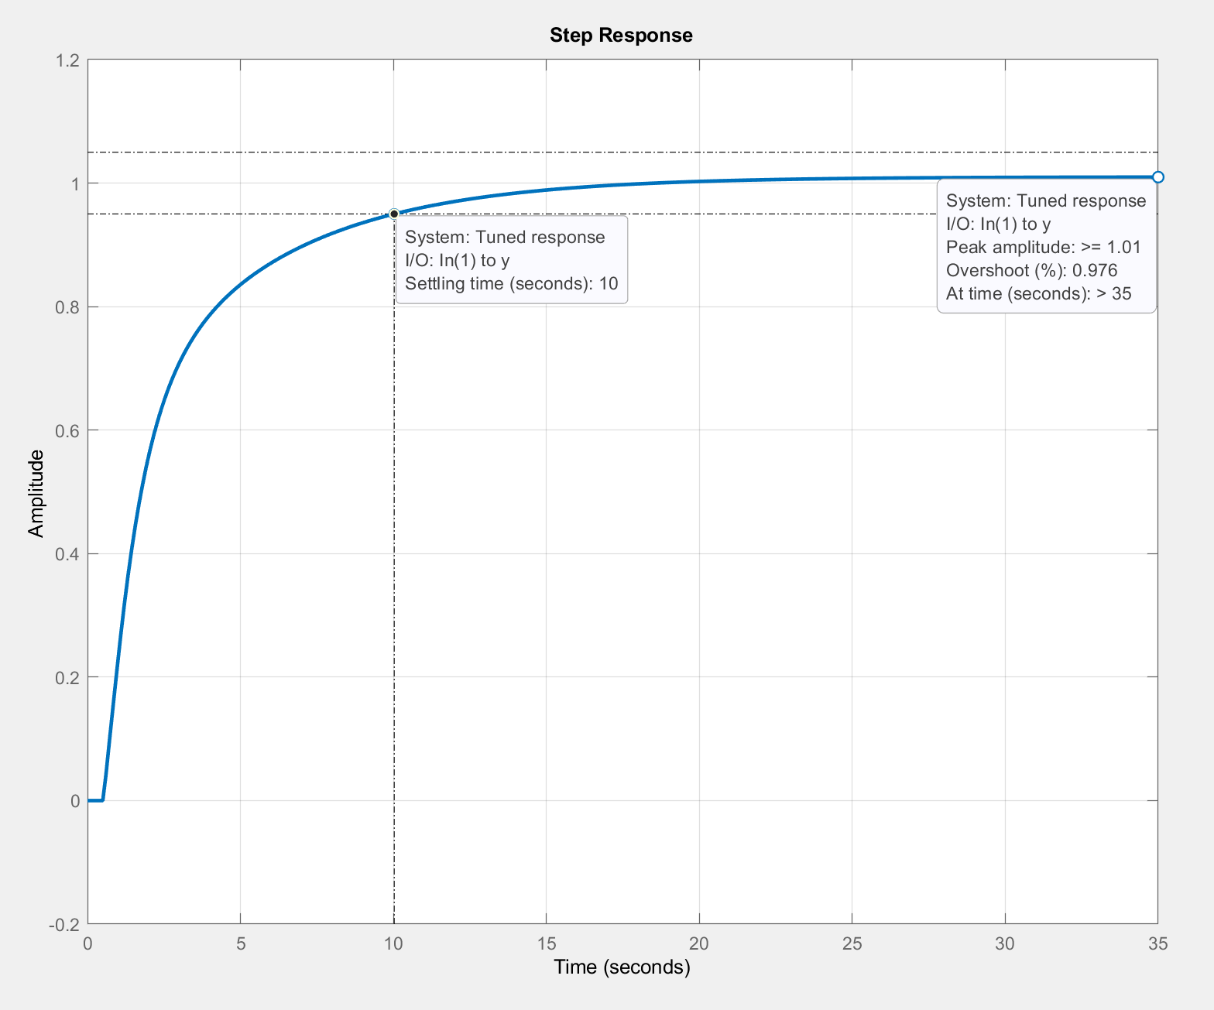
[picture p58: figure]

Рис.3.42. Параметры переходного процесса с настроенным регулятором

Как видно, статическая ошибка и перерегулирование были устранены, система была стабилизированна. Это вызвано как раз наличием задержки в цепи обратной связи. Получились следующие коэффициенты ПИД-регулятора: Kp = 0.02, Ki = 0, Kd = 0.02.

Таким образом в данном разделе мы настроили САУ с учетом наличия задержки 0.5 с в цепи обратной связи. Анализируя полученные во время настройки данные, можно сказать, что задержка на обработку обратной связи в проектируемой САУ не должна быть больше 0.5 секунд, иначе данная система управления не будет справляться с поставленной задачей. В данном случае оказалось достаточно ПД-регулятора. Осталось учесть только один эффект – робастность привода.

# 3.9. Настройка ПИД-регулятора механизма подъема шасси с учетом робастности системы управления

В реальной системе управления параметры двигателя могут колебаться от двигателя к двигателю. В этом и заключается один из признаков робастной САУ – некоторые их параметры могут изменяться в заданных границах.

Главной задачей синтеза робастных систем управления является поиск закона управления, который сохранял бы выходные переменные системы и сигналы ошибки в заданных допустимых пределах несмотря на наличие неопределенностей в контуре управления.

Попробуем настроить такую систему управления. Блок-схема для проведения настройки показана на рис. 3.43.

Рис.3.43. Блок-схема настройки робастной САУ

В данном случае изменяемыми являются параметры двигателя (сопротивление якоря ( R_я ) и индуктивность якоря ( L_я )). Зададим диапазон изменения этих переменных 20%. Зная это, рассчитаем максимальные и минимальные значения этих параметров:

L_(я-min) =0.86*10^(-3) -0.86*10^(-3) *0.2=6.9*10^(-4) Гн; L_(я-max) =0.86*10^(-3) +0.86*10^(-3) *0.2=1*10^(-3) Гн;

R_(я-min) =0.71-0.71*0.2=0.568 Ом; R_(я-max) =0.71+0.71*0.2=0.852 Ом.

В меню Uncertain Variables Set блока Check Step Response Characteristics выбираем “неуверенные” переменные, выделим левой кнопкой мыши в правом поле переменные Ry, Ly, и нажатием стрелки переместим их в левое поле. Нажимаем Set Uncertain Values, где вводим вычисленные значения нижних и верхних границ переменных Ry и Ly (рис.3.44).

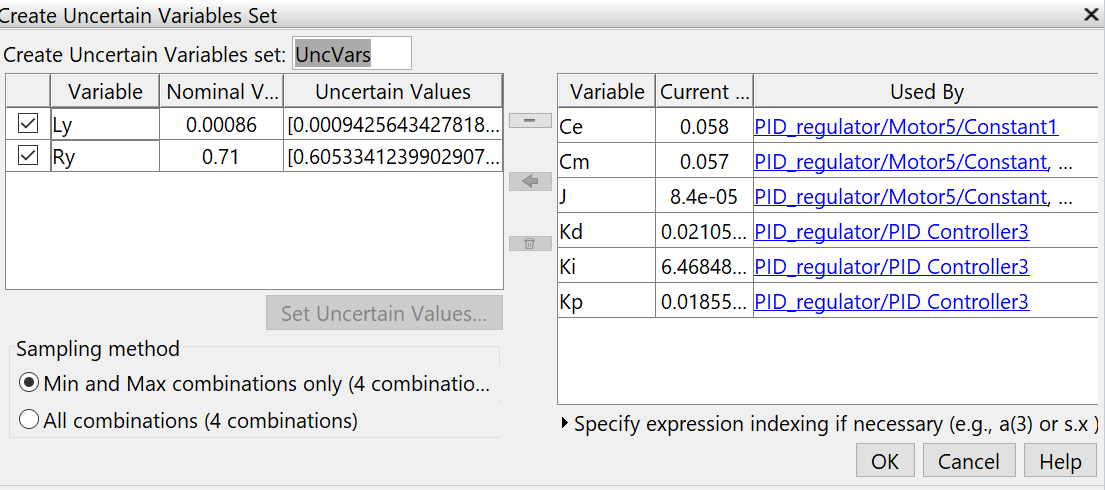
[picture p59: figure]

Рис.3.44. Настройка изменяемых параметров регулятора привода

Обычные переменные вводятся в расчёт через меню Design Variable Set.

Начнем процесс оптимизации. После его успешного завершения с помощью

Model Linearizer выведем Step Response для всех комбинаций значений двух ‘не уверенных’ переменных рис.3.45.

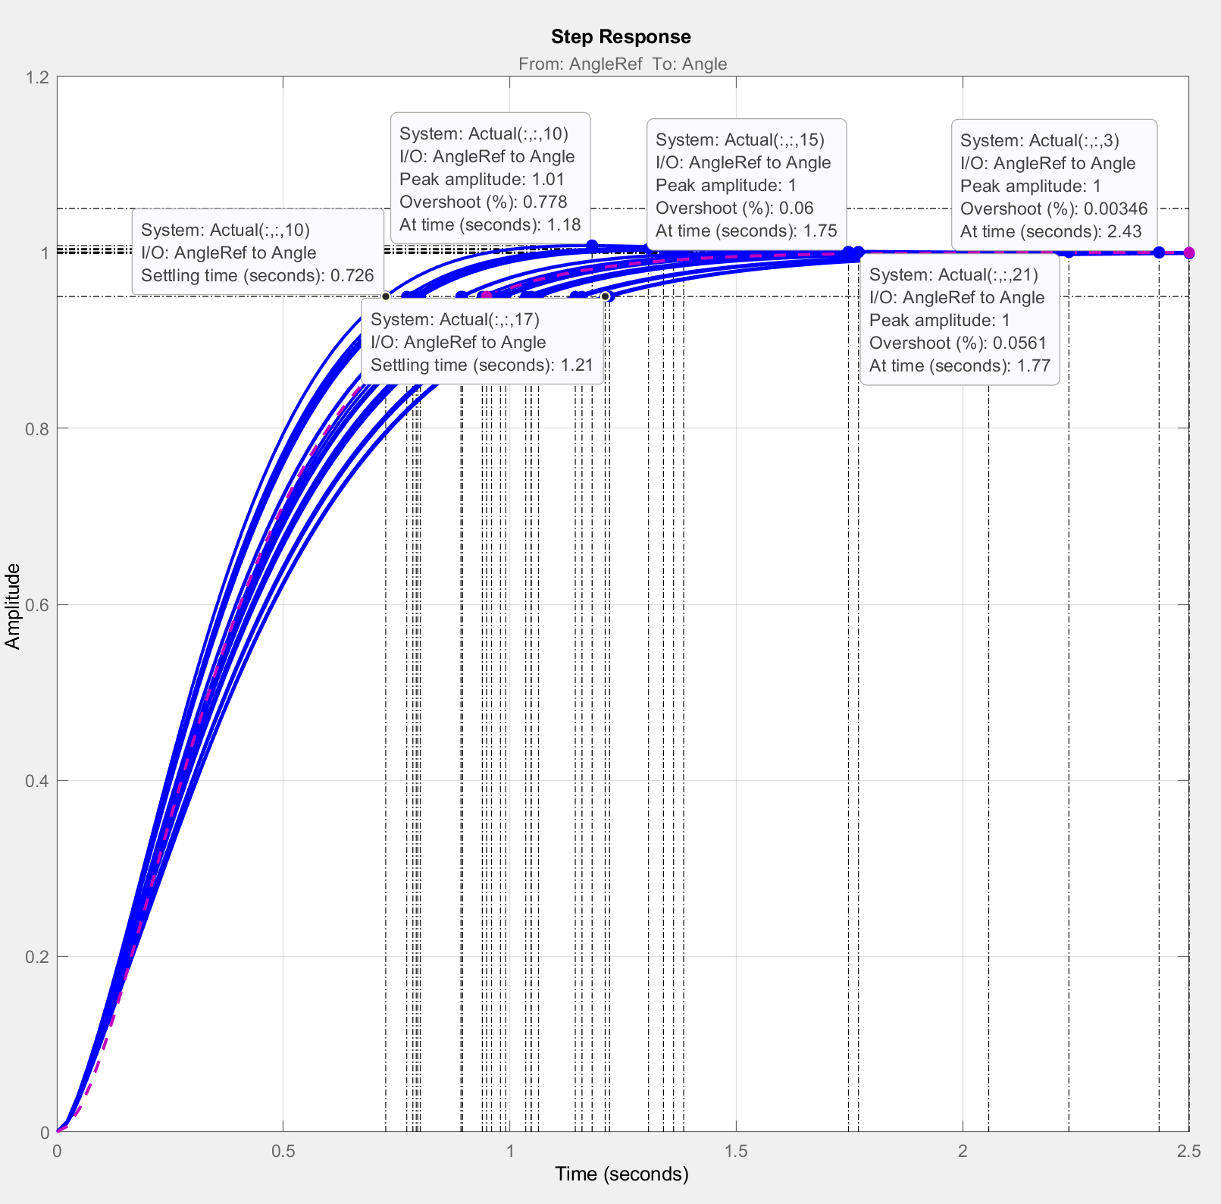
[picture p60: figure]

Рис.3.45. Step Response системы при разных комбинациях значений ‘неуверенных’ переменных

Как можно видеть, независимо от комбинации значений переменных, перерегулирование σ≈0 , статическая ошибка δ=0 , колебательности нет, а время установления находится в промежутке от 0.73 до 1.21с, что полностью удовлетворяет условиям ТЗ.

Коэффициенты ПИД-регулятора получились такими: K_p = 4.22, K_i = 75.6, K_d = 0.08.

Подводя итог параграфам 3.6-3.9, можно сказать что в них были успешно настроены ПИД-регуляторы, обеспечивающие заданные по ТЗ характеристики управления контурами приводов механизмов подъема переднего шасси, с учетом таких эффектов систем управления привода, как нелинейность, робастность и задержка обработки данных обратной связи.

# 3.10. Проверка устойчивости САУ механизма подъема шасси методом Гурвица

Критерий устойчивости Гурвица формулируется так: для устойчивости линейной системы необходимо и достаточно, чтобы все n диагональных миноров, полученных из матрицы Гурвица (составленной из коэффициентов характеристического уравнения замкнутой системы), были положительны.

Рассмотрим устойчивость системы с ПИД-регулятором с коэффициентами от настройки робастной САУ ( K_p = 4.22, K_i = 75.6, K_d = 0.08 ). Передаточная функция ПИД-регулятора выглядит так:

W(P)=(K_d p^2 +K_p p+K_i)/p

Передаточная функция нашего двигателя выглядит так (выражение 3.6):

W_(дв) (P)=1/((L_я ∙J)/(C_m)∙p^2 +(R_я ∙J)/(C_m)∙p+C_e)

Нужно найти передаточную функцию разомкнутой системы как произведение передаточных функций двигателя и ПИД-регулятора:

W_(р.с) (P)=1/p*W_(дв) (P)*W(P)=(K_d p^2 +K_p p+K_i)/(p^2)*1/((L_я ∙J)/(C_m)∙p^2 +(R_я ∙J)/(C_m)∙p+C_e) = (K_d p^2 +K_p p+K_i)/((L_я ∙J)/(C_m)∙p^4 +(R_я ∙J)/(C_m)∙p^3 +C_e p^2) (3.15)

Вычислим значения коэффициентов полинома знаменателя:

(L_я ∙J)/(C_m)=1.3*10^(-6) ;

(R_я ∙J)/(C_m)=0.001; Ce=0.058.

Подставим числовые значения в (3.15):

W_(р.с) (P)=(0.08p^2 +4.22p+75.6)/(1.3*10^(-6) ∙p^4 +0.001∙p^3 +0.058p^2)

Теперь чтоб найти матрицу Гурвица, надо найти передаточную функцию замкнутой функцию. Введем переобозначения:

A=0.08p^2 +4.22p+75.6;B= 1.3*10^(-6) ∙p^4 +0.001∙p^3 +0.058p^2 ; W_(ос) =1.

С помощью новых обозначений запишем передаточную функцию замкнутой системы: W_(з.с) (P)=A/(B+W_(ос) *A)= (0.08p^2 +4.22p+75.6)/(1.3*10^(-6) ∙p^4 +0.001∙p^3 +0.058p^2 +0.08p^2 +4.22p+75.6)=(0.08p^2 +4.22p+75.6)/(1.3*10^(-6) ∙p^4 +0.001∙p^3 +0.138p^2 +4.22p+75.6) (3.16).

Теперь составим из коэффициентов характеристического уравнения полинома знаменателя матрицу Гурвица H (так как высшая степень у нас 4 – матрица будет 4х4):

a_0 =1.3*10^(-6) , a_1 =0.001, a_2 =0.138, a_3 =4.22, a_4 =75.6;

H=(0.001, 4.22, 0, 01.3*10^(-6) , 0.138, 75.6, 000, 0.0011.3*10^(-6) , 4.22, 00.138, 75.6)

Найдем теперь определители главный миноров:

∆_1 =0.001→ ∆_1 >0; ∆_2 = 0.001*0.138-4.22*1.3*10^(-6) =1.3*10^(-4) → ∆_2 >0;

∆_3 =0.001*0.138*4.22+4.22*75.6*0+1.3*10^(-6) *0 - 0*0.138 - 1.3*10^(-6) *4.22^2 -75.6*0.001^2 = 0.001*0.138*4.22-1.3*10^(-6) *4.22^2 -75.6*0.001^2 =4.8*10^(-4) →∆_3 >0;

∆_4 =0.037→∆_3 >0.

Раз все определители главных миноров больше 0 то по критерию Гурвица система устойчива.

# 3.11. Проверка устойчивости САУ механизма подъема шасси методом Михайлова

Критерий устойчивости системы управления Михайлова звучит так:

для устойчивости линейной системы необходимо и достаточно, чтобы годограф Михайлова при изменении ω от 0 до ∞ начинался на вещественной оси и проходил последовательно против часовой стрелки n квадрантов комплексной плоскости, не обращаясь в нуль и стремясь к ∞ в n-м квадранте.

Годографом Михайлова называют график на комплексной плоскости полинома знаменателя замкнутой системы.

Возьмем передаточную функцию замкнутой системы, полученную в выражении (3.16):

W_(з.с) (P)=(0.08p^2 +4.22p+75.6)/(1.3*10^(-6) ∙p^4 +0.001∙p^3 +0.138p^2 +4.22p+75.6)

Теперь возьмем характеристическое уравнение (полином знаменателя):

F(p)=1.3*10^(-6) ∙p^4 +0.001∙p^3 +0.138p^2 +4.22p+75.6 (3.17)

, и проведем замену оператора Лапласа p на jω :

F(jω)=1.3*10^(-6) ∙(jω)^4 +0.001∙(jω)^3 +0.138*(jω)^2 +4.22*jω+75.6. (3.18)

Выражение (3.18) является функцией для построения годографа Михайлова. По полученному выражению построим в среде MathCAD характеристику, отображающую состояние исследуемой САУ (рис.3.46, 3.47).

Рис.3.46. Годограф Михайлова (начало)

Рис.3.47. Годограф Михайлова (конец)

Как можно видеть на рис.3.46-47, годограф начинается из положительной точки на вещественной оси, не обращается в нуль и уходит в бесконечность в 4-ом квадранте, что подтверждает устойчивость системы.

# 3.12. Проверка устойчивости САУ привода механизма подъема шасси методом Найквиста

Критерий устойчивости Найквиста формулируется так: для устойчивости замкнутой системы необходимо и достаточно, чтобы амплитудно-фазовая характеристика устойчивой разомкнутой системы при изменении от 0 до ∞ не охватывала точку с координатами {-1;j0} .

Запишем передаточную функцию замкнутой системы (выражение 3.16):

W_(з.с) (P)=(0.08p^2 +4.22p+75.6)/(1.3*10^(-6) ∙p^4 +0.001∙p^3 +0.138p^2 +4.22p+75.6)

Найдем обратную ей функцию: W(p)=(1.3*10^(-6) ∙p^4 +0.001∙p^3 +0.138p^2 +4.22p+75.6)/(0.08p^2 +4.22p+75.6)

Теперь заменим в ней оператор Лапласа p на jω :

W(jω)=(1.3*10^(-6) ∙(jω)^4 +0.001∙(jω)^3 +0.138(jω)^2 +4.22jω+75.6)/(0.08(jω)^2 +4.22*jω+75.6) (3.17)

По выражению (3.17) построим график амплитудно-фазовая характеристика устойчивой разомкнутой системы (рис.3.48, 3.49).

Рис.3.48. АФЧХ устойчивой разомкнутой системы (начало)

Рис.3.49. АФЧХ устойчивой разомкнутой системы (конец)

Как видно из рис.3.48 и рис.3.49, АФЧХ устойчивой разомкнутой системы не охватывает точку комплексной плоскости с координатами {-1;j0} , значит замкнутая система устойчива.

# 3.13. Проверка устойчивости систему управления механизма подъема шасси критерием Боде и определение запаса ее устойчивости

Критерий устойчивости Боде формируется так: для устойчивости замкнутой системы необходимо и достаточно, чтобы на всех частотах, где ЛАЧХ разомкнутой системы положительная (L( ω ) > 0), фазовый сдвиг не достигал значения -180 ° или достигал его четное число раз.

Для того, чтобы проверить нашу передаточную функцию разомкнутой системы (выражение 3.15, W_(р.с) (P)=(0.08p^2 +4.22p+75.6)/(1.3*10^(-6) ∙p^4 +0.001∙p^3 +0.058p^2) ) по критерию Боде, введем ее с помощью функции tf() в командное окно MATLAB:

%коэффициенты

a2 = 0.08;

a1 = 4.22;

a0 = 75.6;

b4 = 1.3e-6;

b3 = 0.001;

b2 = 0.058;

b1 = 0;

b0 = 0;

W = tf([a2 a1 a0], [b4 b3 b2 b1 b0]); % передаточная функция

Затем функцией bode(W) построим диаграмму ЛАЧХ по критерию Боде (рис.3.50).

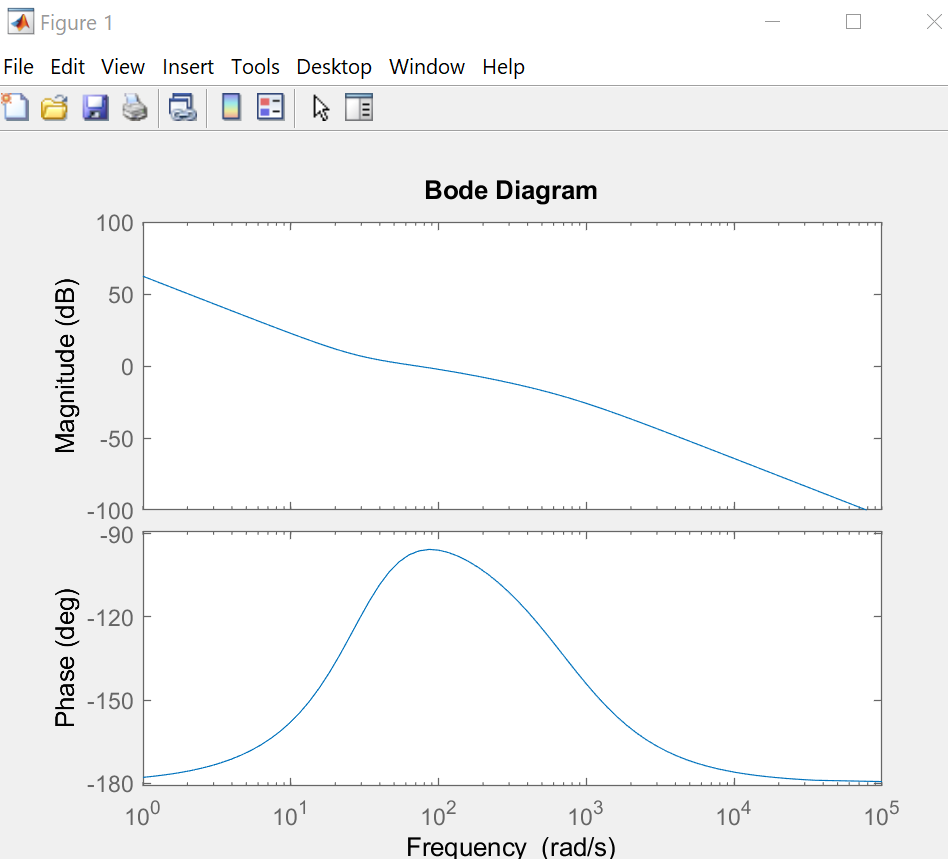
[picture p61: figure]

Рис.3.50. Диаграмма Боде разомкнутой системы

Как можно видеть по рис. 3.50, там где ЛАЧХ положительна, фазовый сдвиг не достигает отметки -180 ° , что доказывает устойчивость данной системы.

Последним действием c помощью команды margin(W) выведем диаграмму Боде с отмеченными на ней запасами устойчивости исследуемой системы (рис.3.51.).

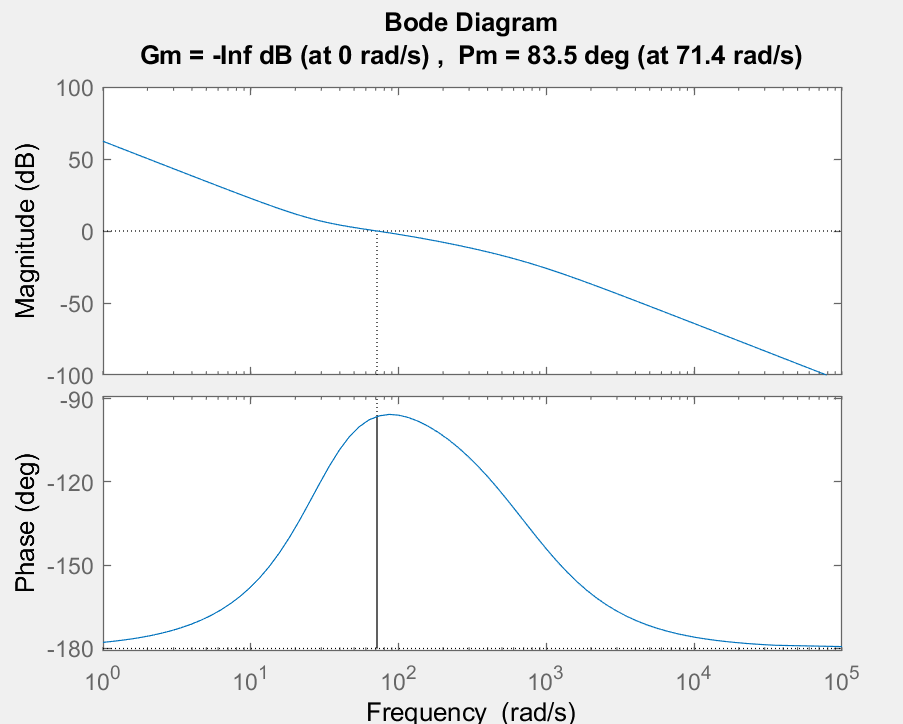
[picture p62: figure]

Рис.3.51. Диаграмма Боде с отмеченным запасом устойчивости

Как видно из рис.3.51, определись запас устойчивости по амплитуде не представляется возможным, так как график ЛФЧХ никогда не пересекает отметку в -180⁰, а запас по фазе составляет 83.5⁰, что позволит сдвигать фазу системы в пределах этого значения также без потери устойчивости.

Таким образом, в параграфах 3.10-3.13 мы подтвердили устойчивость системы управления механизма подъема шасси с робастным ПИД-регулятором методами Гурвица, Михайлова, Найквиста и Боде, а также узнали запасы устойчивости по амплитуде и по фазе для данной системы.

Подводя итог всей главе 3, можно сказать, что в ней с помощью программных пакетов MATLAB и Mathcad были успешно подобранны оптимальные параметры для регуляторов приводов колес и механизма подъема шасси, обеспечивающие заданные по ТЗ характеристики переходных параметров, также была подтверждена устойчивость настроенных регуляторов методами Гурвица, Михайлова, Найквиста и Боде. Еще было экспериментальным методом установлено критическое время задержки на обработку обратной связи (0.5 с), которого нельзя допускать для того, чтобы время установления САУ приводов не выходило за установленные в ТЗ пределы.
