DmitriyKalashnikov1/VKR/Мат моделирование/Расчет и подбор электродвигаттеля backapp — копия.docx

# 2. Расчет и подбор электродвигателя

Для того, чтобы рассчитать мощность электродвигателей сначала нужно выбрать из всех режимов работы устройства самый нагруженный и самый не нагруженный. Самый не нагруженный (основной) режим работы показан на Рис.2.1.

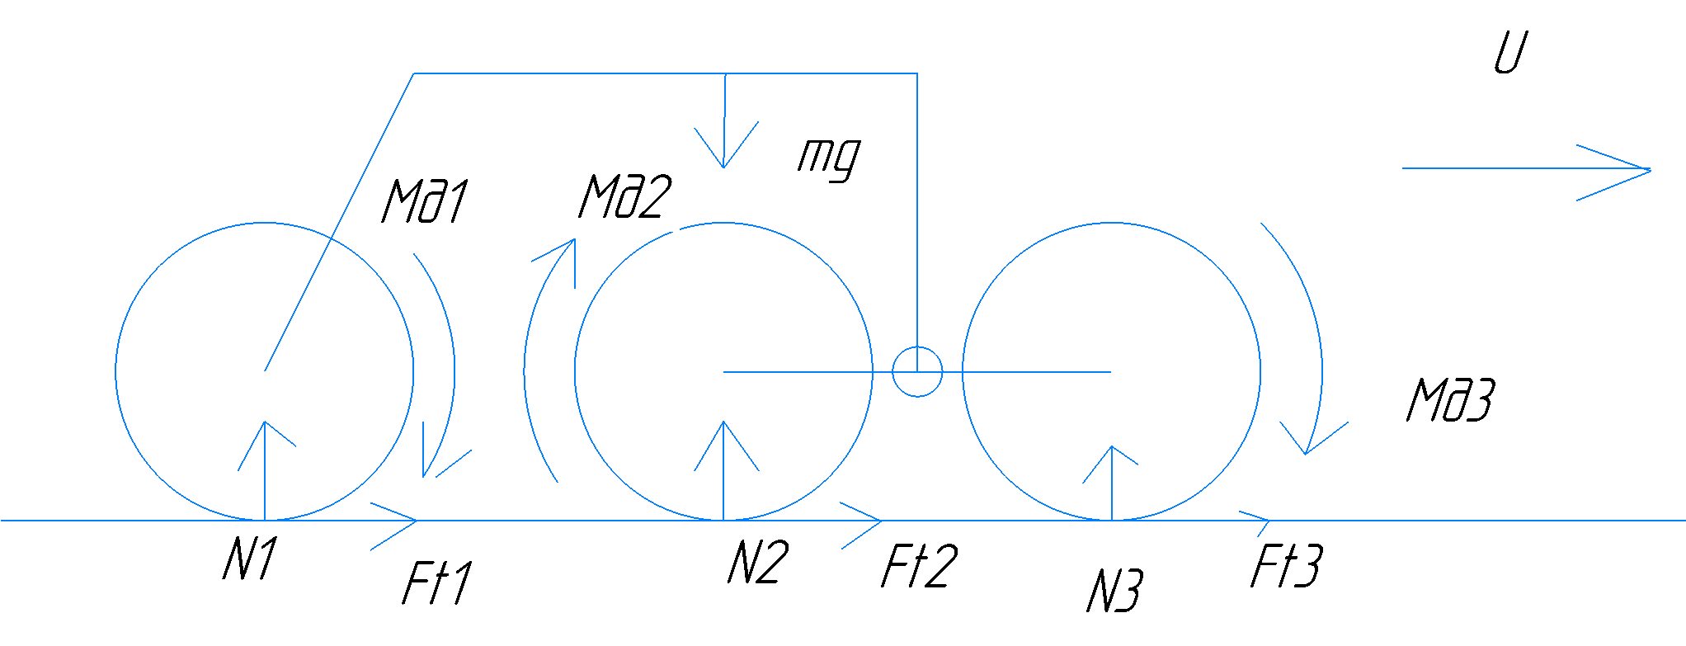
[picture p63: figure]

Рис.2.1. Основной режим работы устройства

Как видно, данная конструкция является статически неопределимой. Чтобы иметь возможность дальше проводить расчеты, примем допущение что вес конструкции во всех режимах равномерно распределяется по всем шести опорам, то есть:

N_i = 1/6mg;i=1⋯6;

Тогда, приняв массу всей конструкции как максимально возможную по ТЗ, найдем силу реакций опор:

N_i = 1/6mg=1/6(m_(ср) +m_п )*g=1/6*200*10=334 Н;i=1⋯6;

Эти данные нам нужны для расчета момента сопротивления в самом нагруженном режиме который должен преодолевать двигатель. Самый нагруженный режим работы (Режим езды по ступенькам высотой 250 мм) будет характеризоваться следующей схемой Рис.2.2.

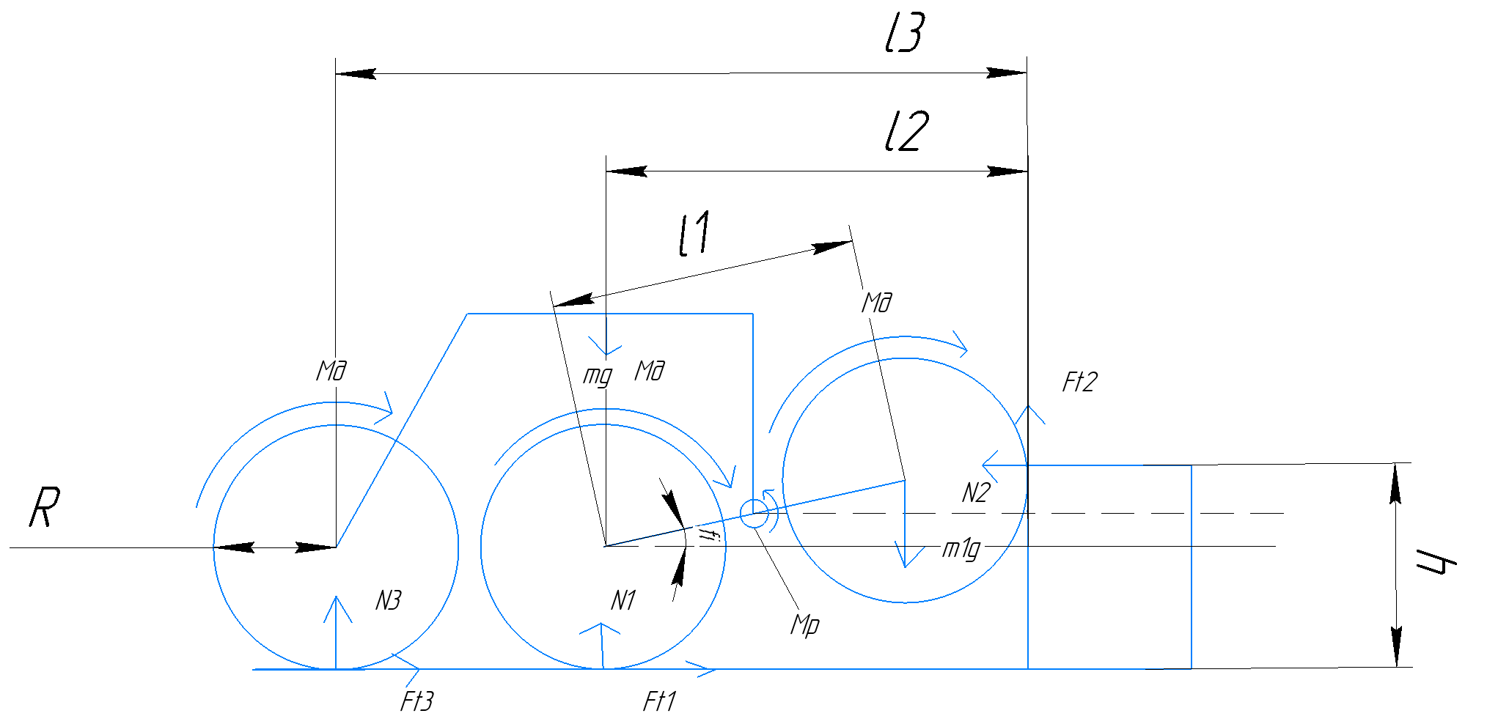
[picture p64: figure]

Рис.2.2. Динамическая схема езды по ступенькам

В этой схеме N1,N3, Ft1, Ft3 это силы реакции опоры и трения пола, N2, Ft2 – силы реакции опоры и трения в месте контакта колеса и ступеньки, Мд – моменты от двигателей колес (считаем их одинаковыми), l1=375 мм – длина балки между колесами, l3 – длина плеча силы N3, l2 – длина плеча сил N1 и mg (примем, что сила тяжести – распределенная сила, приложенная в центре линии приложения, и что как раз в этой же точке находится центр колеса 1, который не уходит с этого положения на время подъема), R=150 мм – радиус колеса, h = 250 мм – высота ступеньки, Mp – момент от двигателя установленного в механизм подъема переднего шасси, m1g – сила тяжести для одного поднятого колеса.

Запишем уравнения моментов и проекций сил относительно края ступеньки, приняв то что колеса едут без проскальзывания:

OX: kN3+kN1=N2

OY: kN2+N3+N1=mg

M_(кр.ст.) :kN3*h+N3*l3+k*N1*h+N1*l2-mg*l2+Mp=3Md

В приведенных выше формулах k – коэффициент сцепления. Данный коэффициент можно найти, подставив выражение для проекций сил на ОХ в формулу для OY ( N3=N_i =334 Н, N1=2*N3=668 Н ):

k^2 (N3+N1)+N3+N1=mg k= √((mg-N3-N1)/(N3+N1))=√((mg-3*N3)/(3*N3))=0.998

Найдем теперь выражения для l2, l3 (при этом l2 будет зависеть от угла подъема шасси fi ):

l2=(l1+R)*cos(fi); l3=1-R,

где 1 – 1 м, габаритный размер робота из ТЗ.

Запишем также выражение для момента Mp, записав уравнение моментов относительно центра балки l1:

Mp=m1g*(l1*cos(fi))/2+N1*(l1*cos(fi))/2+kN1*(R+((l1*cos(fi))/2)*sin⁡(fi))

В данной формуле последнее слагаемое – момент от силы трения.

Значение угла fi зададим равным 45° , потому что данный угол заведомо сможет обеспечить подъем робота на ступеньки. m1 возьмем с запасом 9.7 кг

Зная угол и подставив все остальные данные в формулу момента Mp получим:

Mp=9.7*9.8*(0.375*cos(45))/2+668*(0.375*cos(45))/2+0.998*668*(0.15+(0.375*cos(45))/2*sin(45))=263.7 Н*м

Теперь, зная нужную угловую скорость вращения ω=0.1(рад)/с , найдем расчетную мощность двигателя подъема шасси:

Np=Mp*w=26,37 Вт

Подставив коэффициент запаса 1.5 и примерное КПД передачи η=0.8 , найдем номинальную мощность, которую должен будет развивать двигатель:

Npreal=1.5*(Np)/η=49.438≈50 Вт

Теперь зная все переменные, входящие в формулу момента колесного двигателя найдем его:

Md=(kN3*h+N3*l3+k*N1*h+N1*l2-mg*l2+Mp)/3

Подставив все численные данные и посчитав получим:

Md=80.4 Н*м

Теперь, зная нужную угловую скорость вращения ω=0.1(рад)/с , найдем расчетную мощность двигателя колес:

Nd=Md*w=8.04 Вт

Подставив коэффициент запаса 3 и примерное КПД передачи η=0.8 , найдем номинальную мощность, которую должен будет развивать двигатель:

Ndreal=3*(Nd)/η=31.64≈32 Вт

По мощности для мотора подъемника шасси нам подходит такой мотор фирмы Maxson motors:

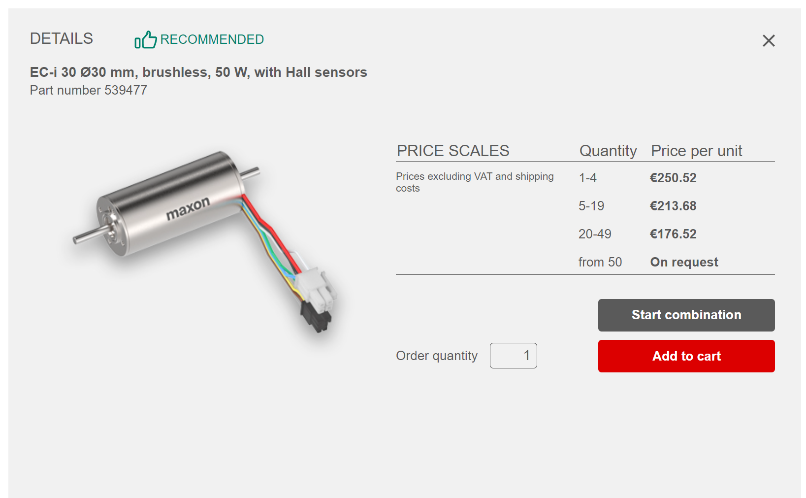
[picture p65: figure]

Рис.2.3. Мотор для подъема шасси

Табл.2.1. Параметры двигателя подъема шасси

Параметр (обозначение) | Значение
Сопротивление якоря ( R_я ) | 0.747 Ом
Индуктивность якоря ( L_я ) | 0.475* 10^(-3) Гн
Момент инерции двигателя (J) | 0.000138 Кг* м^2
Номинальное напряжение ( U_н ) | 24 В
Номинальная угловая скорость ( ω_н ) | 8830 rpm = 924.7 (рад)/с
Номинальный крутящий момент ( M_н ) | 54.7*10^(-3) Н*м
Номинальный ток ( I_н ) | 2.45 А
C_m | 0.0223 (Н*м)/А
C_e | 0.026 (В*с)/(рад)

Так как в данном каталоге есть только двигателя или 30 Вт или 40 Вт, мотор для колес выберем из двигателей с мощностью в 40 Вт. Выбранный мотор для колес показан на Рис. 2.4.

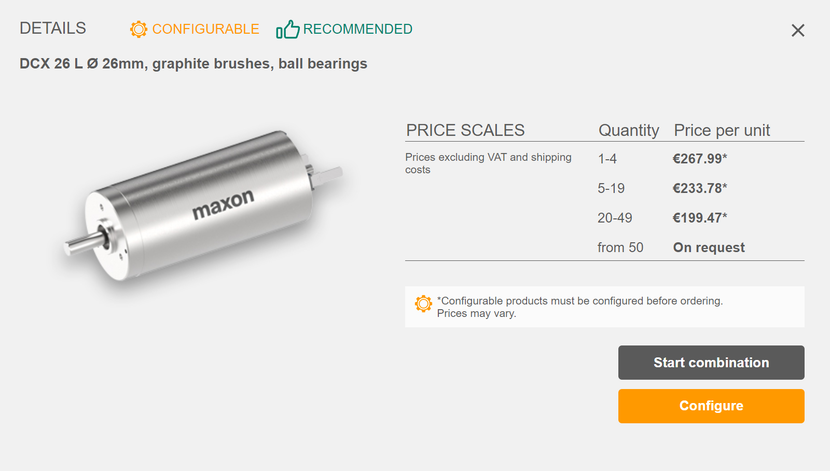
[picture p66: figure]

Рис.2.4. Мотор для колес

Табл.2.2. Параметры двигателя колес

Параметр (обозначение) | Значение
Сопротивление якоря ( R_я ) | 0.74 Ом
Индуктивность якоря ( L_я ) | 0.129* 10^(-3) Гн
Момент инерции двигателя (J) | 0.000214 Кг* м^2
Номинальное напряжение ( U_н ) | 24 В
Номинальная угловая скорость ( ω_н ) | 9690 rpm = 1015 (рад)/с
Номинальный крутящий момент ( M_н ) | 57.8*10^(-3) Н*м
Номинальный ток ( I_н ) | 2.76 А
C_m | 0.021 (Н*м)/А
C_e | 0.024 (В*с)/(рад)

Рассмотрим более подробно шаги (4) и (5), так как в них динамика робота сильно меняется. На рис.4.6 показана расчетная схема для шага (4).

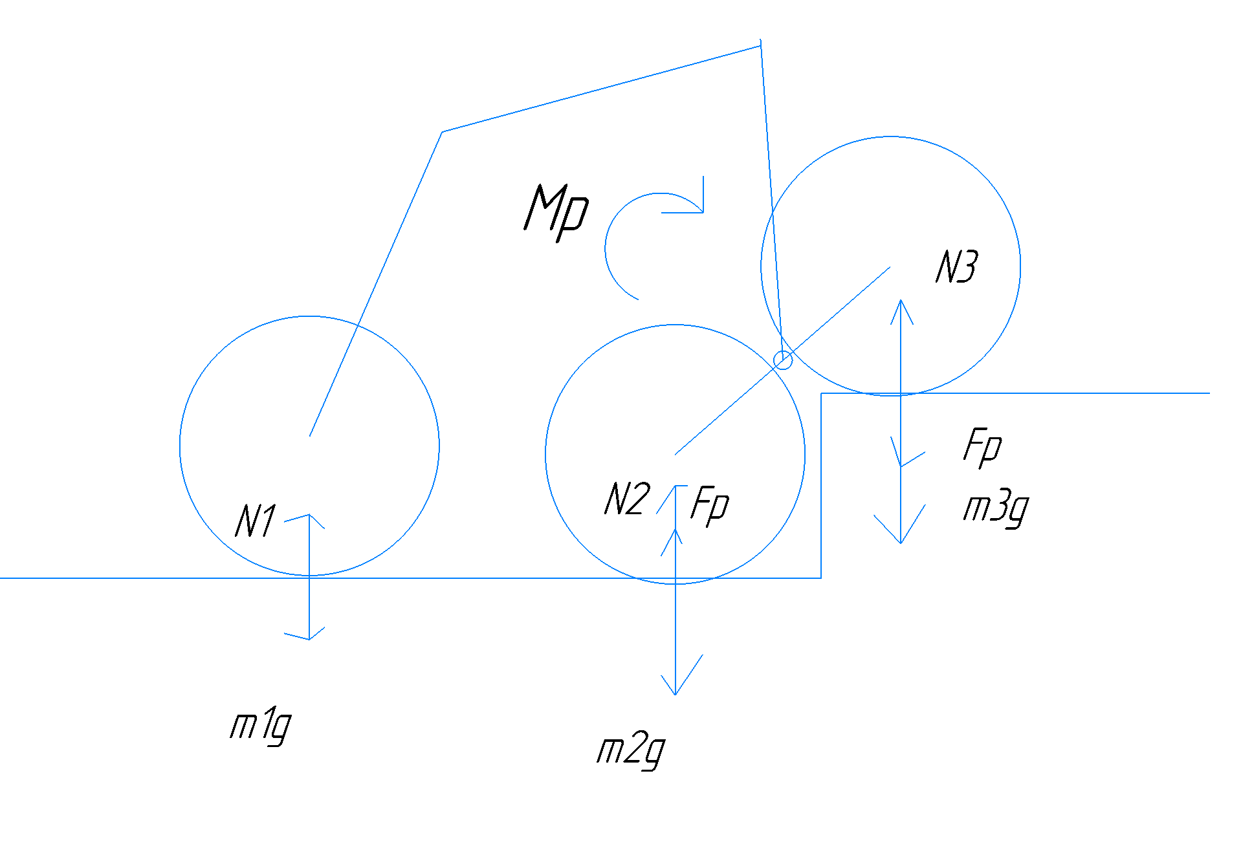
[picture p67: figure]

Рис.4.6. Расчетная схема шага (4)

Момент двигателя Mp превращается в пару сил Fp, одна из которых вдавливает переднее колесо в поверхность ступеньки, а вторая приподнимает

центральное колесо над полом, при этом перераспределяются силы тяжести, приходящиеся на каждое колесо, и все это зависит от одного угла поворота переднего шасси φ_7 . Для начала выведем формулу для Fp:

Fp=(Mp)/(0.5l_1)=0.5mg*sin(φ_7 ). (4.25)

Теперь запишем систему, выражающую процесс перенос опорных точек:

{, N3=m3g+FpN2=m2g-Fp, m1g=mg-m2g-m3g, N1=m1g
