DmitriyKalashnikov1/VKR/Презентации/Комплексная система управления движения инвалидной коляски.pptx

## Комплексная система управления движения инвалидной коляски

Автор: Калашников Д.А.
Научный руководитель: Мальчиков А.В.

## Актуальность

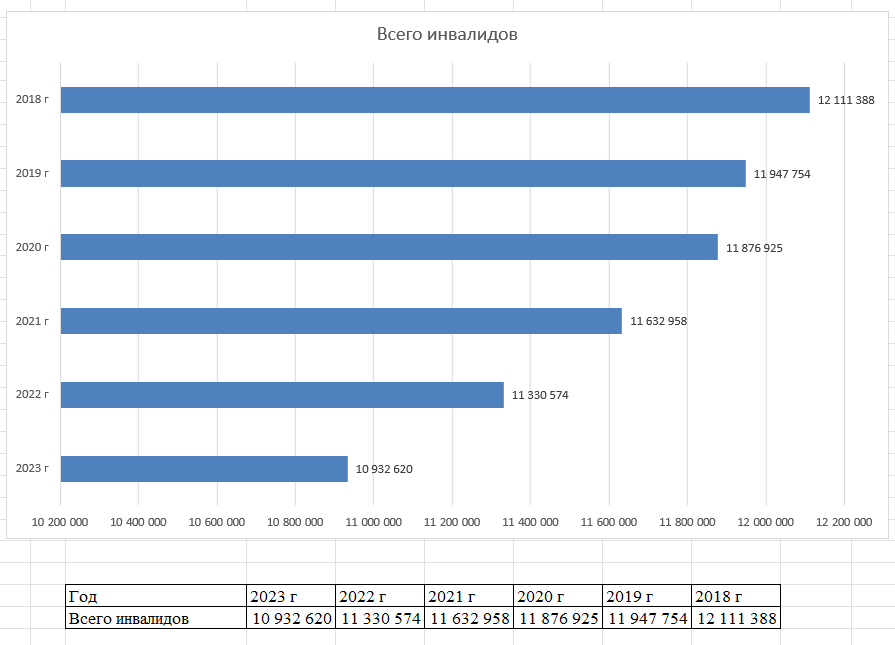
[picture p68: figure]

Статистика инвалидов в мире

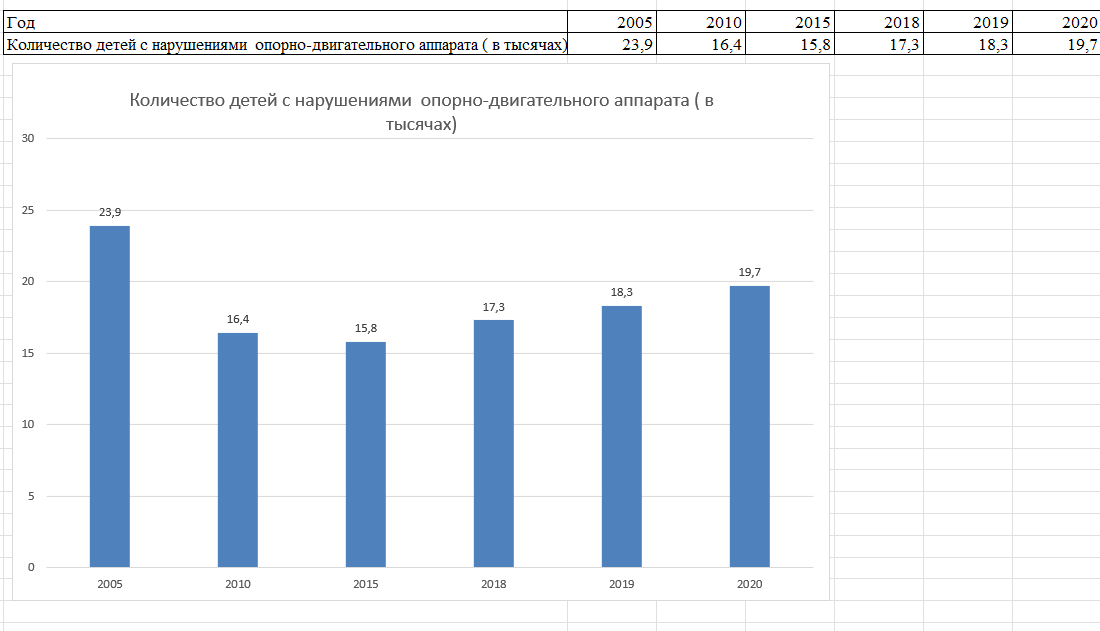
[picture p69: figure]

Количество детей с нарушением ОДА
только в России

## Типовые проблемы

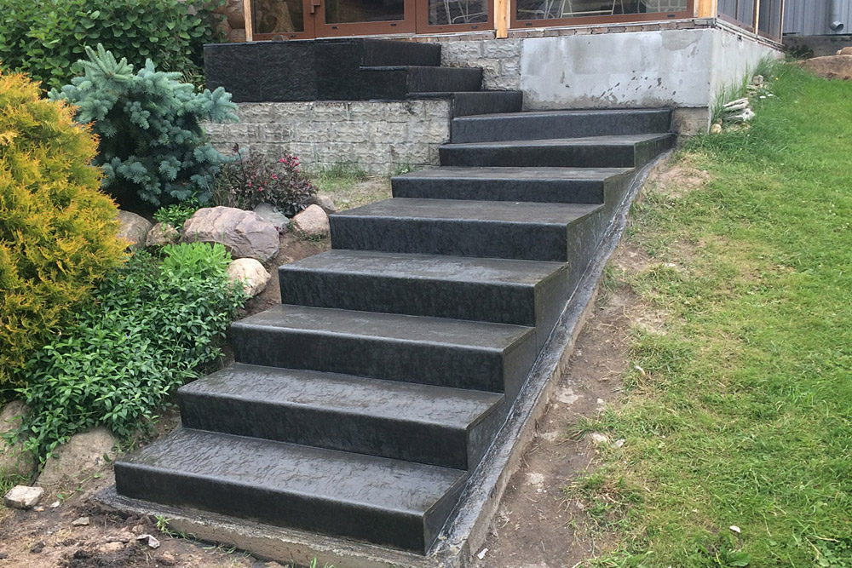
[picture p70: figure]
Самые длинные лестницы мира фото

Отсутствие объезда

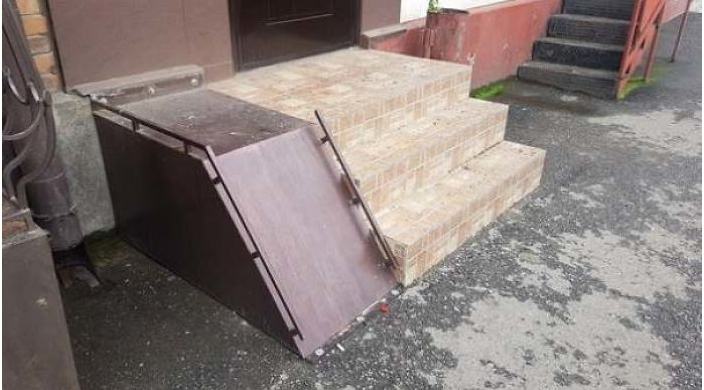
[picture p71: figure]
20 примеров ужасных пандусов для людей с колясками - Лайфхакер

Крутой пандус

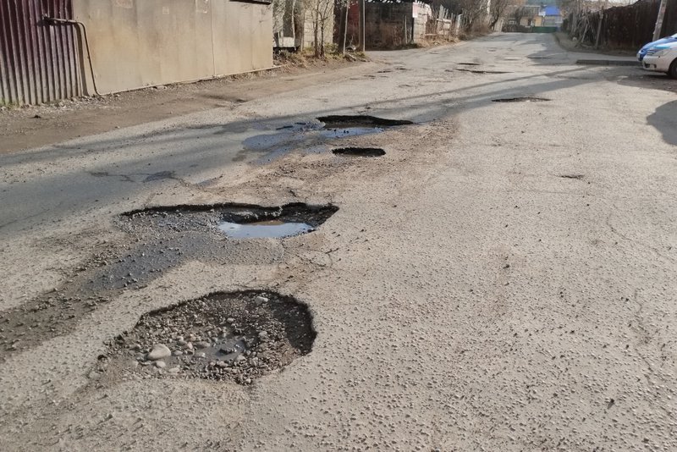
[picture p72: figure]
Иркутяне пожаловались на ямы и разбитый асфальт на улице Белобородова | Новости Иркутска: экономика, спорт, медицина, культура, происшествия

Разбитые дороги

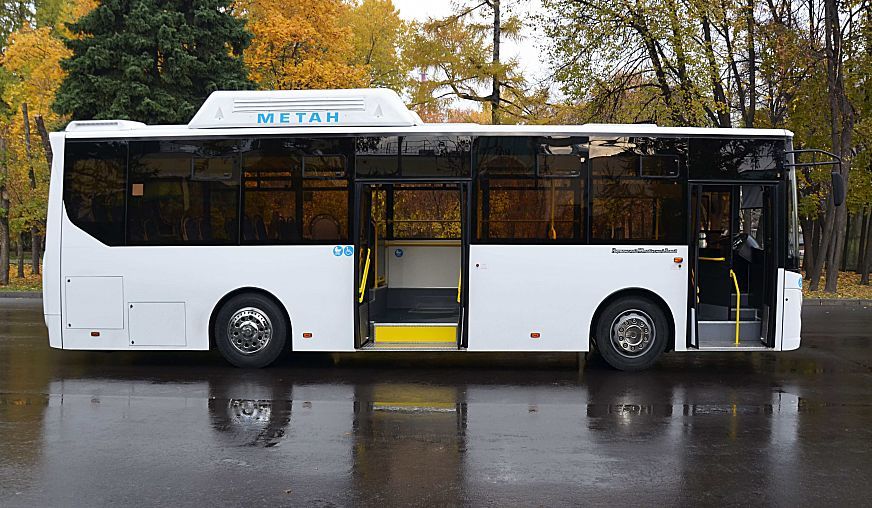
[picture p73: figure]
Автобус КАВЗ 4270-80 низкопольный 28/90 ЯМЗ CNG, цена в Набережных Челнах от компании Специальные машины

Высокие ступеньки в транспорт без
выдвижного пандуса

## Классификация устройств для преодоления препятствий

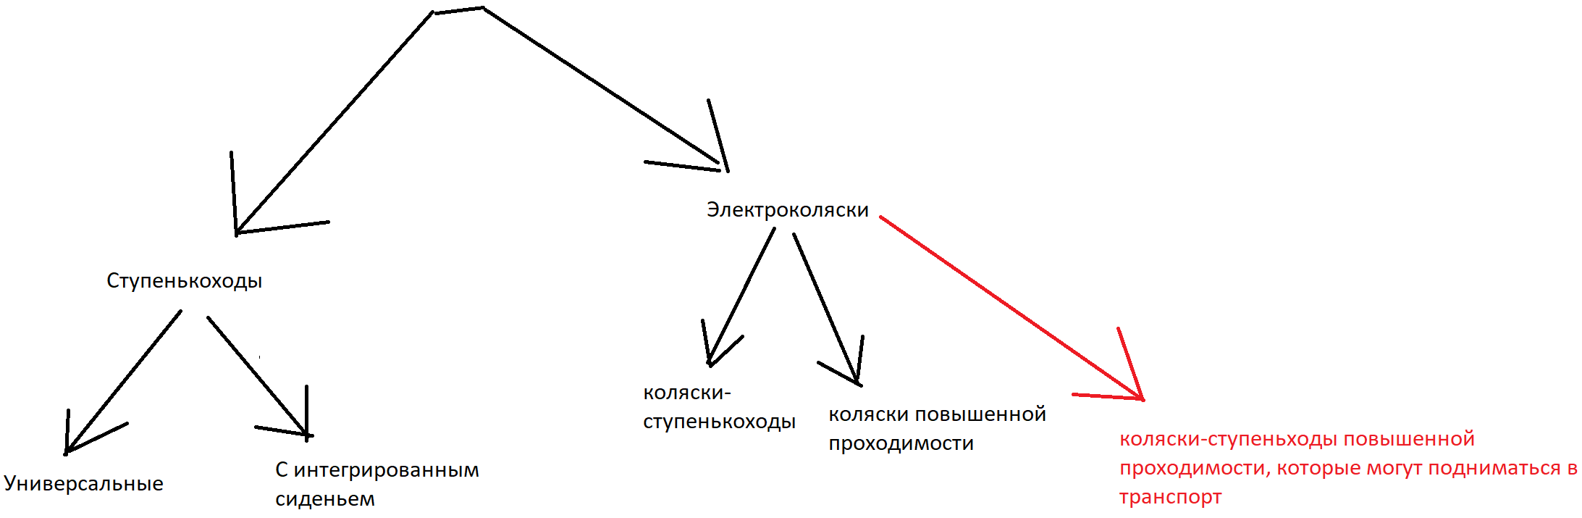
[picture p74: figure]

## Существующие решения

Страна-производитель: Россия;
Компания: Catewil;
Тип: коляска повышенной проходимости;
База: колесная, полноприводная;
Мощность моторов: 450Вт;
Стабилизация сиденья: за счет механических демпферов;
Электрорегулировки сиденья:
опционально;
Джойстик: английский;
Максимальная преодолеваемая высота ступеньки/бордюра: 10 см

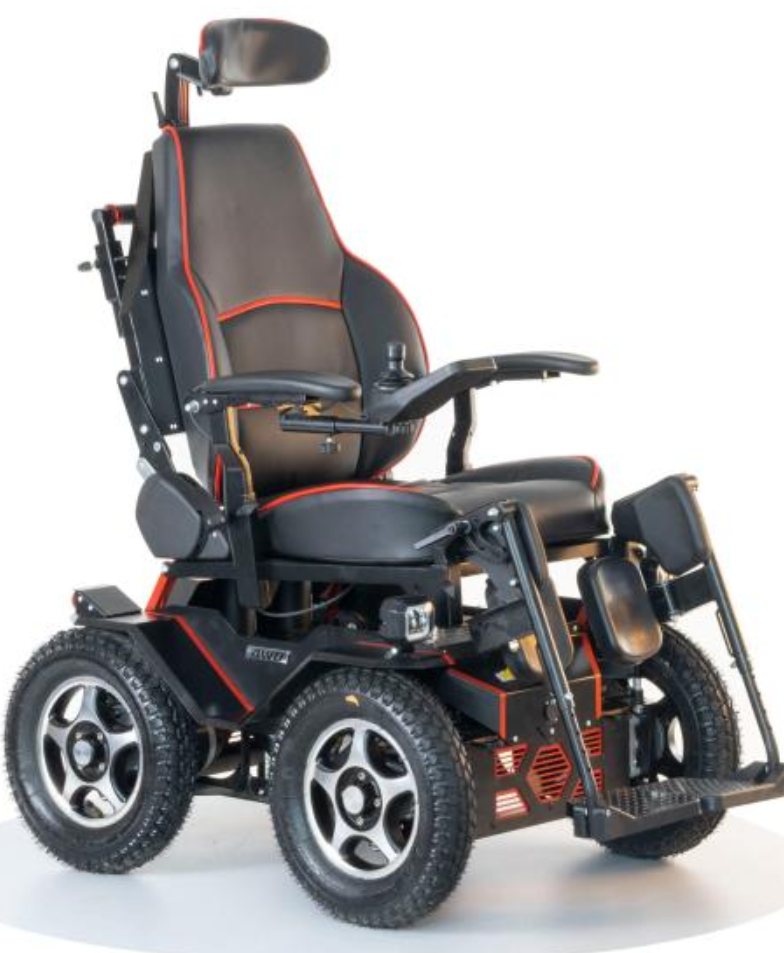
[picture p75: figure]

Catewil Utltra 4WD

Страна-производитель: Россия;
Компания: Observer;
Тип: коляска повышенной проходимости;
База: колесная, полноприводная;
Мощность моторов: 1300Вт;
Стабилизация сиденья: за счет обработки данных с гироскопа;
Электрорегулировки сиденья:
опционально;
Джойстик: английский;
Максимальная преодолеваемая высота ступеньки/бордюра: 15 см

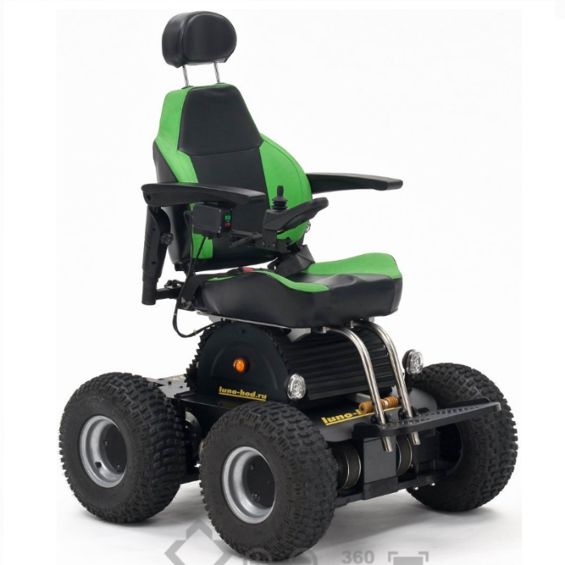
[picture p76: figure]
Кресло-коляска с электроприводом Observer Проходимец OB-EW-002

Observer Проходимец

## Существующие решения

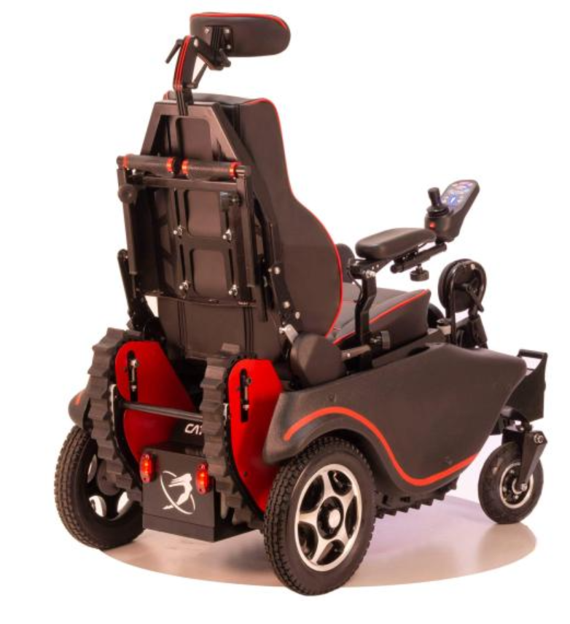
[picture p77: figure]

Catewil GTS4

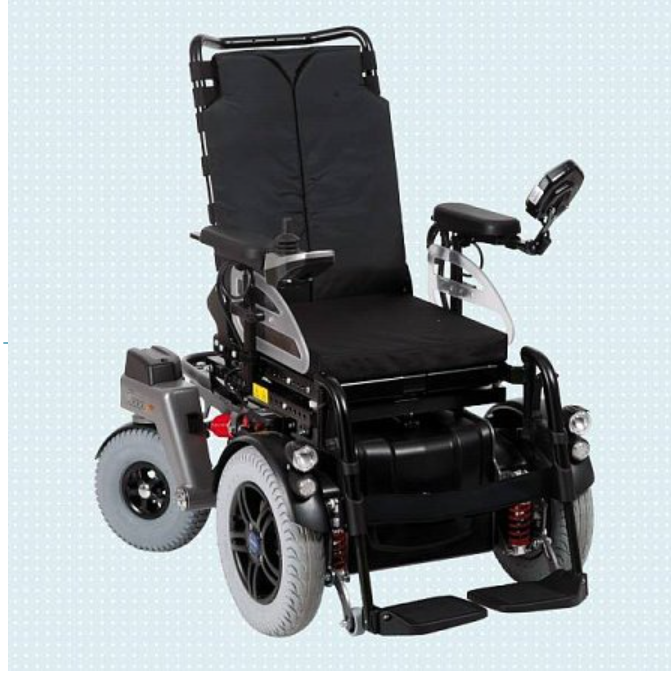
[picture p78: figure]

Otto bork C1000 DS

Страна-производитель: Россия;
Компания: Catewil;
Тип: коляска-ступенькоход;
База: смешенная (привод на задние колеса + выдвижное гусеничное шасси);
Мощность моторов: 450Вт;
Стабилизация сиденья: за счет механических демпферов;
Электрорегулировки сиденья:
есть;
Джойстик: английский;
Максимальная преодолеваемая высота ступеньки/бордюра: 20 см

Страна-производитель: Германия;
Компания: Otto bork;
Тип: коляска повышенной проходимости;
База: колесная, полноприводная;
Мощность моторов: 450Вт;
Стабилизация сиденья: за счет механических демпферов;
Электрорегулировки сиденья:
продвинутая система;
Джойстик: немецкий, разработан в самой компании Otto bork;
Максимальная преодолеваемая высота ступеньки/бордюра: 7-8 см

## Существующие решения

Страна-производитель: Германия;
Компания: Otto bork;
Тип: коляска повышенной проходимости;
База: колесная, полноприводная;
Мощность моторов: 550Вт;
Стабилизация сиденья: за счет механических демпферов;
Электрорегулировки сиденья:
продвинутая система;
Джойстик: немецкий, разработан в самой компании Otto bork;
Максимальная преодолеваемая высота ступеньки/бордюра: 7-8 см

Страна-производитель: Китай;
Компания: Ortonika;
Тип: коляска повышенной проходимости;
База: колесная, заднеприводная;
Мощность моторов: 450Вт;
Стабилизация сиденья: за счет механических демпферов;
Электрорегулировки сиденья:
нет;
Джойстик: английский;
Максимальная преодолеваемая высота ступеньки/бордюра: 10 см

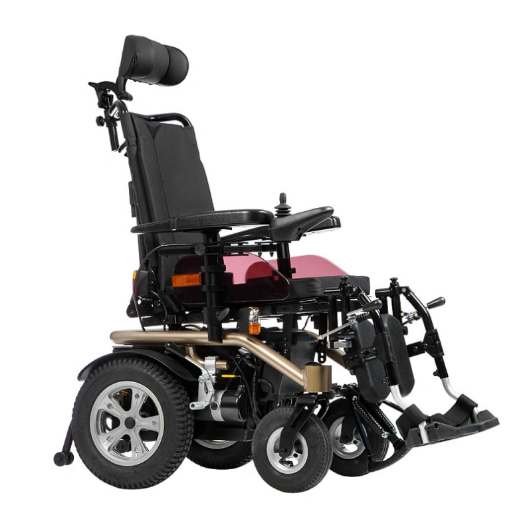
[picture p79: figure]

Pulse 270

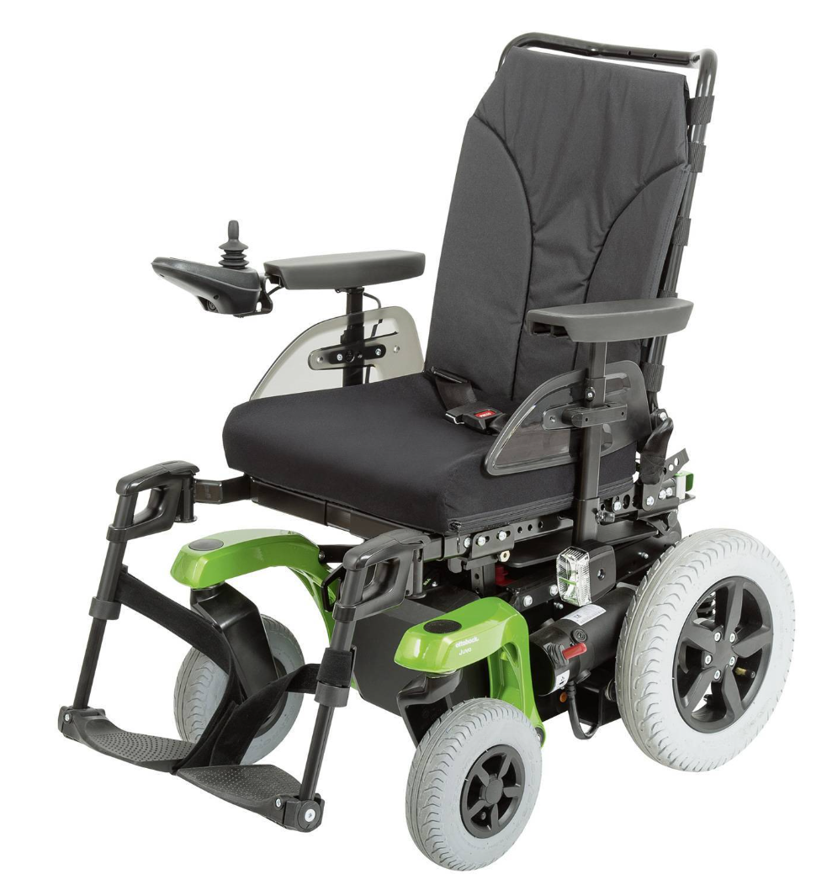
[picture p80: figure]

Ottobock juvo b5

## Существующие решения

Параметр/Название | Ultra 4WD | Проходимец | GTS4 | С1000 DS | Juvo B5 | Pulse 270
Страна-производитель | Россия | Россия | Россия | Германия | Германия | Китай
Компания | Catewil | Observer | Catewil | Ottobork | Ottobork | Ortonica
Тип | Коляска повышенной проходимости | Коляска повышенной проходимости | Ступенькоход | Коляска повышенной проходимости | Коляска повышенной проходимости | Коляска повышенной проходимости
База | Колесная | Колесная | Смешенная | Колесная | Колесная | Колесная
Мощность моторов | 450 Вт | 1300 Вт | 450 Вт | 450 Вт | 550 Вт | 450 Вт
Наличие электрорегулировок сиденья | Опционально | Опционально | Есть | Есть | Есть | Нет
Джойстик | Английский | Английский | Английский | Германский | Германский | Английский
Максимальная преодолеваемая высота ступеньки | 10 см | 15 см | 20 см | 7-8 см | 7-8 см | 10 см

## Обоснование проекта

- Проанализировав все представленные решения, можно сделать выводы:
1. Электроколясок, которые могли бы заезжать в общественный транспорт не существует;
2. Потребность в колясках, заезжающих в транспорт, есть очень большая, из-за маленького для городских условий запаса хода на одном заряде у всех существующих решений;
3. Не существует универсальных колясок, способных как преодолевать ступеньки и бордюры больше 10 см в высоту, так и справляться с плохими дорожными условиями;
4. Не существует российского джойстика, обеспечивающего сопоставимую с зарубежными аналогами плавность управления коляской

## Идея проекта

- Электроколяска которая позволит инвалиду свободно преодолевать лестницы, пандусы и бордюры, а также без проблем пользоваться общественным транспортом.
- Данная коляска будет иметь 3 режима работы:
1. Режим ручного управления (с помощью многопозиционного джойстика)
2. Режим автономного следования за маячком в кармане пользователя.
3. Режим полностью автономной доставки пассажира в заранее заданную точку

## Цели и задачи проекта

- Целью данного проекта является создание универсального транспортного средства для людей с ОВЗ, которое обеспечило бы им возможность самостоятельного передвижения по городу, позволив им спокойно преодолевать на нем препятствия такие как лестницы, бордюры и пандусы, а также без затруднений пользоваться общественным транспортом. Данное устройство в экстренных ситуациях сможет брать управление на себя и автономно доставлять своего пассажира в нужное место, что повысит безопасность передвижения этих людей.
- Задачами данного проекта является:
- 1. Провести анализ существующих решений транспортных средств для людей с ОВЗ, составить техническое задание на разработку данного устройства;
- 2. Составить математическую модель, описывающую передвижение и функционирование разрабатываемого устройства;
- 3. Разработать конструкцию, удовлетворяющую требованиям ТЗ
- 4. Создать на основе мат. модели устройства цифровую систему управления, которая позволит данному транспортному средству правильно выполнять свои функции, описанные в Целях данного проекта.
