DmitriyKalashnikov1/VKR/Обзор/КУМС Блок управления Перечень элементов _ КР-175303-24-КДА-10.00.00 ЭЗ.pdf

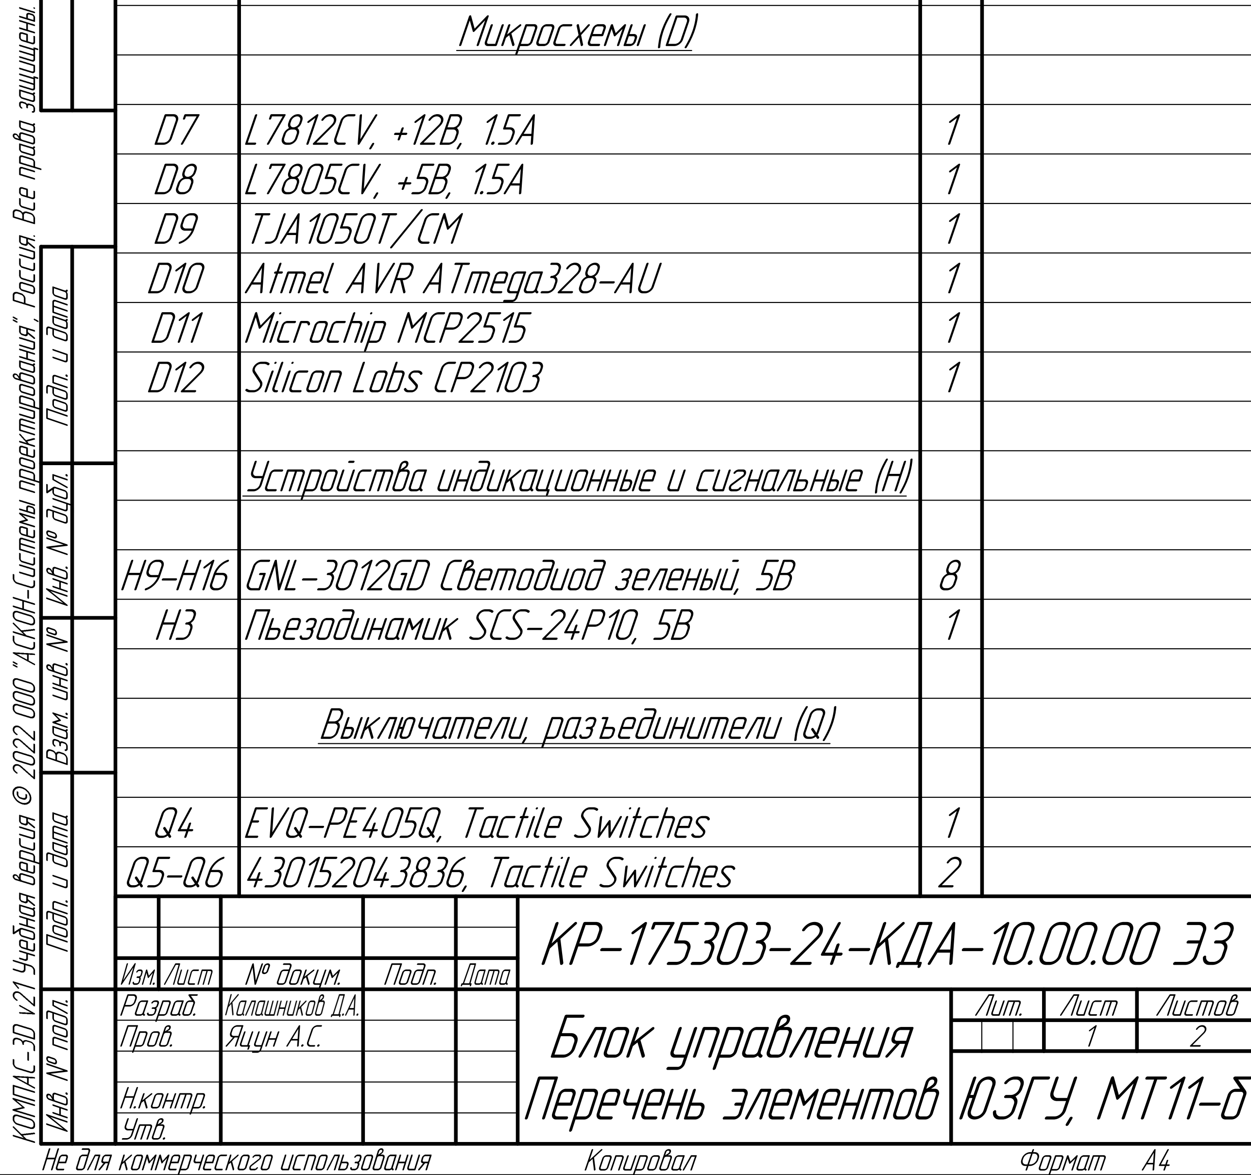
[picture p81: figure]
Разраб.; Калашников Д.А.; Блок управления Перечень элементов; Лит.; Лист; Листов; Пров.; Яцун А.С.; Н.контр.; Микросхемы (D); TJA1050T/CM; Atmel AVR ATmega328-AU; Microchip MCP2515; Silicon Lobs CP2103; Устройства индикационные и сигнальные (H); H9-H16 GNL-3012GD Светодиод зеленый, 5В; Пьезодинамик SCS-24P10, 5В; Выключатели, разъединители (Q); EVQ-PE405Q, Tactile Switches; Q5-Q6 430152043836, Tactile Switches; Копировал; Формат A4

| | № докум. | Подп. | Дата | КР-175303-24-КДА-10.00.00 ЭЗ Изм. Лист
Утв. | ЮЗГУ, МТ11-б Инв. № подл. Подп. и дата Взам. инв. № Инв. № дубл. Подп. и дата Справ. № Перв. примен. | Конденсаторы (C)
С14, С15, С16 Электролитический, K50-35 мини 100 мкФ 25В | | 3
С17, С18 Керамический, K50-35 мини 100 мкФ 10В | | 2
С19, С20 Керамический, К10-17Б X7R, 0.1 мкФ 50 В | | 2
C21, C22 Керамический, К10-17Б NPO, 22пФ 50 В | | 2
С23, С24 Керамический, К10-17Б NPO, 22пФ 50 В | | 2
С25 | Керамический, К10-17А Н90, 1 мкФ 40В | 1
С26 | Элетролитический, К50-29, 4.7 мкФ 100 В | 1

Поз.
обозначение
Наименование | Кол. Примечание

## КР-175303-24-КДА-10.00.00 ЭЗ Лист

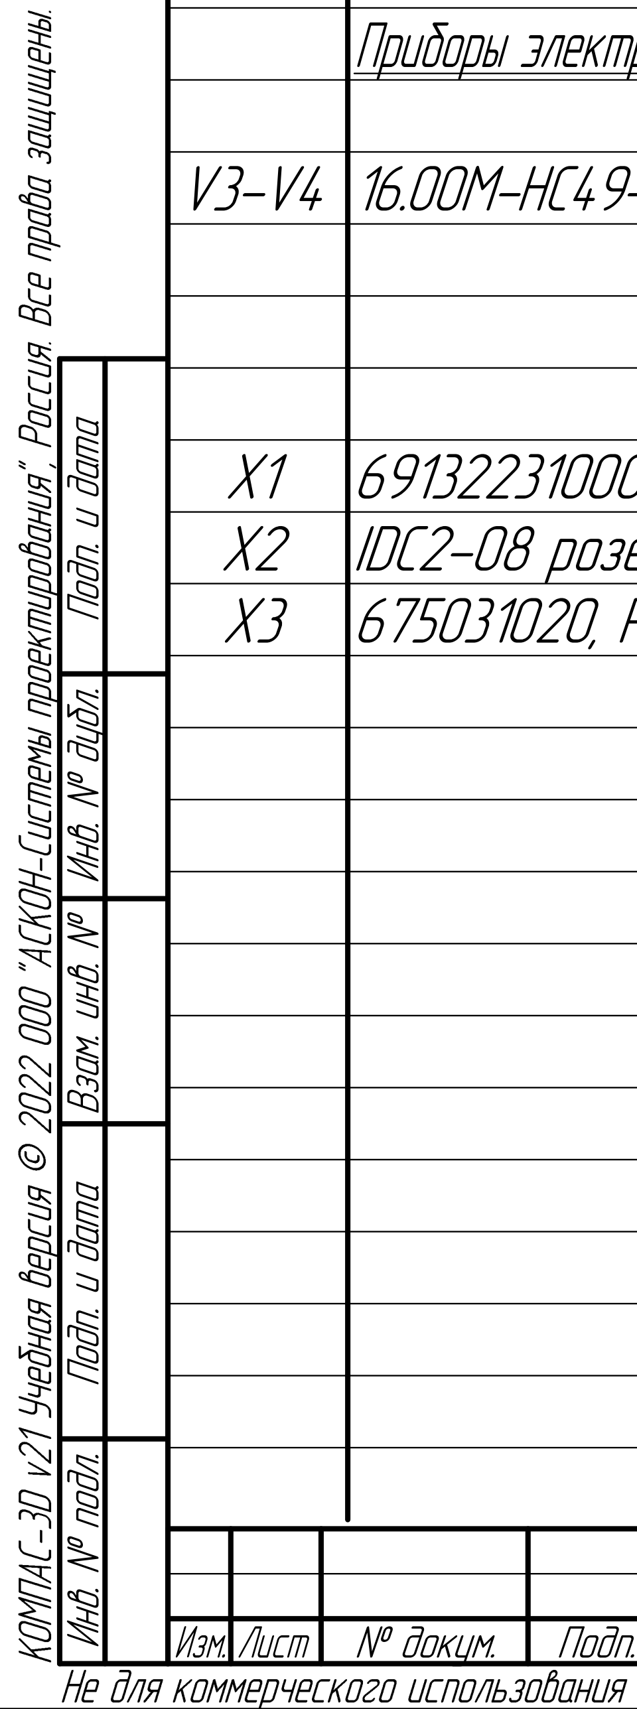
[picture p82: figure]

2 Инв. № подл. Подп. и дата Взам. инв. № Инв. № дубл. Подп. и дата | Изм. Лист | № докум. | Подп. | Дата

Резисторы (R)

R15, R16 PTF565K0000BZEK, 0,125 Вт, 5 кОм | | 2
R17 | CF-25 (С1-4) 0.25 Вт, 120 Ом | 1
R18-R24 CF-100 (С1-4) 1 Вт, 220 Ом | | 6
R19 | CF-100 (С1-4) 1 Вт, 10 кОм | 1
R25 | CF-25 (С1-4) 0.25 Вт, 2.4 кОм | 1
R26 | UPF50B500RV 0.5 Вт, 500 Ом | 1
R27-R28 CF-100 (С1-4) 1 Вт, 220 Ом | | 2

Приборы электровакуумные и полупроводниковые (V)

V3-V4 16.00M-HC49-S, Резонатор кварцевый, 16МГц 2

Контакты (X)

X1 | 691322310006, Pluggable Terminal Blocks | 1
X2 | IDC2-08 розетка, шаг P2.0x2.0 | 1
X3 | 675031020, Разъем Mini USB тип B, USB 2.0 | 1

Поз.
обозначение
Наименование | Кол. Примечание
Копировал | Формат A4
