DmitriyKalashnikov1/VKR/3d/1730195452518.jpg

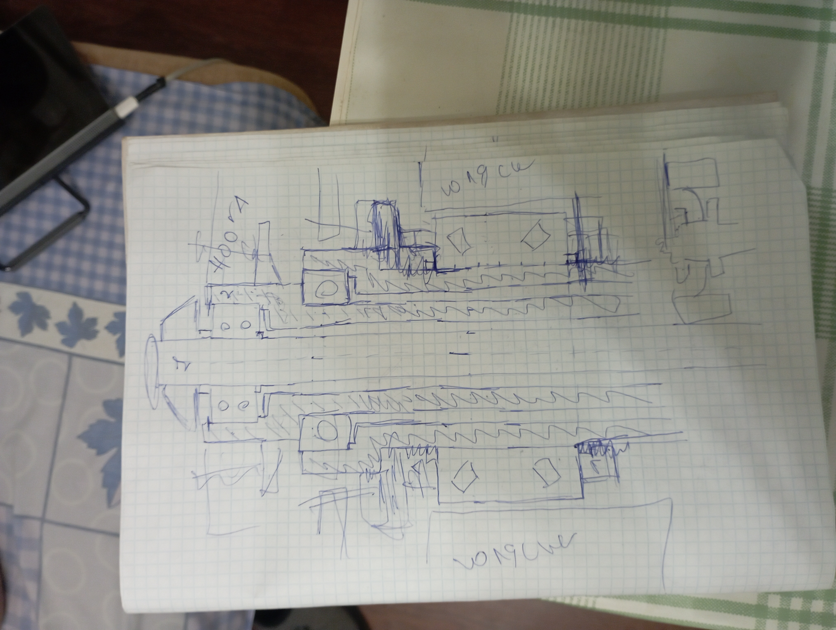
3d/1730195452518.jpg
