DmitriyKalashnikov1/VKR/3d/Sopromat/ice_screenshot_20250330-114316.png

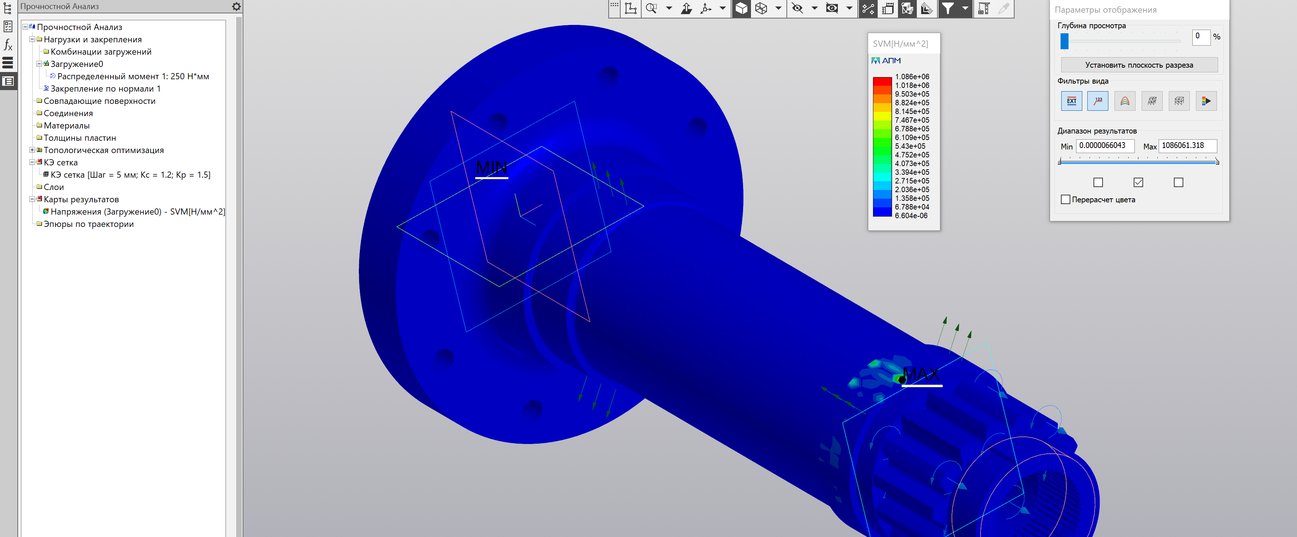
3d/Sopromat/ice_screenshot_20250330-114316.png
