DmitriyKalashnikov1/VKR/AK80-64-MS-7.webp

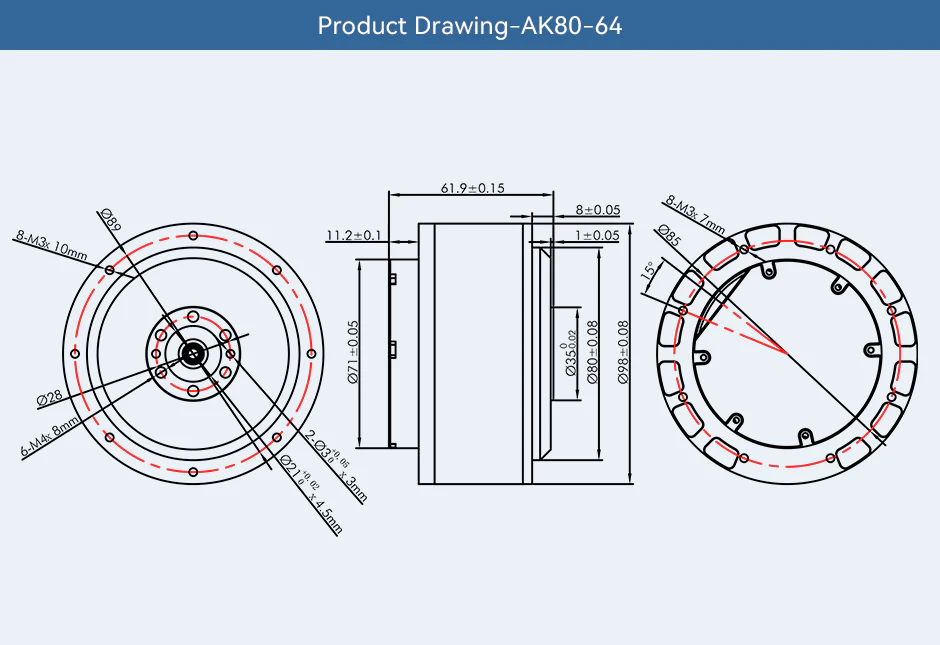
AK80-64-MS-7.webp
