DmitriyKalashnikov1/VKR/Мат моделирование/BurdurControl.png

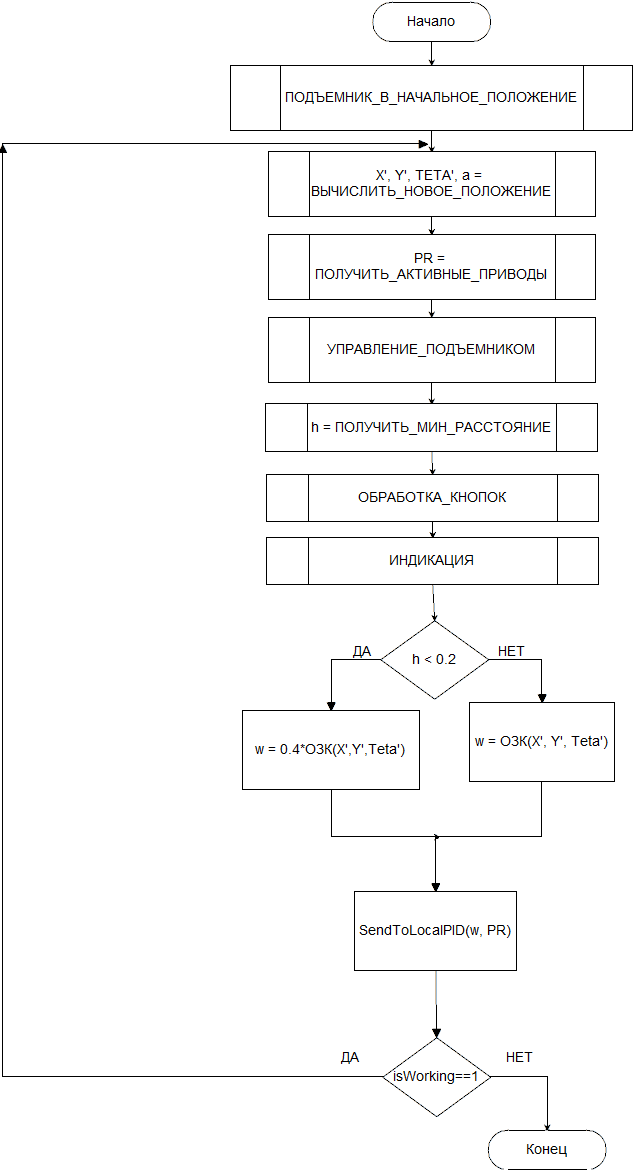
Мат моделирование/BurdurControl.png
