DmitriyKalashnikov1/VKR/Мат моделирование/buttonUpDownAlgoritm.png

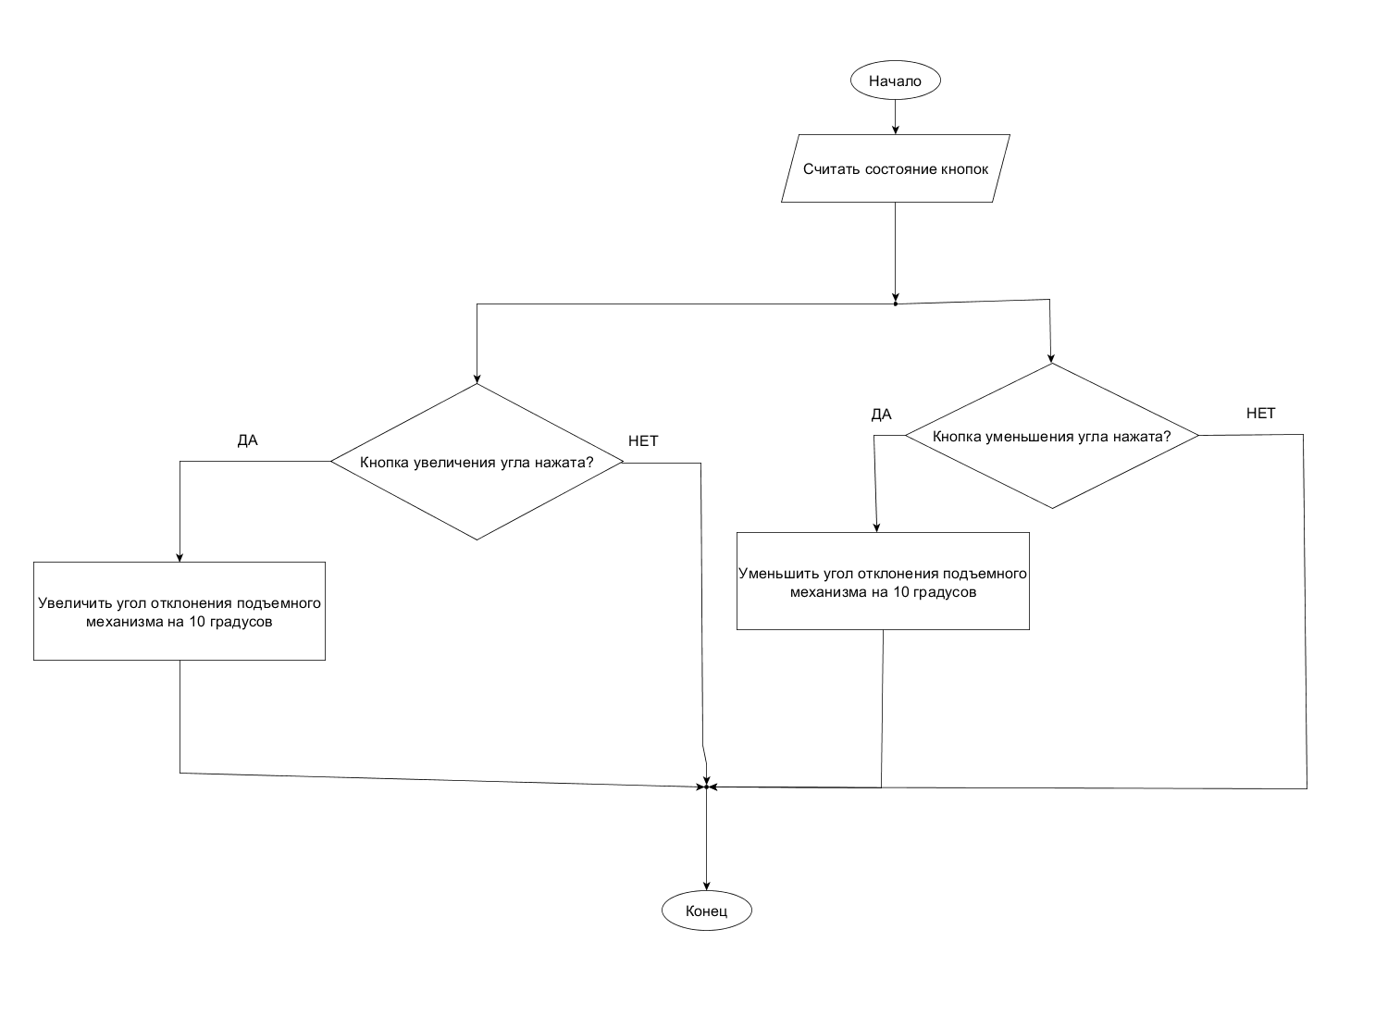
Мат моделирование/buttonUpDownAlgoritm.png
