DmitriyKalashnikov1/VKR/Мат моделирование/KUMS_main_Algoritm.png

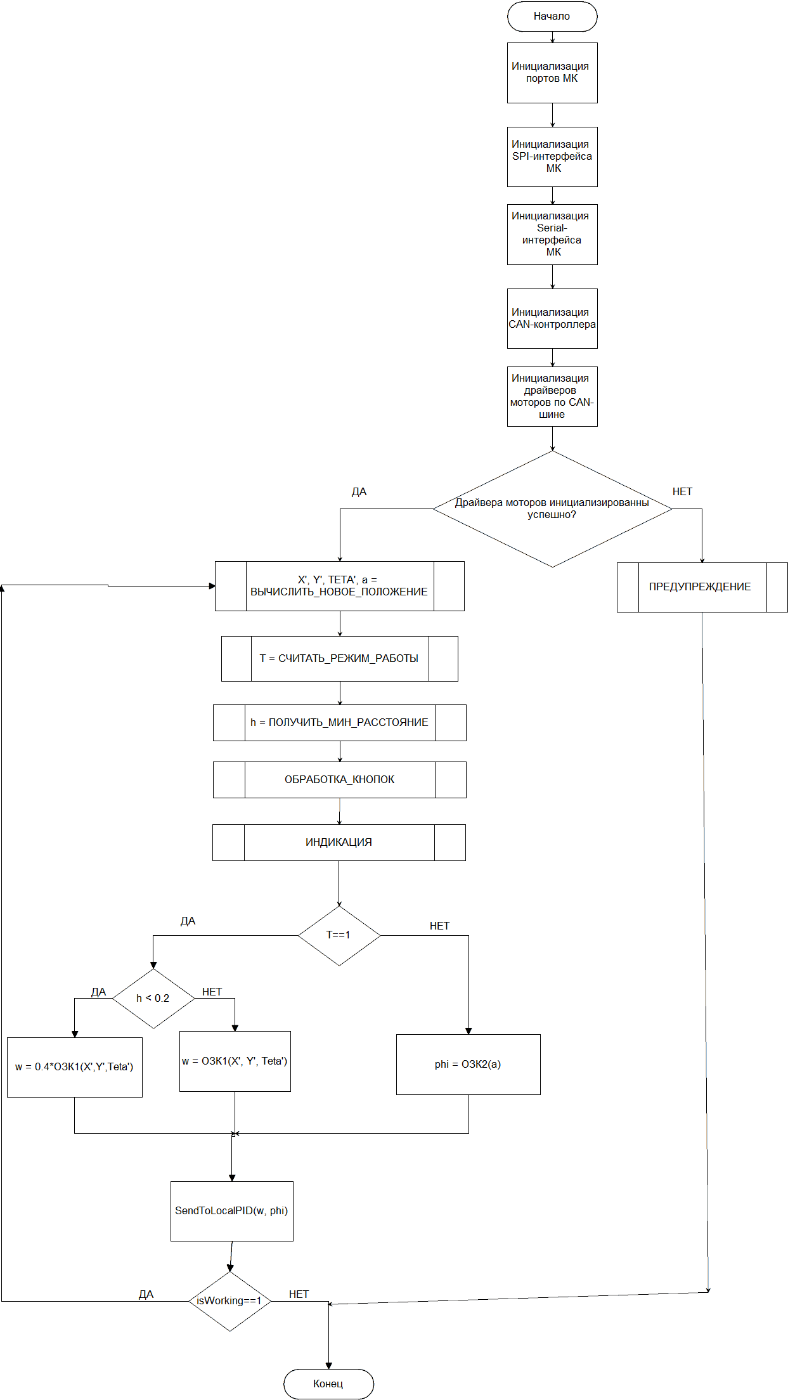
Мат моделирование/KUMS_main_Algoritm.png
