DmitriyKalashnikov1/VKR/Мат моделирование/MainAlgoritm.png

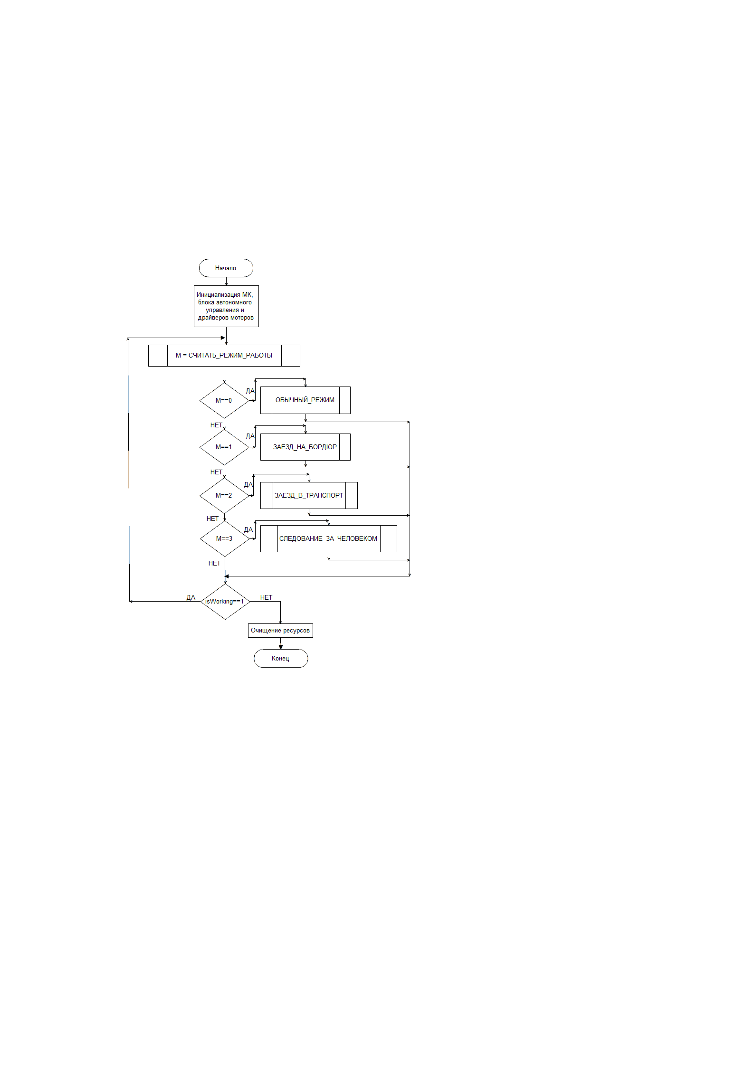
Мат моделирование/MainAlgoritm.png
