DmitriyKalashnikov1/VKR/Мат моделирование/TrasportControl.png

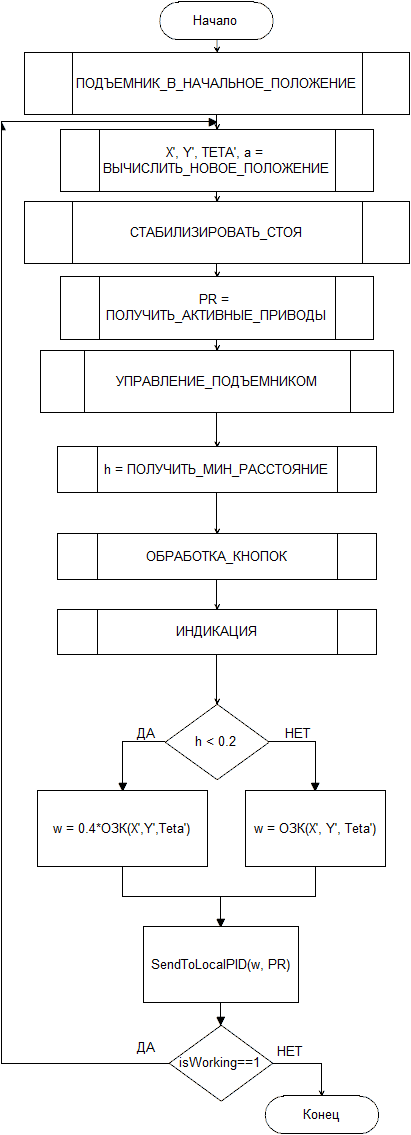
Мат моделирование/TrasportControl.png
