DmitriyKalashnikov1/VKR/Мат моделирование/ПодпрограммаРучноеУправление.png

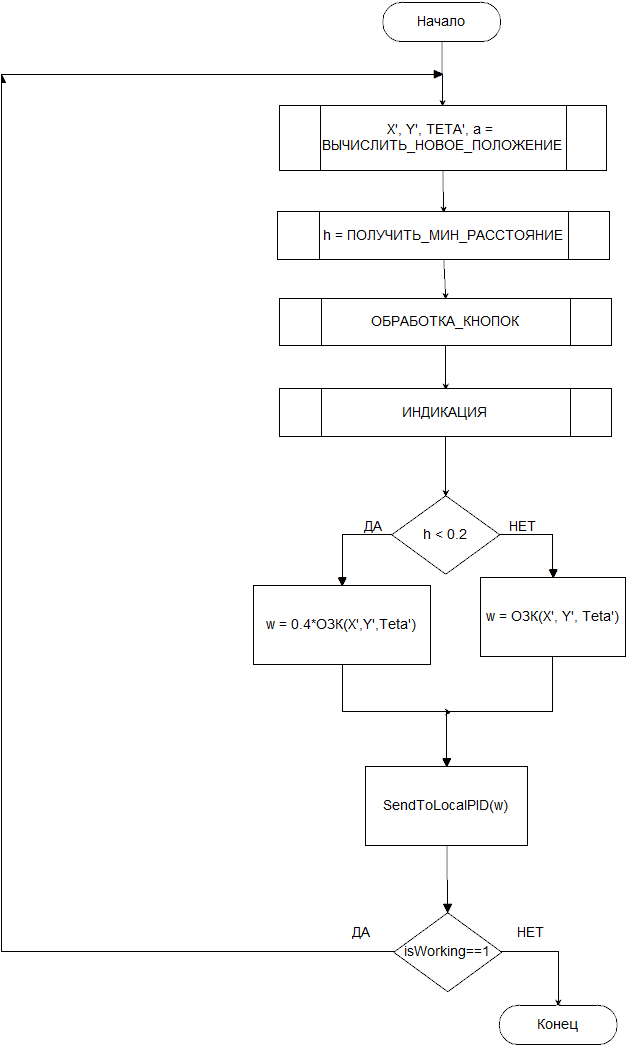
Мат моделирование/ПодпрограммаРучноеУправление.png
