DmitriyKalashnikov1/VKR/3d/Сидение/Спинка в сборе (без кронштейна).SLDASM

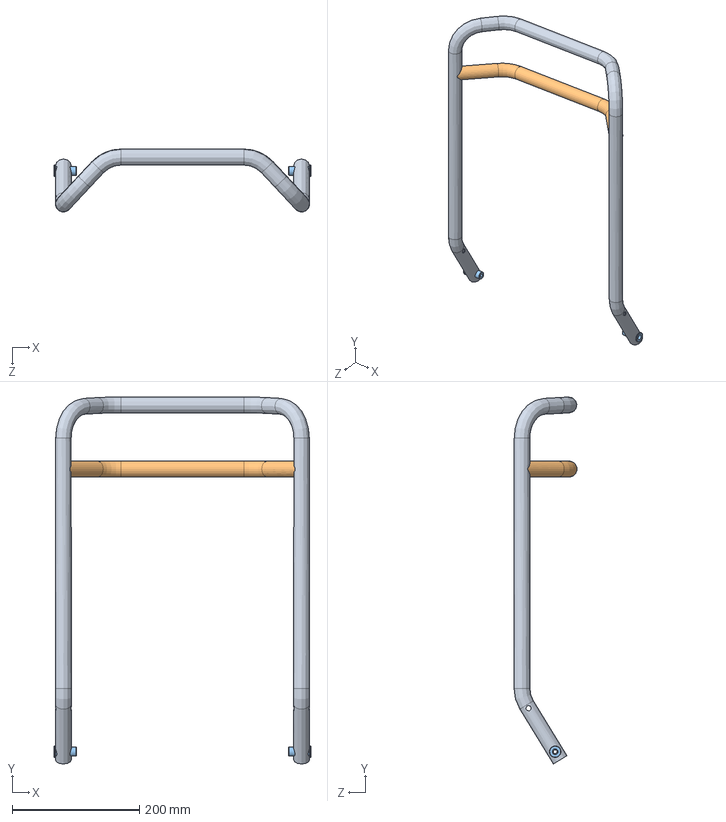
[picture p93: CAD file, 2025-03-10]
3d/Сидение/Спинка в сборе (без кронштейна).SLDASM
402.9 x 576.2 x 98.9 mm
Труба спинки-1
Труба спинки-2
Втулка спинки-1 x 2
