DmitriyKalashnikov1/VKR/Programs/IsaakSim/PrimeChair.SLDASM

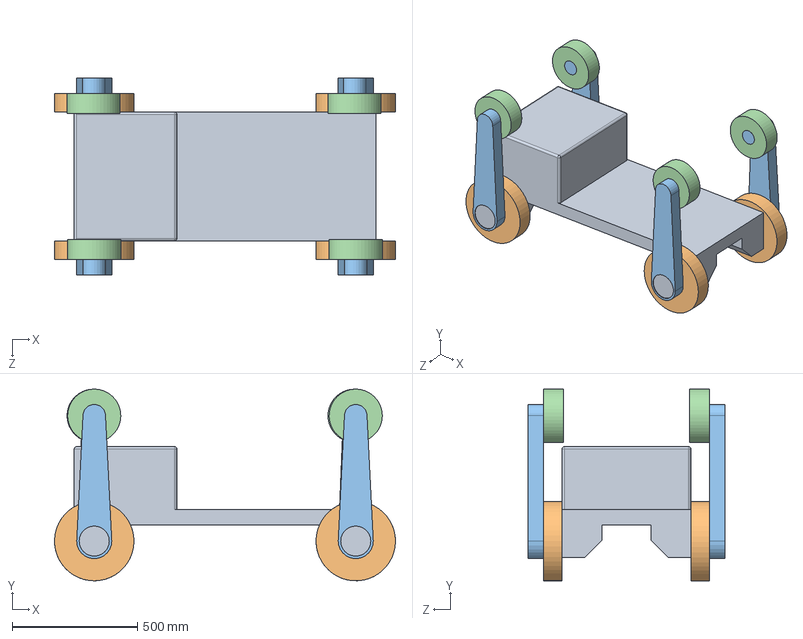
[picture p94: CAD file, 2025-06-17]
Programs/IsaakSim/PrimeChair.SLDASM
1360.0 x 764.4 x 784.0 mm
base
BigWheel x 4
Noga x 4
SmallWheel x 4
