DmitriyKalashnikov1/VKR/3d/IntelRealsense_D435_Multibody.SLDPRT

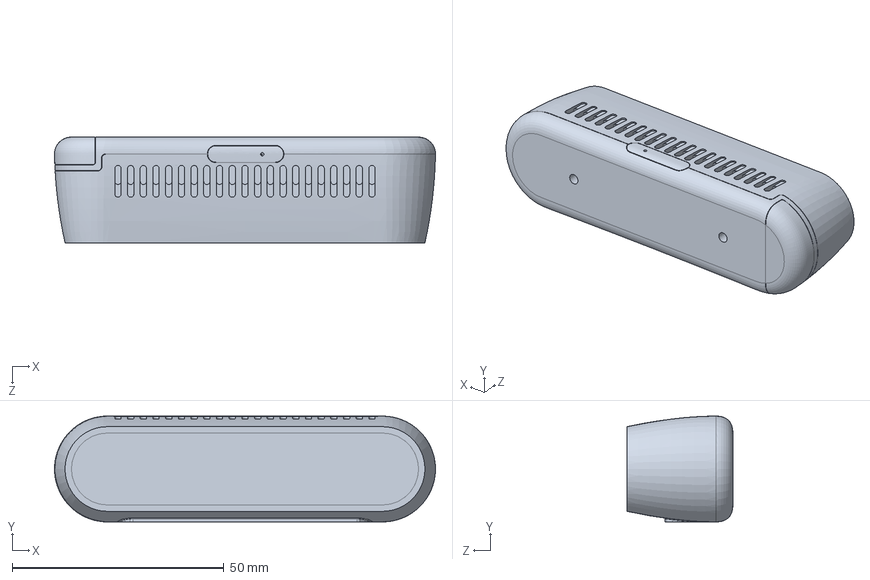
[picture p96: CAD file, 2025-03-13]
3d/IntelRealsense_D435_Multibody.SLDPRT
90.0 x 25.0 x 25.0 mm
