DmitriyKalashnikov1/VKR/3d/Сидение/Изножье/Педаль.SLDPRT

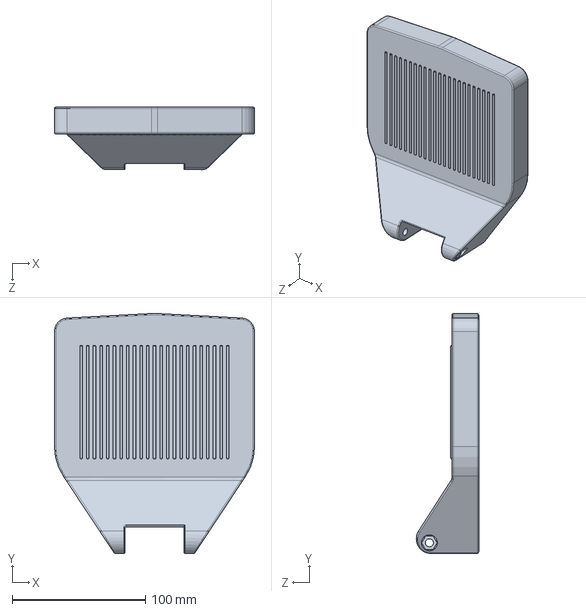
[picture p97: CAD file, 2025-03-10]
3d/Сидение/Изножье/Педаль.SLDPRT
150.0 x 179.9 x 46.9 mm
