DmitriyKalashnikov1/VKR/Programs/IsaakSim/BigWheel.SLDPRT

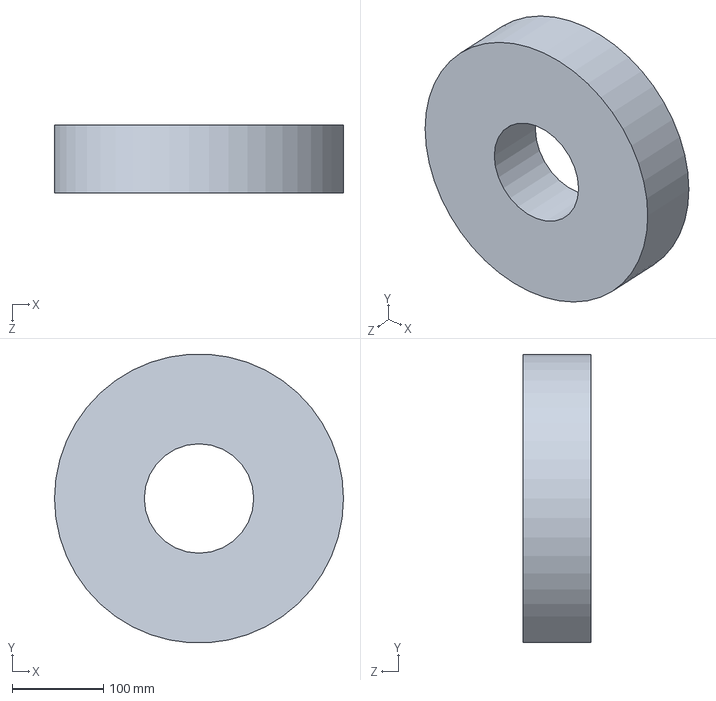
[picture p98: CAD file, 2025-06-17]
Programs/IsaakSim/BigWheel.SLDPRT
317.0 x 316.3 x 75.0 mm
