DmitriyKalashnikov1/VKR/Programs/IsaakSim/PrimeChair/meshes/NLB.STL

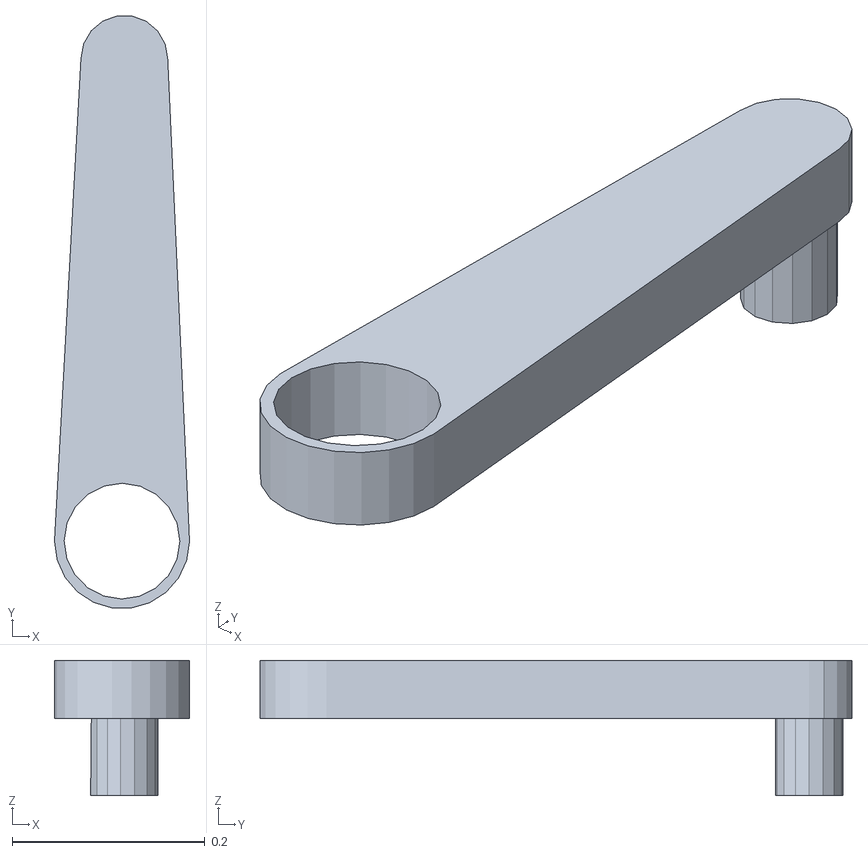
[picture p99: CAD file, 2025-06-17]
Programs/IsaakSim/PrimeChair/meshes/NLB.STL
0.14 x 0.614 x 0.14
