DmitriyKalashnikov1/VKR/3d/rpi2-top.stp

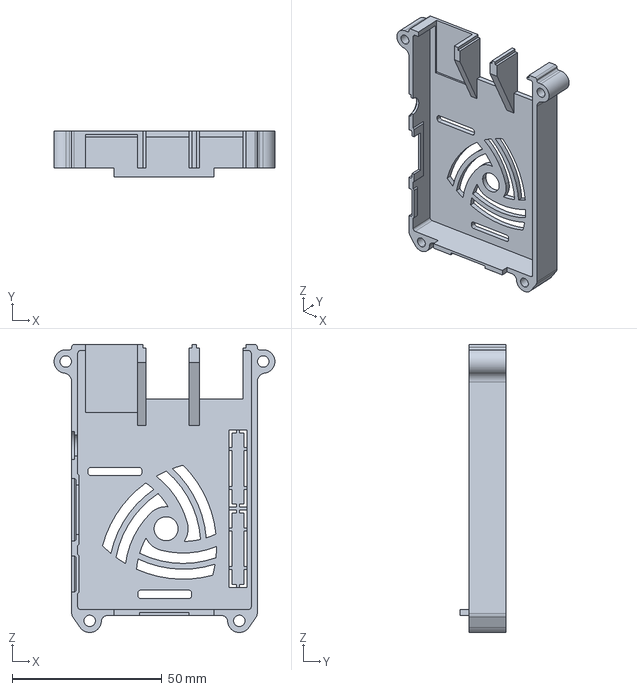
[picture p100: CAD file, 2025-03-05]
3d/rpi2-top.stp
73.8 x 15.5 x 96.2 mm
