DmitriyKalashnikov1/VKR/3d/Сидение/Втулка спинки-1.SLDPRT

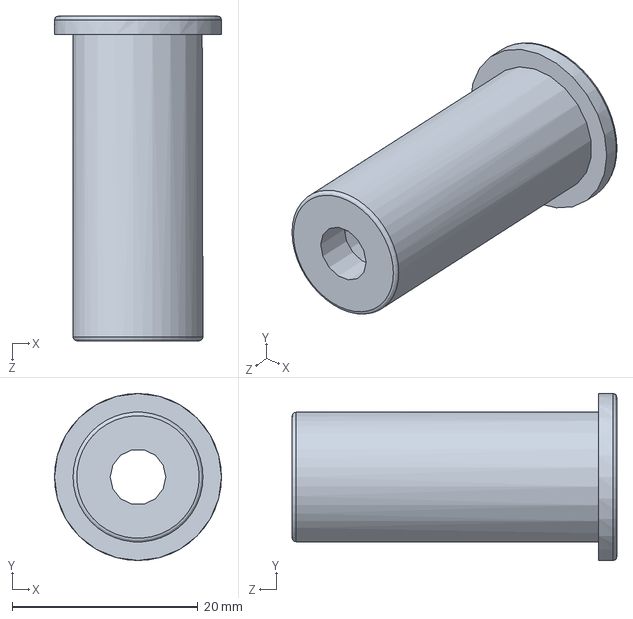
[picture p101: CAD file, 2025-03-10]
3d/Сидение/Втулка спинки-1.SLDPRT
18.0 x 18.0 x 35.0 mm
