DmitriyKalashnikov1/VKR/Programs/IsaakSim/PrimeChair/meshes/LB.STL

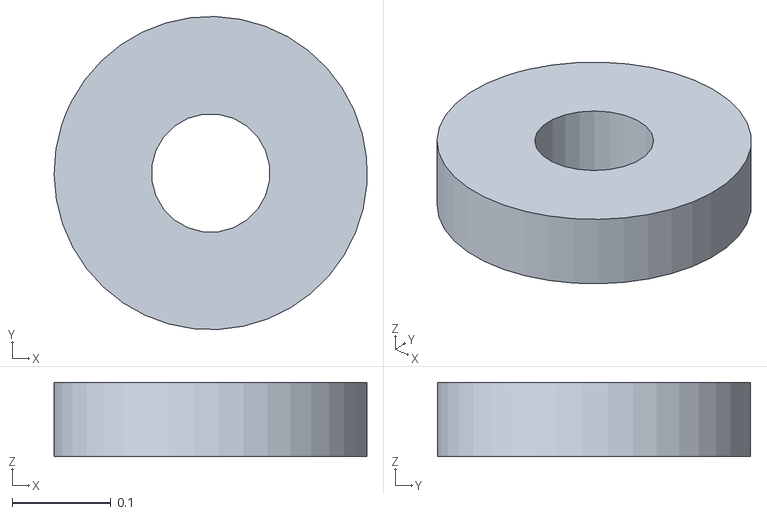
[picture p102: CAD file, 2025-06-17]
Programs/IsaakSim/PrimeChair/meshes/LB.STL
0.317 x 0.317 x 0.075
