DmitriyKalashnikov1/VKR/3d/rpi3-bottom.stp

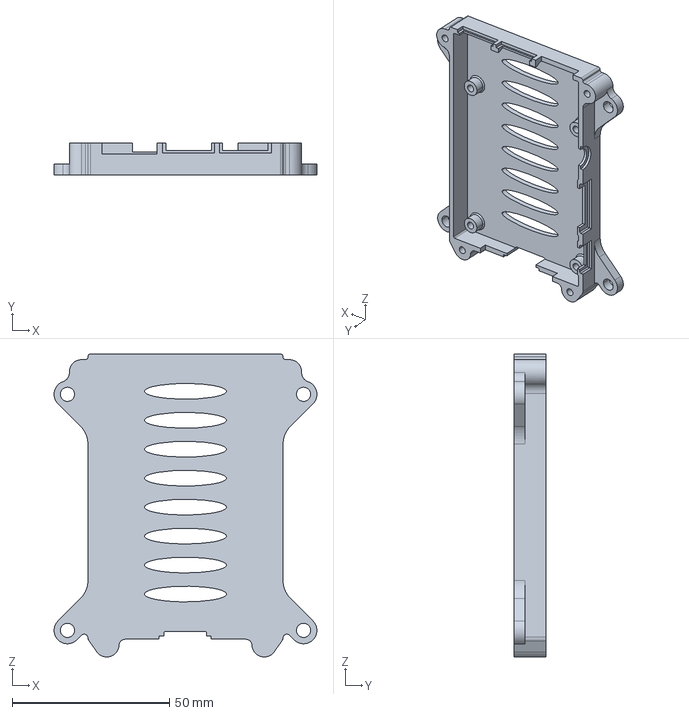
[picture p103: CAD file, 2025-03-05]
3d/rpi3-bottom.stp
83.5 x 10.3 x 96.2 mm
