DmitriyKalashnikov1/VKR/3d/Сидение/Труба спинки-1.SLDPRT

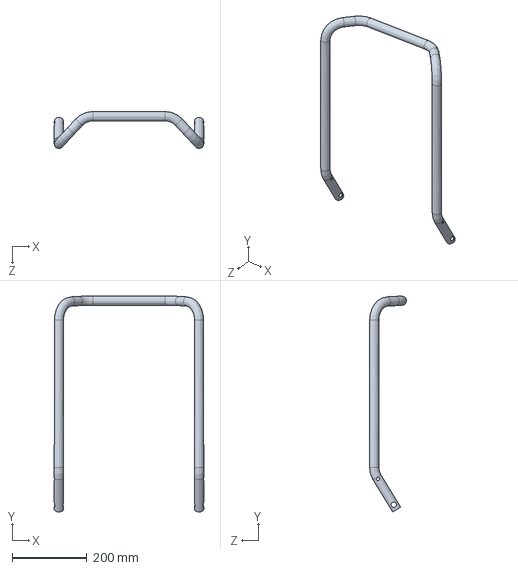
[picture p104: CAD file, 2025-03-10]
3d/Сидение/Труба спинки-1.SLDPRT
398.9 x 576.2 x 98.7 mm
