DmitriyKalashnikov1/VKR/Programs/IsaakSim/base.SLDPRT

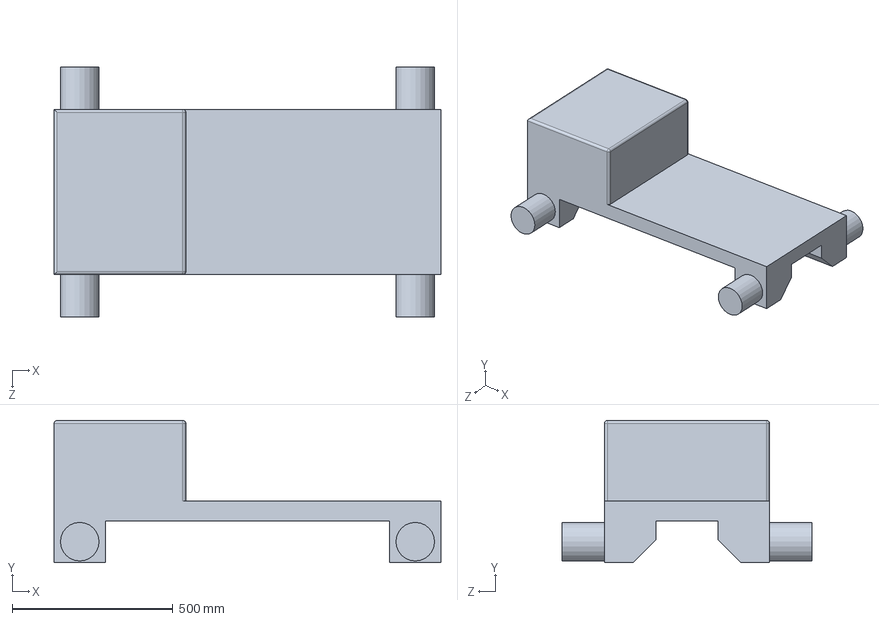
[picture p105: CAD file, 2025-06-17]
Programs/IsaakSim/base.SLDPRT
1203.0 x 442.0 x 778.0 mm
