DmitriyKalashnikov1/VKR/3d/Сидение/Труба спинки-2.SLDPRT

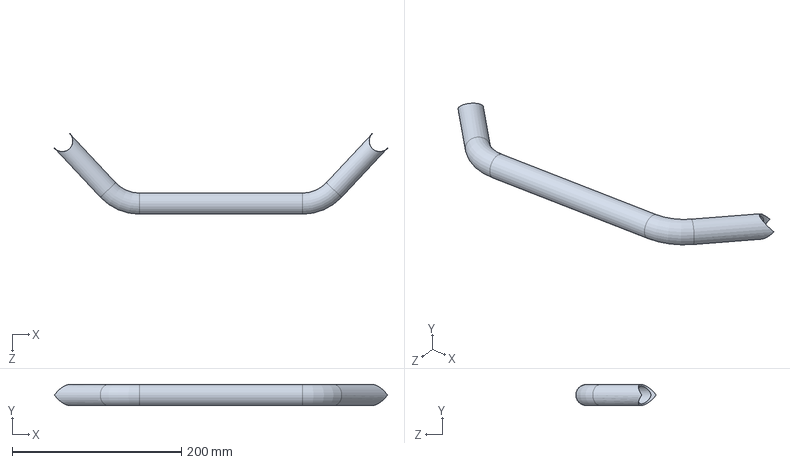
[picture p106: CAD file, 2025-03-10]
3d/Сидение/Труба спинки-2.SLDPRT
393.6 x 25.0 x 95.0 mm
