DmitriyKalashnikov1/VKR/Programs/IsaakSim/Noga.SLDPRT

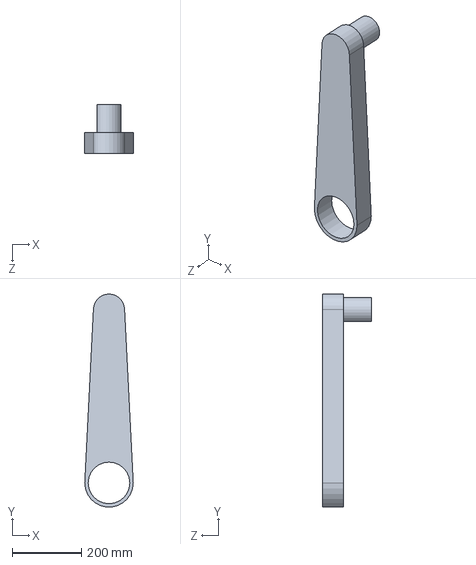
[picture p107: CAD file, 2025-06-17]
Programs/IsaakSim/Noga.SLDPRT
140.0 x 614.5 x 140.0 mm
