DmitriyKalashnikov1/VKR/Programs/IsaakSim/SmallWheel.SLDPRT

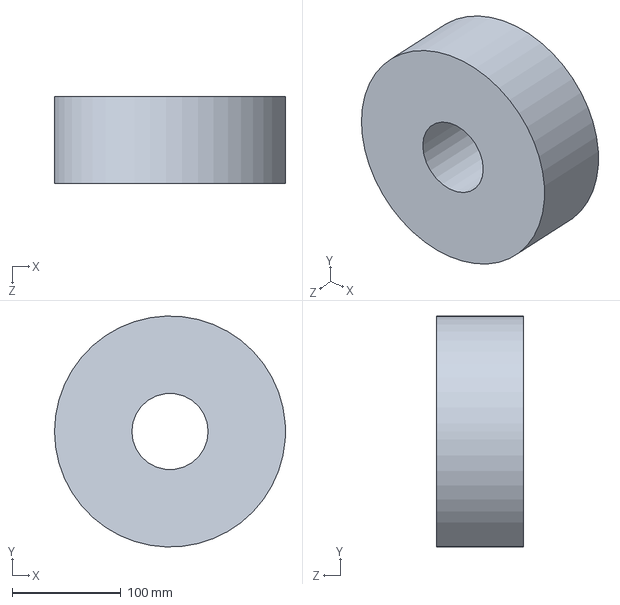
[picture p108: CAD file, 2025-06-17]
Programs/IsaakSim/SmallWheel.SLDPRT
212.0 x 211.9 x 80.0 mm
