DmitriyKalashnikov1/VKR/Programs/IsaakSim/baseBordur.SLDPRT

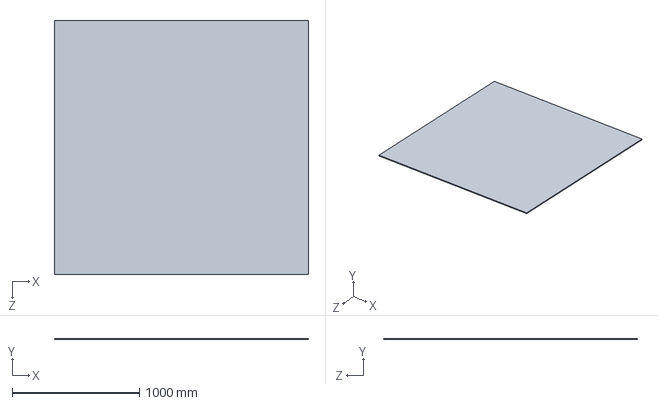
[picture p109: CAD file, 2025-06-17]
Programs/IsaakSim/baseBordur.SLDPRT
2000.0 x 10.0 x 2000.0 mm
