DmitriyKalashnikov1/VKR/Programs/IsaakSim/PrimeChair/meshes/SLB.STL

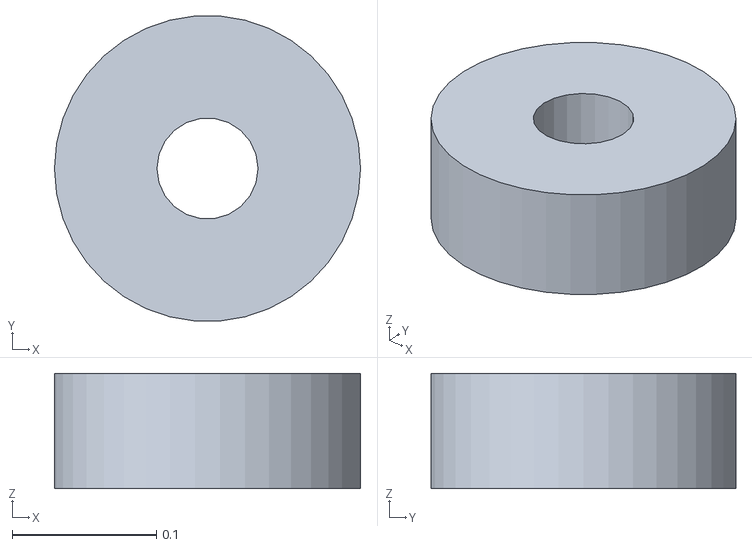
[picture p110: CAD file, 2025-06-17]
Programs/IsaakSim/PrimeChair/meshes/SLB.STL
0.212 x 0.211 x 0.08
