DmitriyKalashnikov1/VKR/Programs/IsaakSim/PrimeChair/meshes/base_link.STL

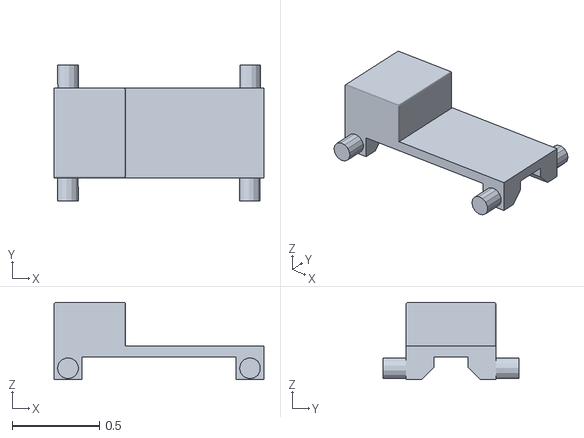
[picture p111: CAD file, 2025-06-17]
Programs/IsaakSim/PrimeChair/meshes/base_link.STL
1.20 x 0.778 x 0.442
