DmitriyKalashnikov1/VKR/(list of files, cad)

Other CAD files:
Programs/IsaakSim/PrimeChair/meshes/RF.STL
Programs/IsaakSim/PrimeChair/meshes/NRB.STL
Programs/IsaakSim/PrimeChair/meshes/NLF.STL
Programs/IsaakSim/PrimeChair/meshes/RB.STL
Programs/IsaakSim/PrimeChair/meshes/SRF.STL
Programs/IsaakSim/PrimeChair/meshes/NRF.STL
Programs/IsaakSim/PrimeChair/meshes/SRB.STL
