DmitriyKalashnikov1/VKR/Altium/Joystick/Joystick.pdf

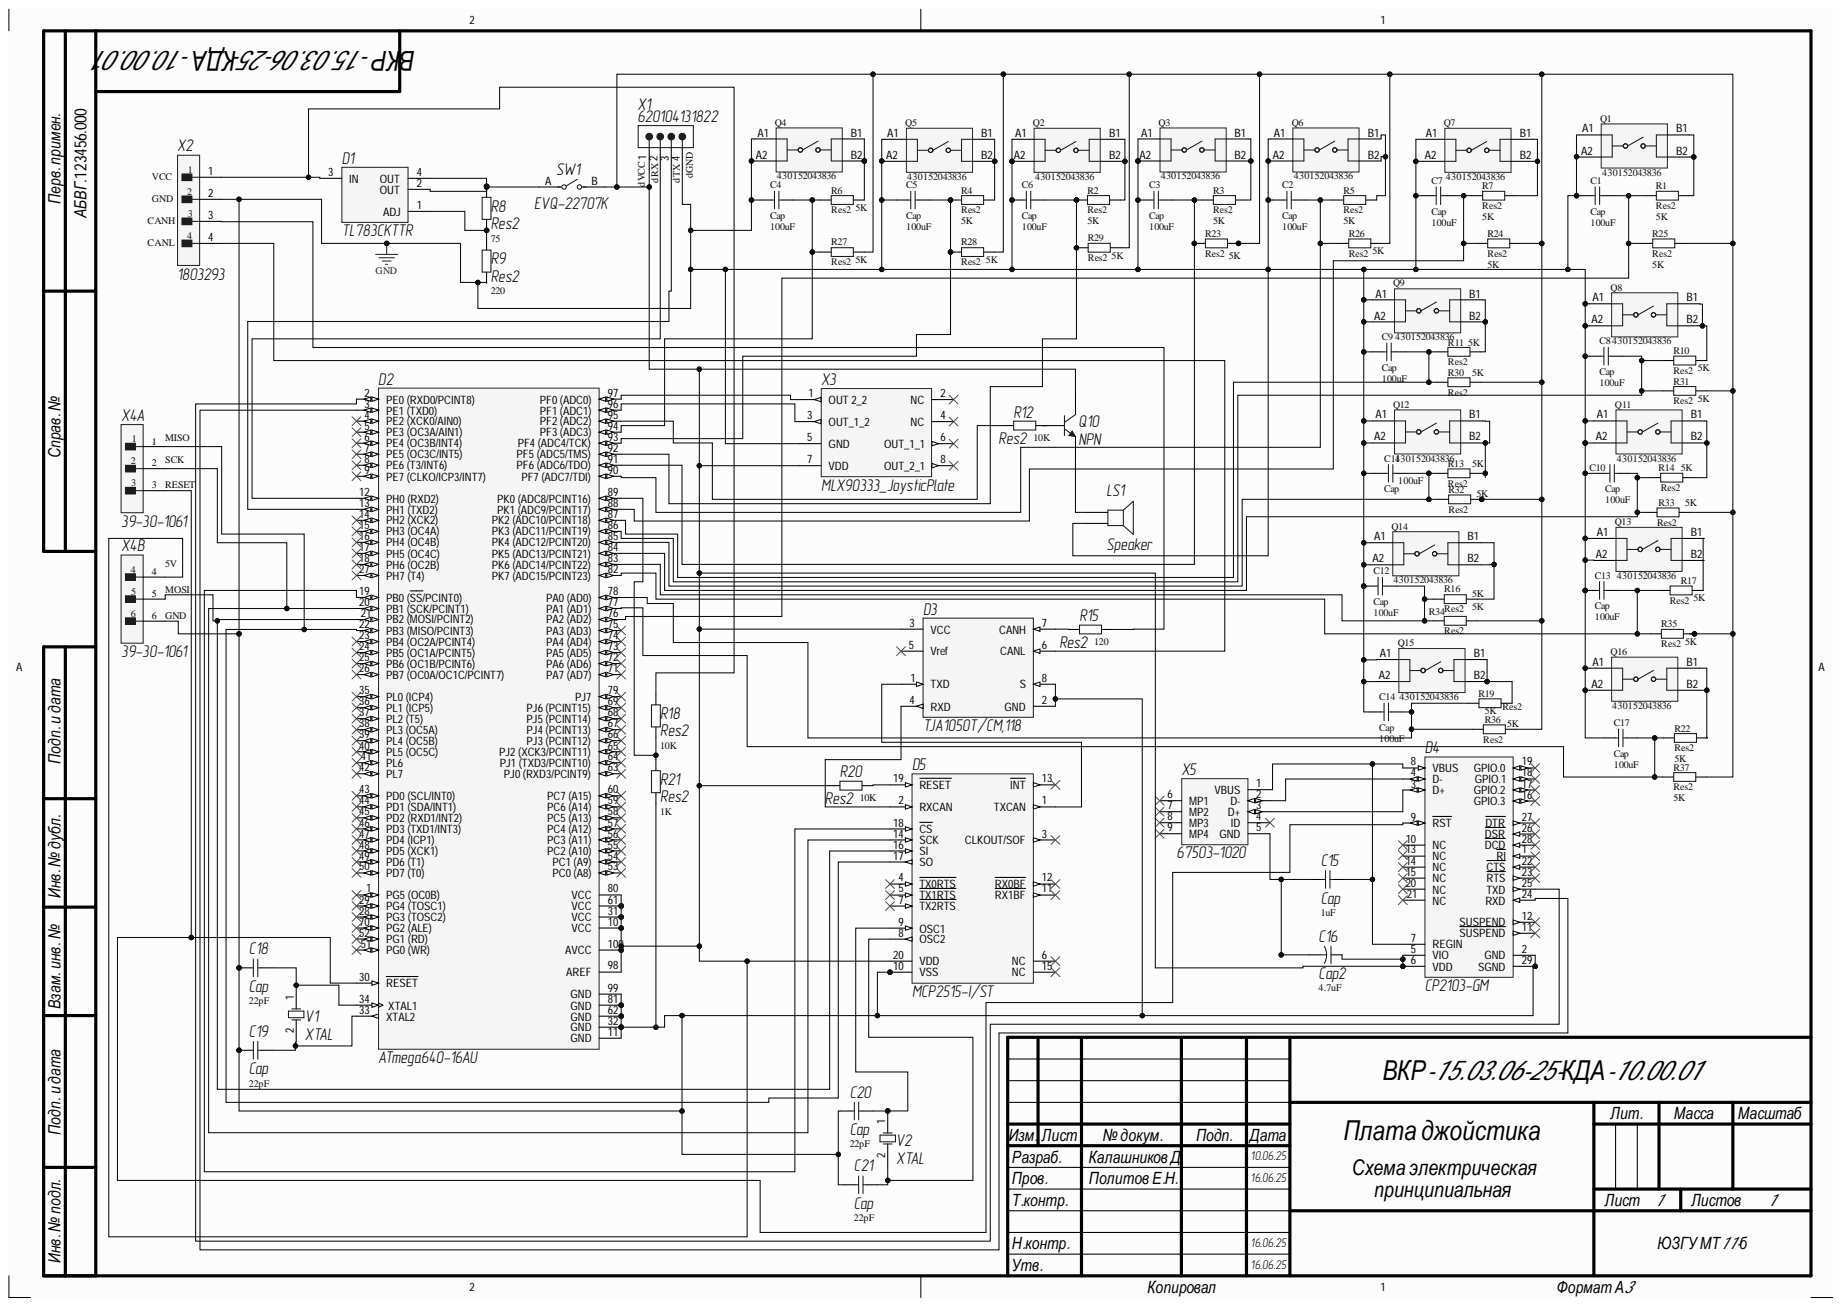
[picture p112: page 1]

Инв. №подл. Инв. № дубл. Подп. и дата Взам. инв. № Подп. и дата Перв. примен. Справ.№

XTAL2 33

XTAL

ВКР-15.03.06-25-КДА-10.00.01

Плата джойстика Схема электрическая принципиальная | Лит. | Масса | Масштаб

Изм. | Лист | № докум. | Подп. | Дата
Разраб. | | Калашников Д | | 10.06.25
Пров. | | Политов Е.Н. | | 16.06.25

Н.контр. | 16.06.25
Утв. | 16.06.25

ЮЗГУМТ11-б
