DmitriyKalashnikov1/VKR/Altium/NavigationUnit/NavigationUnit.pdf

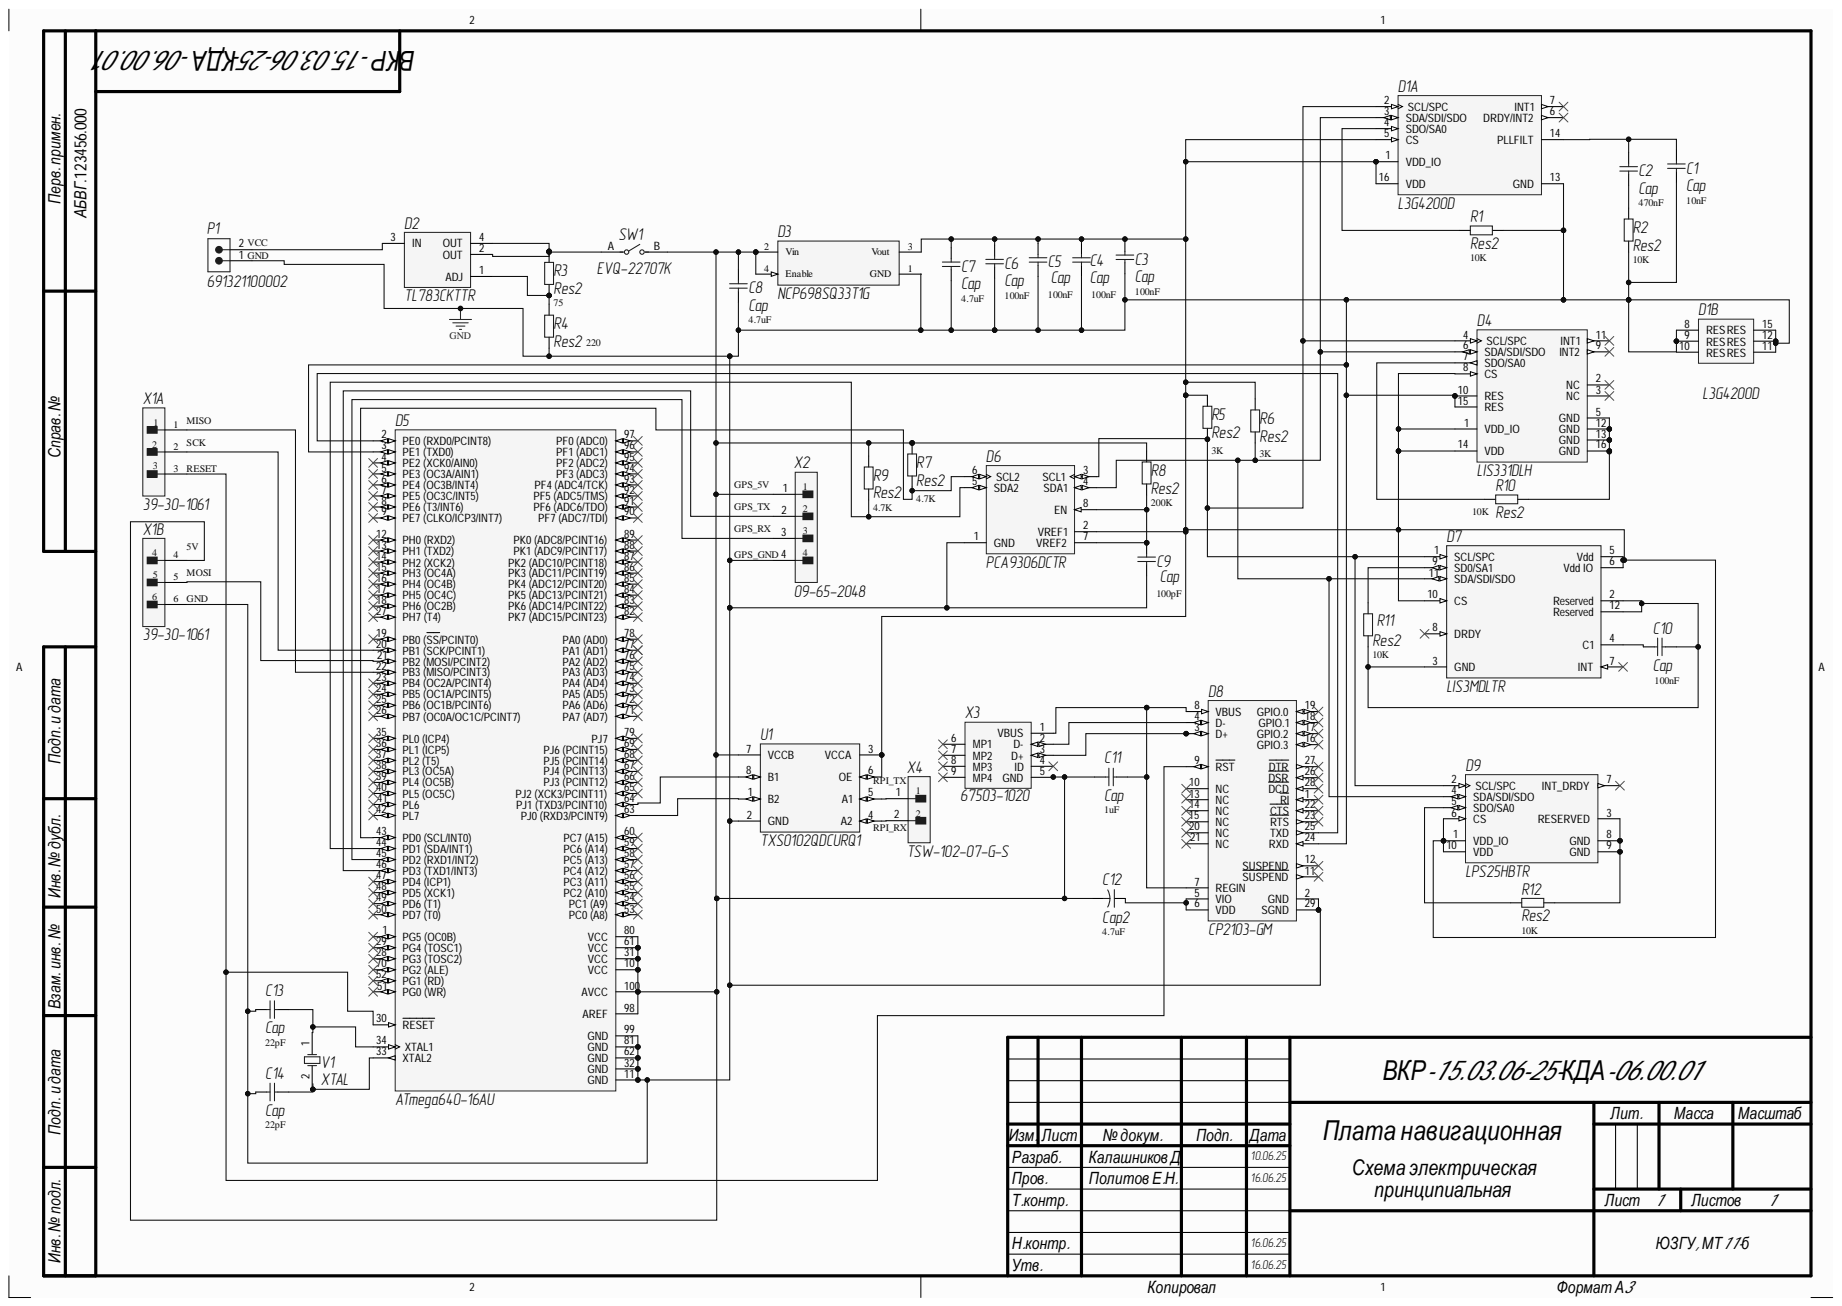
[picture p113: page 1]

Инв. №подл. Инв. № дубл. Подп. и дата Взам. инв. № Подп. и дата Перв. примен. Справ.№

SDO/SA0 4
CS 5

VDD_IO 1

VDD 16

C8 | NCP698SQ33T1G
Cap 4.7uF | 4.7uF | D4 | D1B

SDA/SDI/SDO 6

RES 15

ВКР-15.03.06-25-КДА-06.00.01

Cap 22pF

Плата навигационная Схема электрическая принципиальная | Лит. | Масса | Масштаб

Изм. | Лист | № докум. | Подп. | Дата
Разраб. | | Калашников Д | | 10.06.25
Пров. | | Политов Е.Н. | | 16.06.25
Т.контр. | | | | | Лист 1 | Листов 1

Н.контр. | 16.06.25
Утв. | 16.06.25

ЮЗГУ, МТ11-б
