DmitriyKalashnikov1/VKR/(list of files, drawings)

Other design files:
Altium/Joystick/Joystick.PcbDoc
Altium/Joystick/Joystick.PrjPcb
Altium/Joystick/Joystick.SchDoc
Altium/Joystick/Joystiks.PcbLib
Altium/Joystick/Joystiks.SchLib
Altium/NavigationUnit/NavigationUnit.PcbDoc
Altium/NavigationUnit/NavigationUnit.PrjPcb
Altium/NavigationUnit/NavigationUnit.SchDoc
