DmitriyKalashnikov1/VKR/(commit log)

2024-04-13 add BCMotor setup pid model
2024-08-27 adding motors models
    [CyberGearmotor.stp]
2024-11-06 proectirovanie kursach 061124
    [CyberGearmotor.stp]
2024-12-01 исправление привода внешнего и центрального валов
2024-12-02 03-12-2024
    изменен привод внутреннего вала (найдена ошибка в позиционировании. не исправлена)
2024-12-03 04-12-2024 привод среднего вала
    Переделал крепление и привод мотора среднего вала. установил все в коробку
2024-12-08 исправления 08-12 (1)
    Прокладка корпуса 1 и крепление подшипника
2024-12-08 08-12 (2)
    положение корпус передачи 2
2024-12-17 17-12-2024 резьба и натяжитель
    резьба и натяжитель
2025-02-26 260225, privod vnutrennezo vala izmenen pod motor constar
2025-02-28 уменьшение размера крепления
    28-02-2025
2025-03-16 Update Коляска в сборе (16-03-2025 (4))
